igmarkies/Enviroment-System/PCB/Meetmodule V2.8/Meetmodule V3 Top-display.jpg

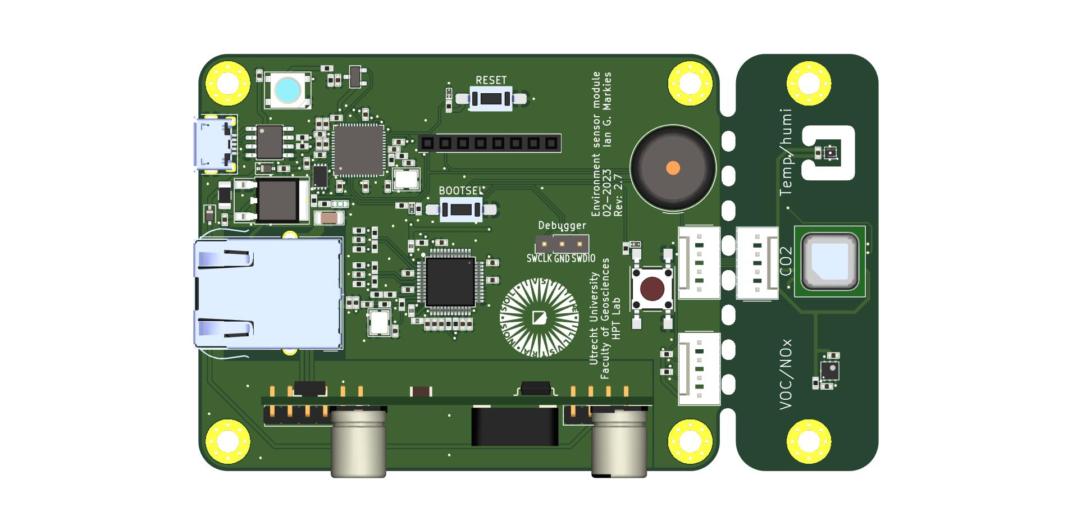
PCB/Meetmodule V2.8/Meetmodule V3 Top-display.jpg
