igmarkies/Enviroment-System/README.txt

The codes in the folder "Final" are the latest version.
The file "network.py" and "ssd1306.py" is not of my own creation but is necassary for the function of the "main.py" code
