igmarkies/Enviroment-System/PCB/PDF Bestellijst.pdf

Index | Quantity | Part Number | Description | Unit Price | Extended Price EUR
1 | 5 256-W25Q16JVUXIQTRCT-ND | IC FLASH 16MBIT SPI/QUAD 8USON | 0,57 | 2,85
2 | 5 2648-SC0914(13)CT-ND | RP2040TR13 | 0,96 | 4,8
3 | 5 2N7002NCT-ND | MOSFET N-CH 60V 115MA SOT-23 | 0,37 | 1,85
4 | 5 1278-W5100S-LCT-ND | IC ETHERNET CNTRLR SPI 48LQFP | 3,58 | 17,9
5 | 5 SER4211CT-ND | CRYSTAL 25.0000MHZ 18PF SMD | 0,41 | 2,05
6 | 5 2057-MCR-B-S-RA-SMT-CS14-T/RCT-ND | MICRO USB, RIGHT ANGLE, SURFACE | 0,38 | 1,9
7 | 5 3997-C3E-12.000-18-1020-X-RCT-ND | CRYSTAL 12MHZ 18PF SMD | 0,42 | 2,1
8 | 5 1649-SHT41-AD1B-R2CT-ND | SENSOR HUMID/TEMP | 3,124 | 15,62
9 | 5 535-14168-ND | CONN JACK 1PORT 100 BASE-T PCB | 3,34 | 16,7
10 | 5 1497-1448-1-ND | LED RED CLEAR CHIP SMD | 0,49 | 2,45
11 | 10 CKN12317-1-ND | TACT 6.0 X 3.5, 4.3 MM H, 180GF, | 0,14 | 1,4
12 | 15 445-2981-1-ND | FERRITE BEAD 120 OHM 0402 1LN | 0,073 | 1,1
13 | 5 4587-C1206X102K202TCT-ND | CAP CER 1000PF 2KV X7R 1206 | 0,16 | 0,8
14 | 5 497-3281-1-ND | TVS DIODE 5.25VWM 8-SO | 1,68 | 8,4
15 | 15 SZESD9B3.3ST5GOSCT-ND | TVS DIODE 3.3VWM 11.5VC SOD923 | 0,288 | 4,32
16 | 10 BAT60AE6327HTSA1CT-ND | DIODE SCHOTTKY 10V 3A SOD323-2 | 0,394 | 3,94
17 | 5 1649-SGP41-D-R4CT-ND | AIR QUALITY GAS SENSOR VOC/NO | 8,318 | 41,59
18 | 5 1568-COM-16347CT-ND | SMD LED RGB WS2812B | 0,56 | 2,8
19 | 5 486-3690-ND | SWITCH TACTILE SPST-NO 0.05A 12V | 0,24 | 1,2
20 | 5 541-4.70LCT-ND | RES SMD 4.7 OHM 1% 1/16W 0402 | 0,1 | 0,5
21 | 20 13-AF0402FR-0749R9LCT-ND | RES SMD 49.9 OHM 1% 1/16W 0402 | 0,051 | 1,02
22 | 5 RMCF0402ZT0R00CT-ND | RES 0 OHM JUMPER 1/16W 0402 | 0,1 | 0,5
23 | 5 13-RT0402FRE07300RLCT-ND | RES SMD 300 OHM 1% 1/16W 0402 | 0,1 | 0,5
24 | 5 541-CRCW04021M00FKEECT-ND | RES SMD 1M OHM 1% 1/16W 0402 | 0,1 | 0,5
25 | 20 311-3.30LRCT-ND | RES 3.3 OHM 1% 1/16W 0402 | 0,021 | 0,42
26 | 5 13-AF0402FR-0712KLCT-ND | RES SMD 12K OHM 1% 1/16W 0402 | 0,1 | 0,5
27 | 10 YAG1254CT-ND | RES SMD 1K OHM 1% 1/16W 0402 | 0,03 | 0,3
28 | 15 13-AF0402FR-07470RLCT-ND | RES SMD 470 OHM 1% 1/16W 0402 | 0,051 | 0,77
29 | 5 541-CRCW0402100KFKEECT-ND | RES SMD 100K OHM 1% 1/16W 0402 | 0,1 | 0,5
30 | 5 311-200KLRCT-ND | RES 200K OHM 1% 1/16W 0402 | 0,1 | 0,5
31 | 10 YAG5278CT-ND | RES SMD 27 OHM 1% 1/16W 0402 | 0,018 | 0,18
32 | 125 311-1731-1-ND | CAP CER 0.1UF 10V X5R 0402 | 0,0093 | 1,16
33 | 10 490-13238-1-ND | CAP CER 10UF 6.3V X5R 0402 | 0,11 | 1,1
34 | 10 732-7426-1-ND | CAP CER 15PF 10V C0G/NP0 0402 | 0,018 | 0,18
35 | 35 587-6273-1-ND | CAP CER 1UF 6.3V X5R 0402 | 0,033 | 1,16
36 | 10 720-VJ0402A180KXQCW1BCCT-ND | CAP CER 18PF 10V C0G/NP0 0402 | 0,079 | 0,79
37 | 5 668-1470-ND | BUZZER MAGNETIC 5V 12MM TH | 0,53 | 2,65
38 | 15 13-AF0402FR-07100RLCT-ND | RES SMD 100 OHM 1% 1/16W 0402 | 0,051 | 0,77
39 | 5 NCP1117DT33GOS-ND | IC REG LINEAR 3.3V 1A DPAK | 0,73 | 3,65
40 | 5 311-4.7KLRCT-ND | RES 4.7K OHM 1% 1/16W 0402 | 0,1 | 0,5
Totaal | | | | | 151,92
