igmarkies/Enviroment-System/PCB/MCU.png

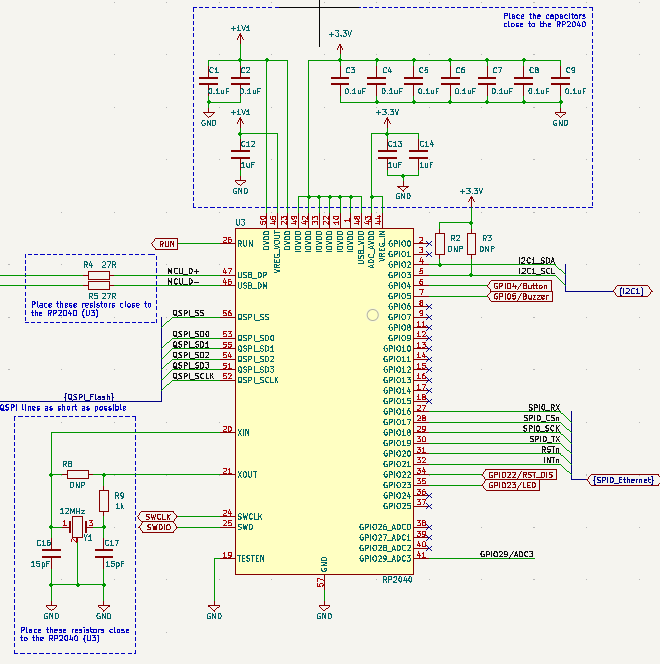
PCB/MCU.png
