igmarkies/Enviroment-System/PCB/Meetmodule case/Meetmodule V3 Top.jpg

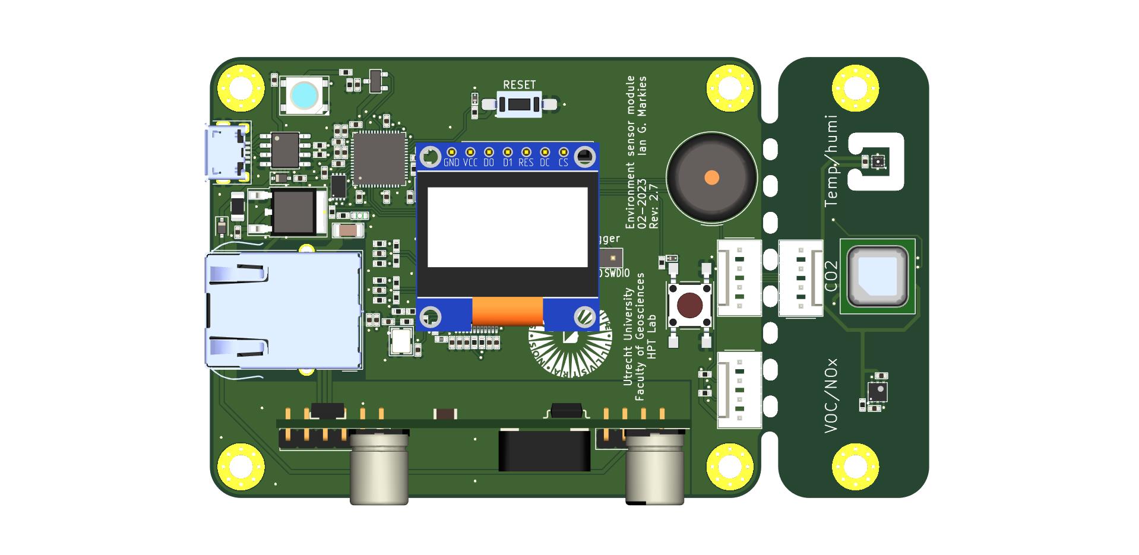
PCB/Meetmodule case/Meetmodule V3 Top.jpg
