igmarkies/Enviroment-System/Sensor module/Final/Flowcharts/Hoofdmodule.jpg

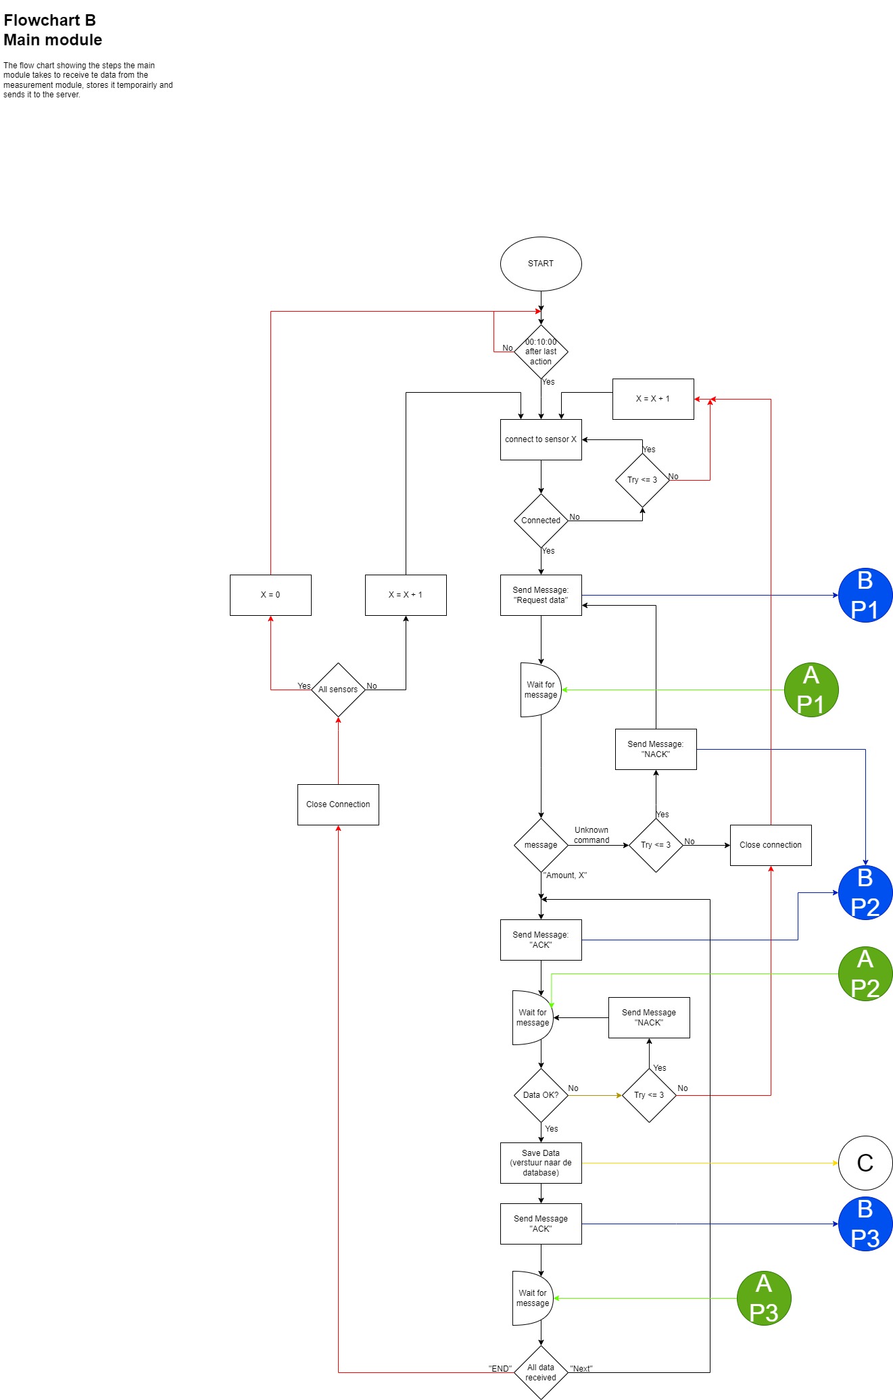
Sensor module/Final/Flowcharts/Hoofdmodule.jpg
