igmarkies/Enviroment-System/Sensor module/Final/Flowcharts/Meetmodule.jpg

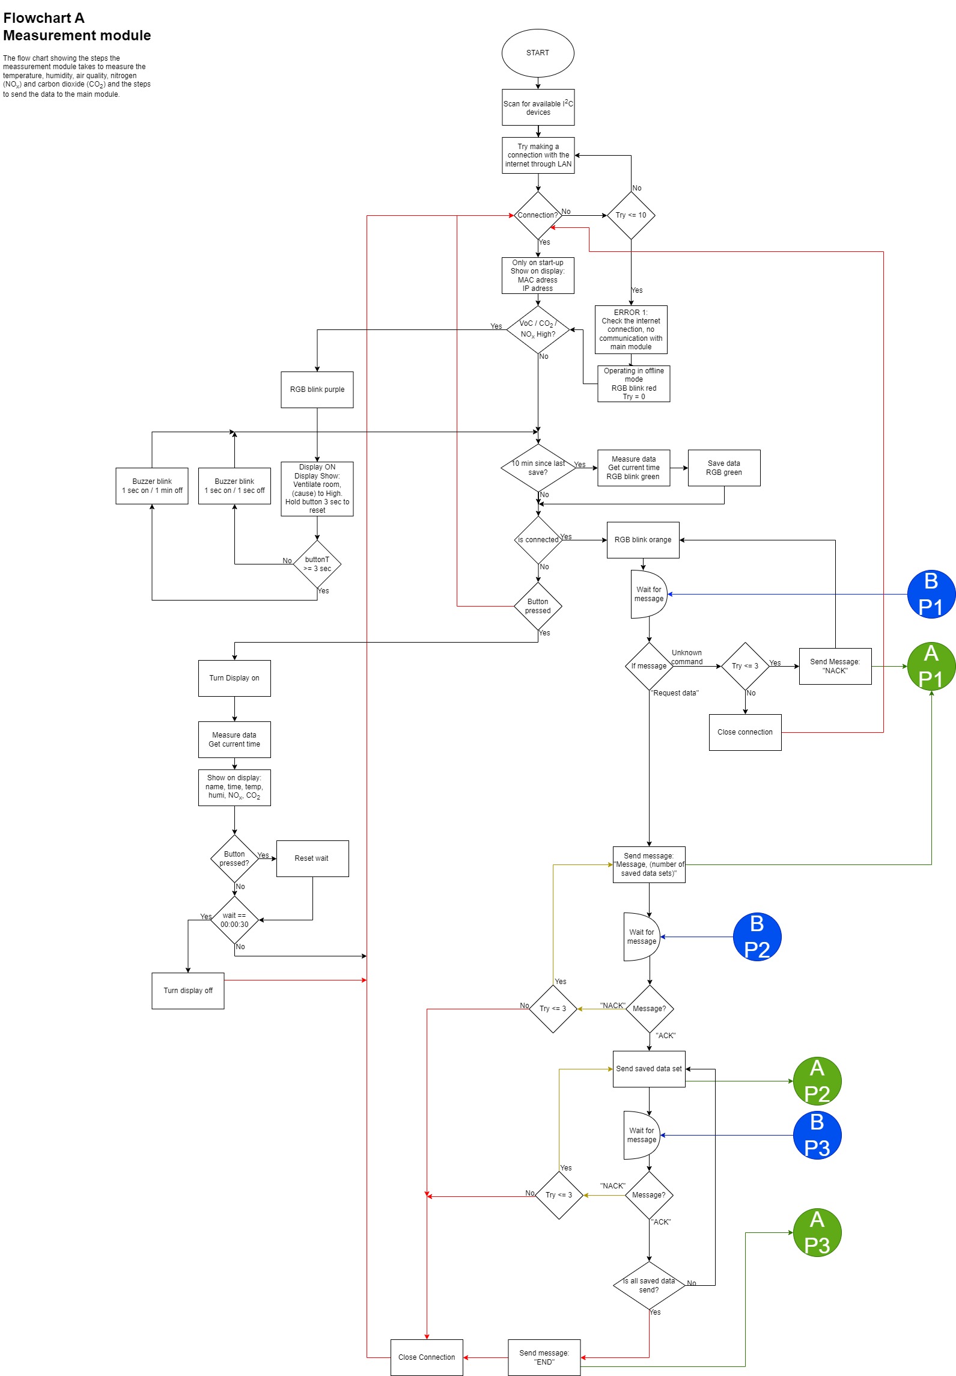
Sensor module/Final/Flowcharts/Meetmodule.jpg
