igmarkies/Enviroment-System/PCB/Meetmodule case/Meetmodule sensorcase.step

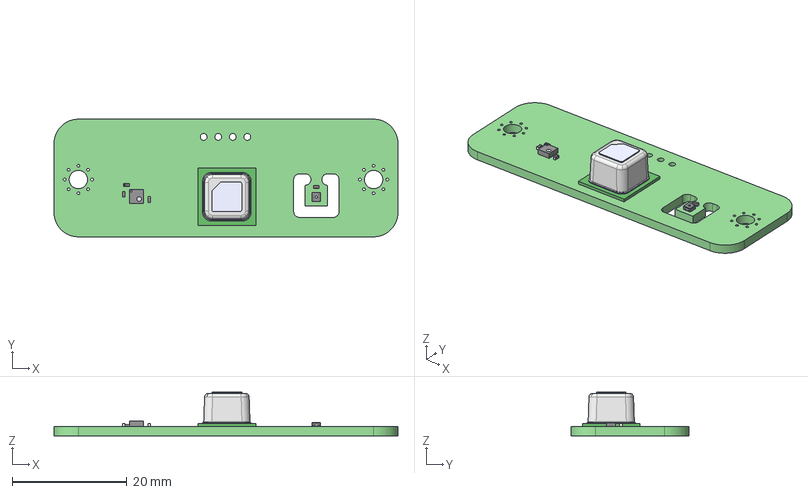
[picture p6: CAD file, 2023-08-22]
PCB/Meetmodule case/Meetmodule sensorcase.step
60.0 x 20.5 x 7.67 mm
_autosave-Meetmodule V3 PCB
