igmarkies/Enviroment-System/PCB/Meetmodule large display V2.4/Meetmodule large display V2.4.step

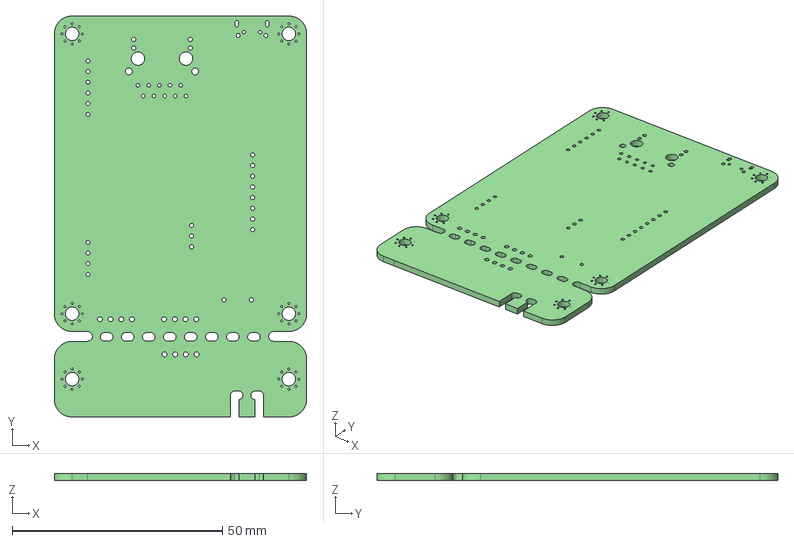
[picture p7: CAD file, 2023-08-22, an earlier design]
PCB/Meetmodule large display V2.4/Meetmodule large display V2.4.step
60.0 x 95.3 x 1.64 mm
