igmarkies/Enviroment-System/Main module/Gegevens huidige installatie hoofdmodule.txt

Hoofdmodule
Gebruikersnaam: rock
Wachtwoord: rock

MySQL
Gebruikersnaa: HPTuser
wachtwoord: Pr3Ssure#h19h

Wordpress
gebruikersnaam: HPT-admin
Wachtwoord: W0rD#49i^HPT
