igmarkies/Enviroment-System/Sensor module/Final/Flowcharts/Ontwerp Hoofdmodule A3.pdf

# Flowchart B Main module

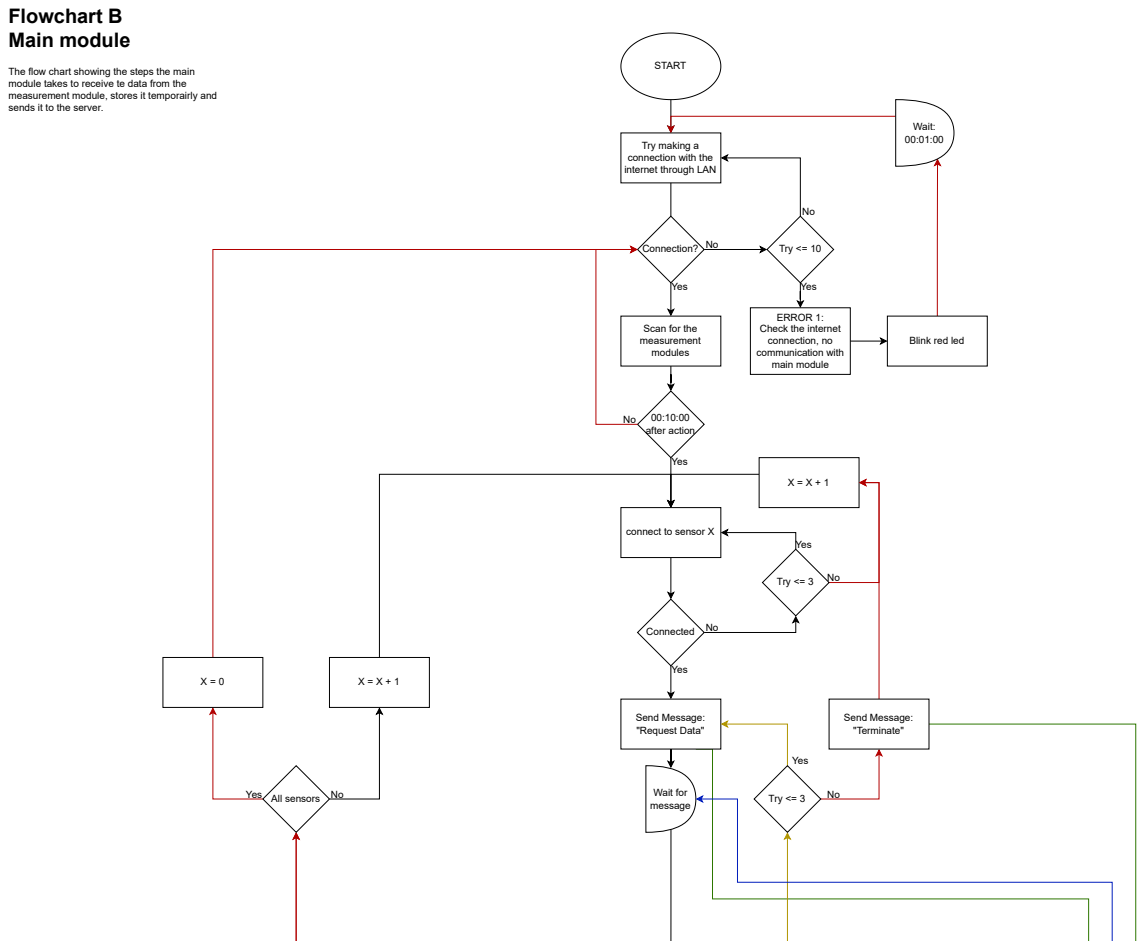
[picture p8: page 1]
START; Yes; Connection?; Try <= 10; 00:10:00 after action; Connected; Try <= 3; Send Message: "Request Data"; Wait for message; Send Message: "Terminate"; Wait: 00:01:00; All sensors

The flow chart showing the steps the main
module takes to receive te data from the
measurement module, stores it temporairly and
sends it to the server.

Try making a
connection with the
internet through LAN

ERROR 1:
Check the internet
connection, no
communication with
main module

Scan for the
measurement
modules

Blink red led

connect to sensor X

A

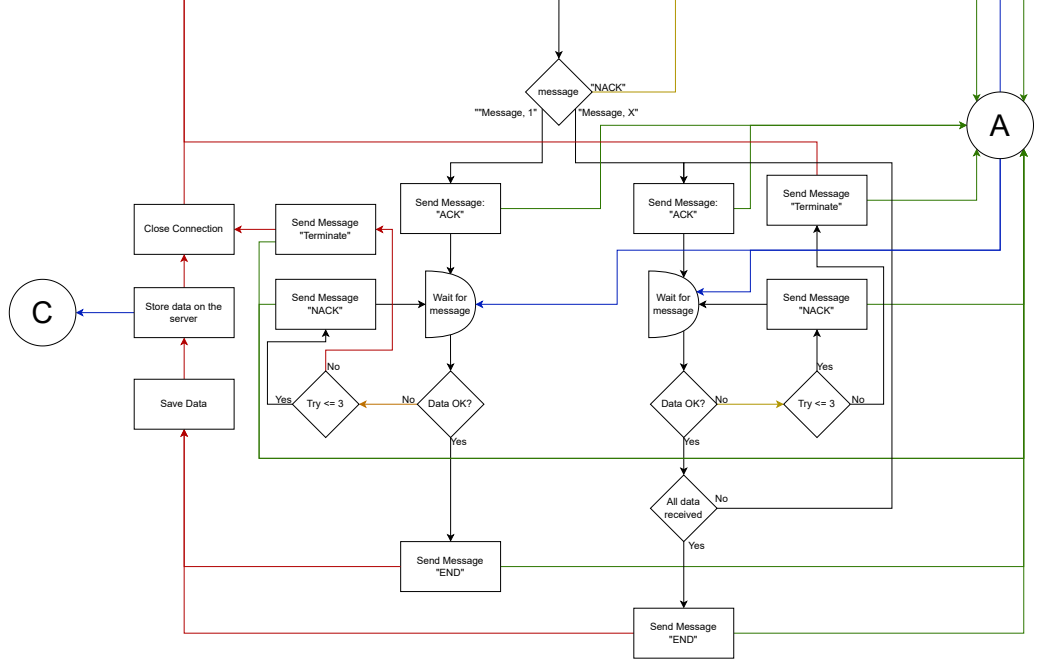
[picture p9: page 2]
message; Send Message: "ACK"; ""Message, 1"; "Message, X"; "NACK"; Wait for message; Data OK?; Send Message "NACK"; Try <= 3; Yes; Send Message; Send Message "END"; Send Message "Terminate"; All data received; Save Data; Store data on the C; server

"Terminate" Close Connection
