igmarkies/Enviroment-System/Sensor module/Final/Flowcharts/Ontwerp Meetmodule A3.pdf

# Flowchart A Measurement module

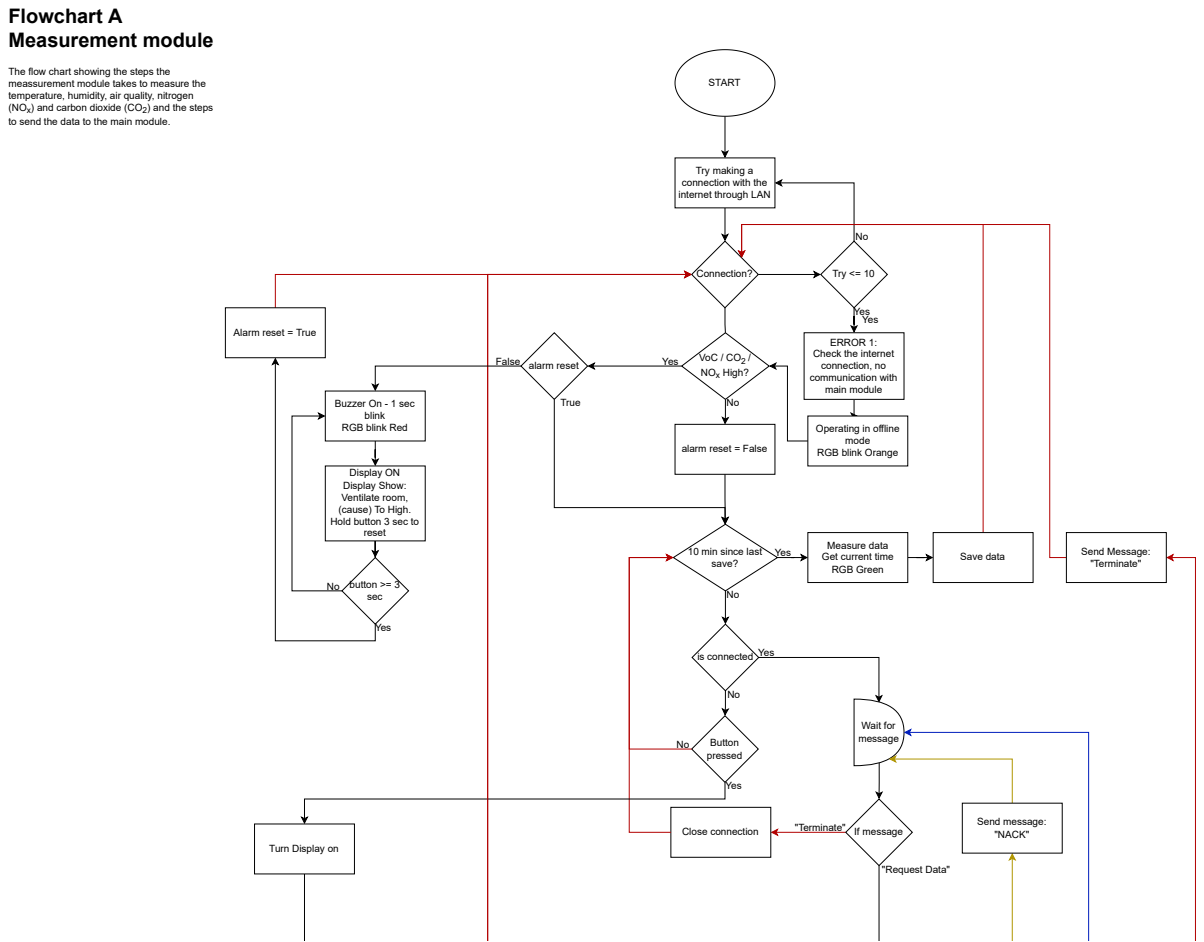
[picture p10: page 1]
START; Button pressed; Yes; Wait for message; If message; "Request Data"; Close connection; "Terminate"; Connection?; Try <= 10; Send Message: "Terminate"; Save data; is connected; button >= 3 sec; reset; alarm reset; True; False; VoC / CO2; / NOx High?; Send message: "NACK"

The flow chart showing the steps the
meassurement module takes to measure the
temperature, humidity, air quality, nitrogen
(NOx
to send the data to the main module.

) and carbon dioxide (CO2

) and the steps

Try making a
connection with the
internet through LAN

Alarm reset = True

ERROR 1:
Check the internet
connection, no
communication with
main module

Buzzer On - 1 sec
blink
RGB blink Red

Operating in offline
mode
RGB blink Orange

alarm reset = False

Display ON
Display Show:
Ventilate room,
(cause) To High.
Hold button 3 sec to

Measure data
Get current time
RGB Green

10 min since last
save?

Turn Display on

B

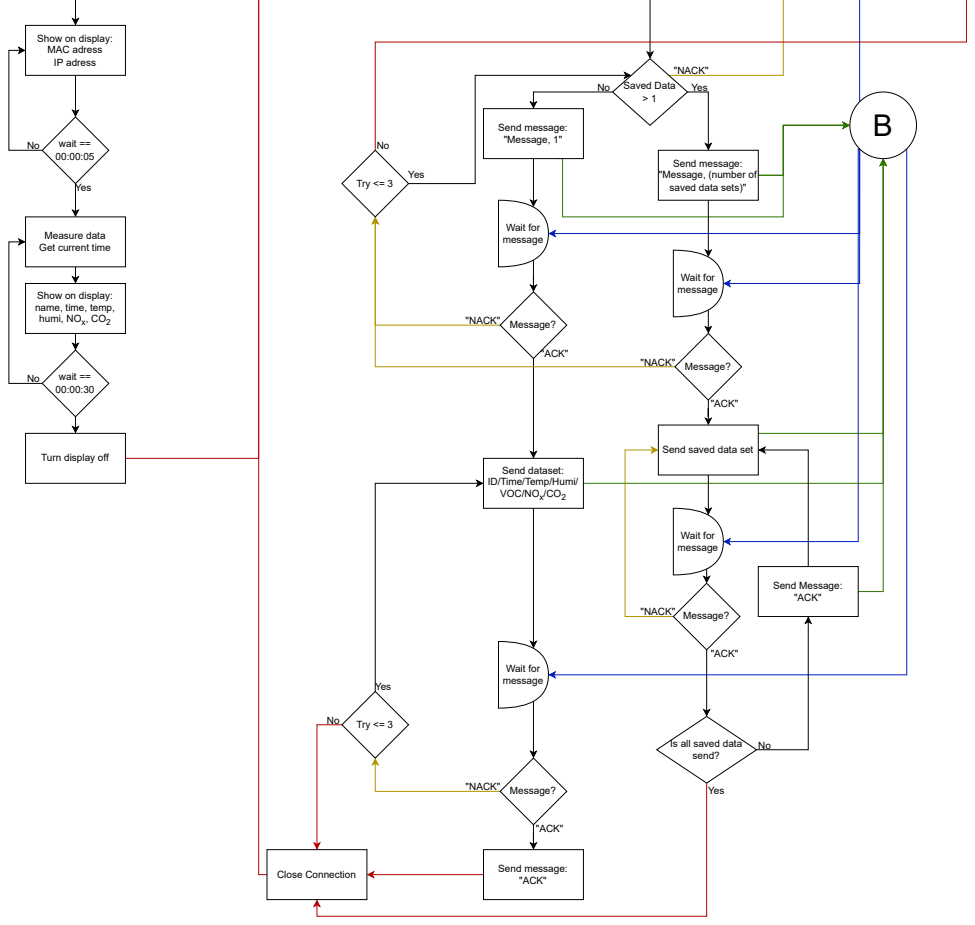
[picture p11: page 2]
Saved Data > 1; Send message: "Message, 1"; Yes; Message?; "ACK"; Message? "NACK"; Try <= 3; "NACK"; Send message: "ACK"; Close Connection; wait == 00:00:05; wait == 00:00:30; Send Message: "ACK"; Wait for message

Show on display:
MAC adress
IP adress

Send message:
"Message, (number of
saved data sets)"

Measure data
Get current time

name, time, temp,
humi, NOx

Send saved data set

Turn display off

Send dataset:
ID/Time/Temp/Humi/
VOC/NOx

Is all saved data
send?
