igmarkies/Enviroment-System/PCB/Meetmodule case/PCB design large.pdf

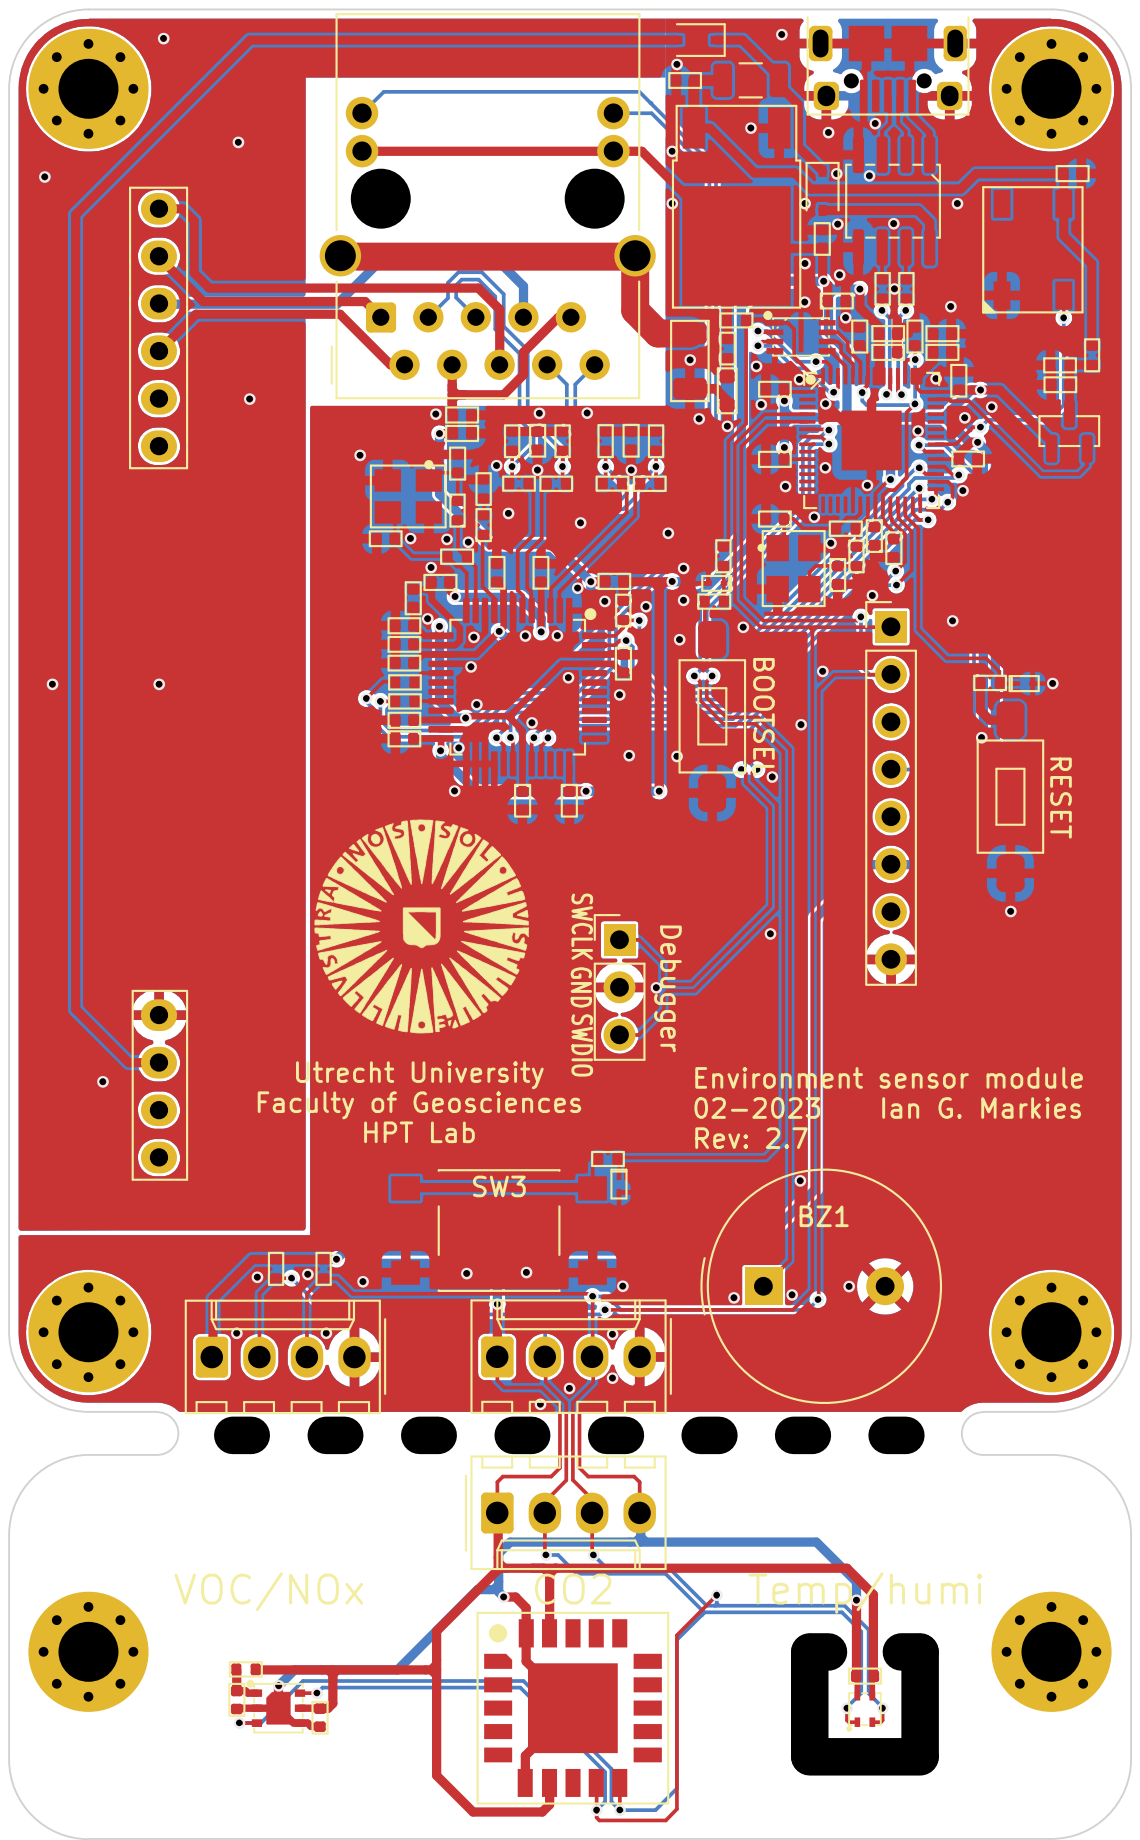
[picture p20: page 1]
