igmarkies/Enviroment-System/PCB/Meetmodule case/PCB design.pdf

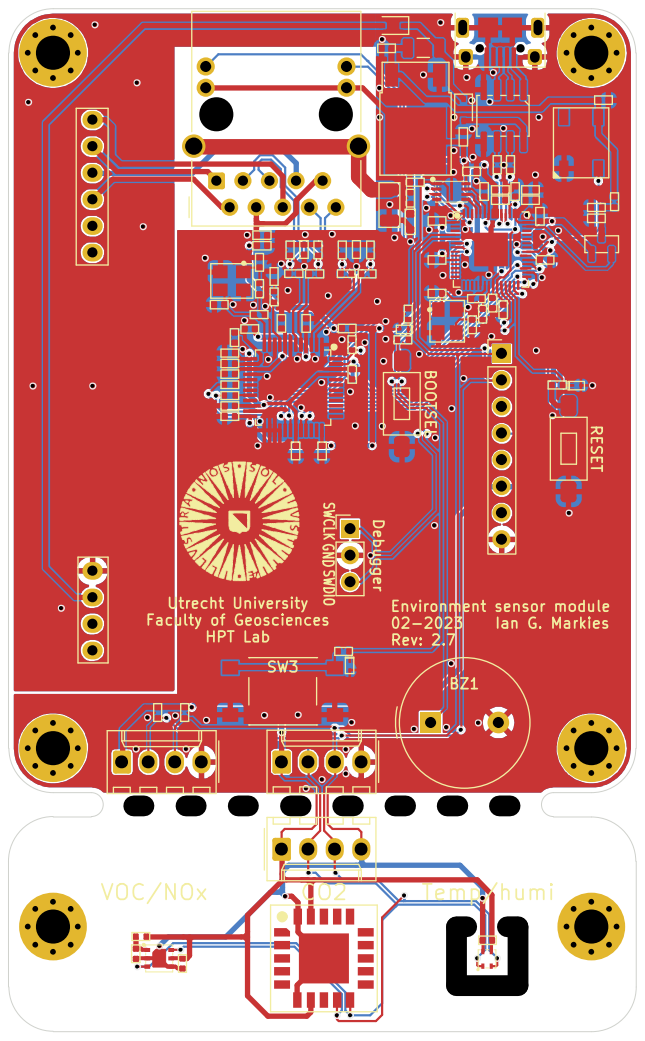
[picture p21: page 1]
