igmarkies/Enviroment-System/PCB/PCB V2 merge.pdf

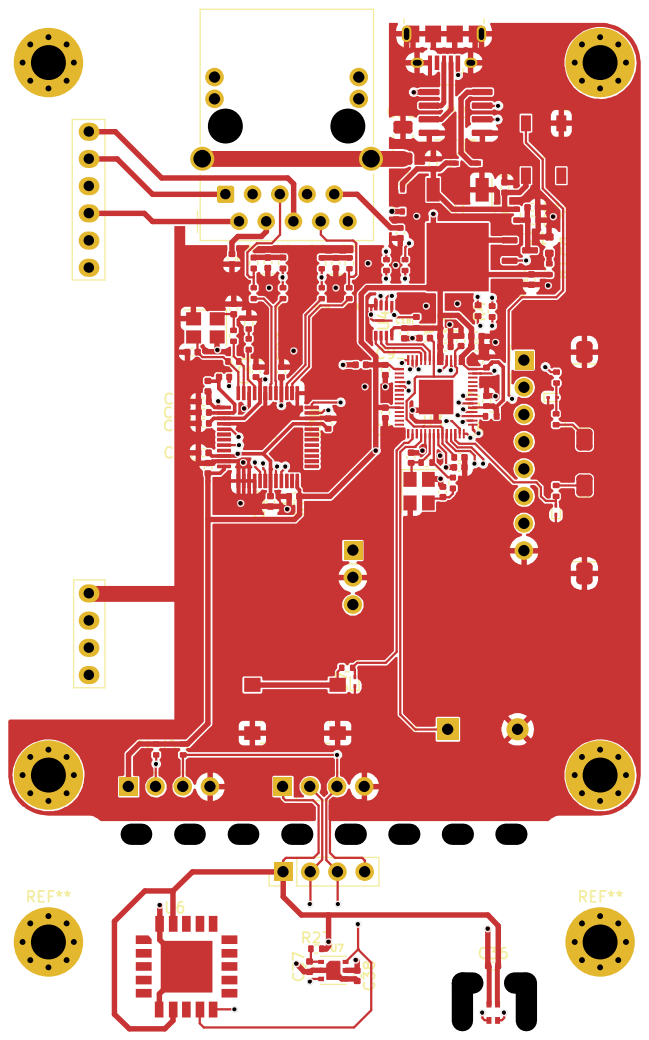
[picture p22: page 1]

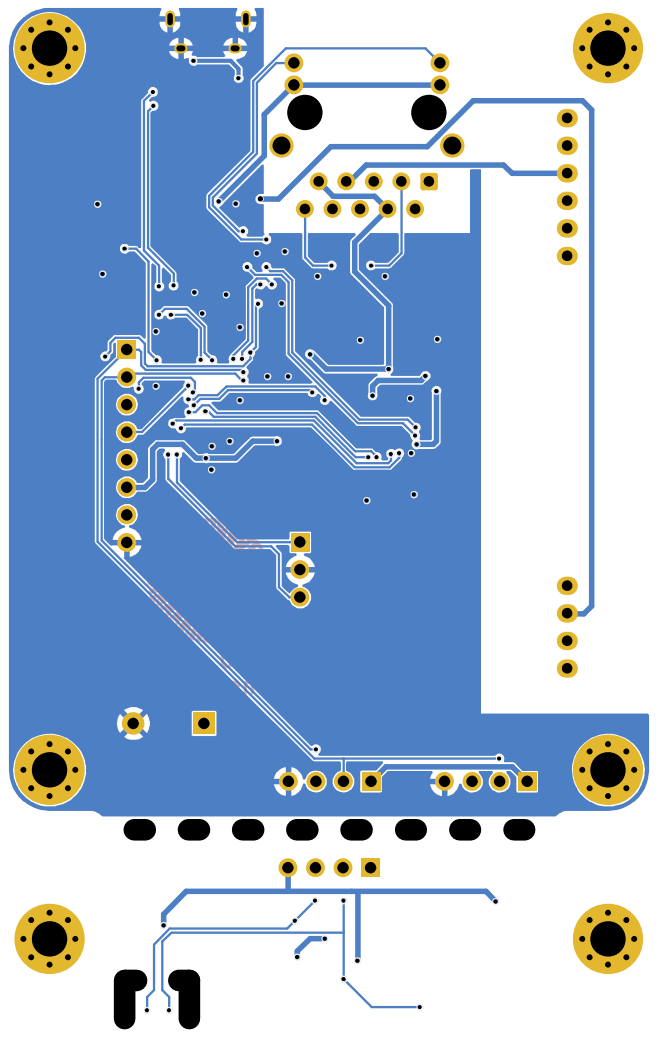
[picture p23: page 2]
