igmarkies/Enviroment-System/PCB/PCB V2.2 all.pdf

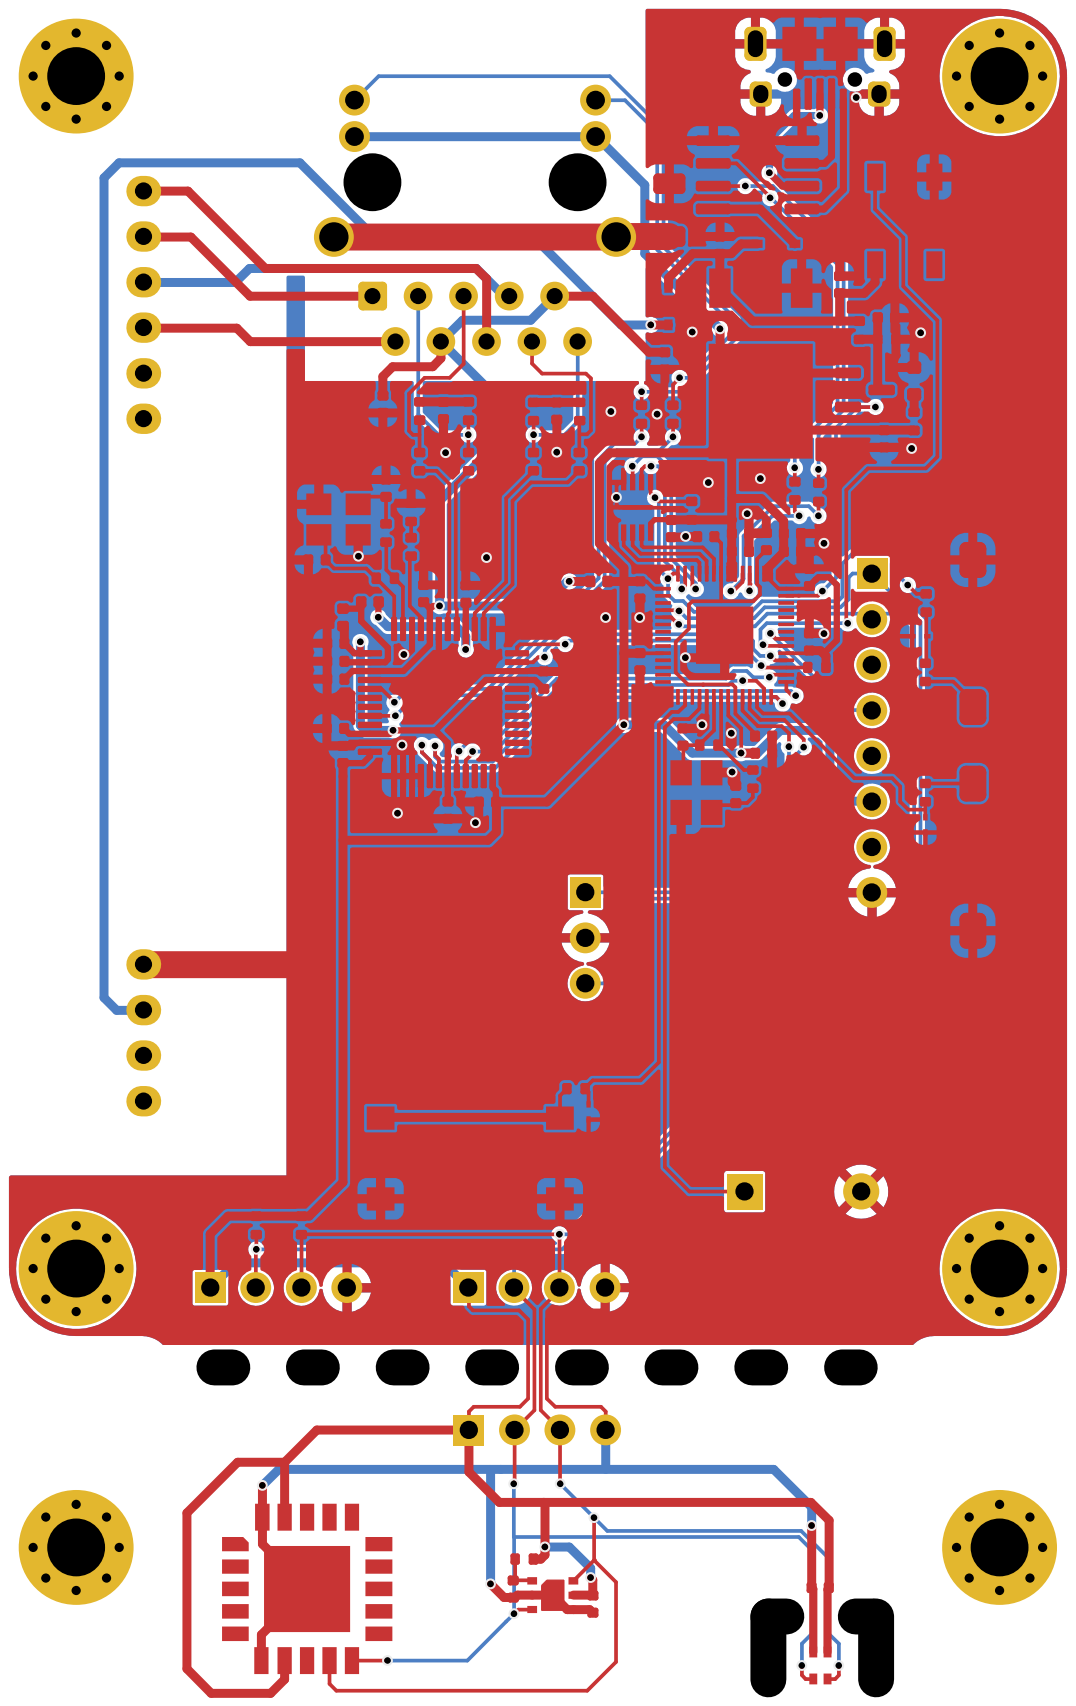
[picture p24: page 1]
