igmarkies/Enviroment-System/PCB/PCB V2.2 Back.pdf

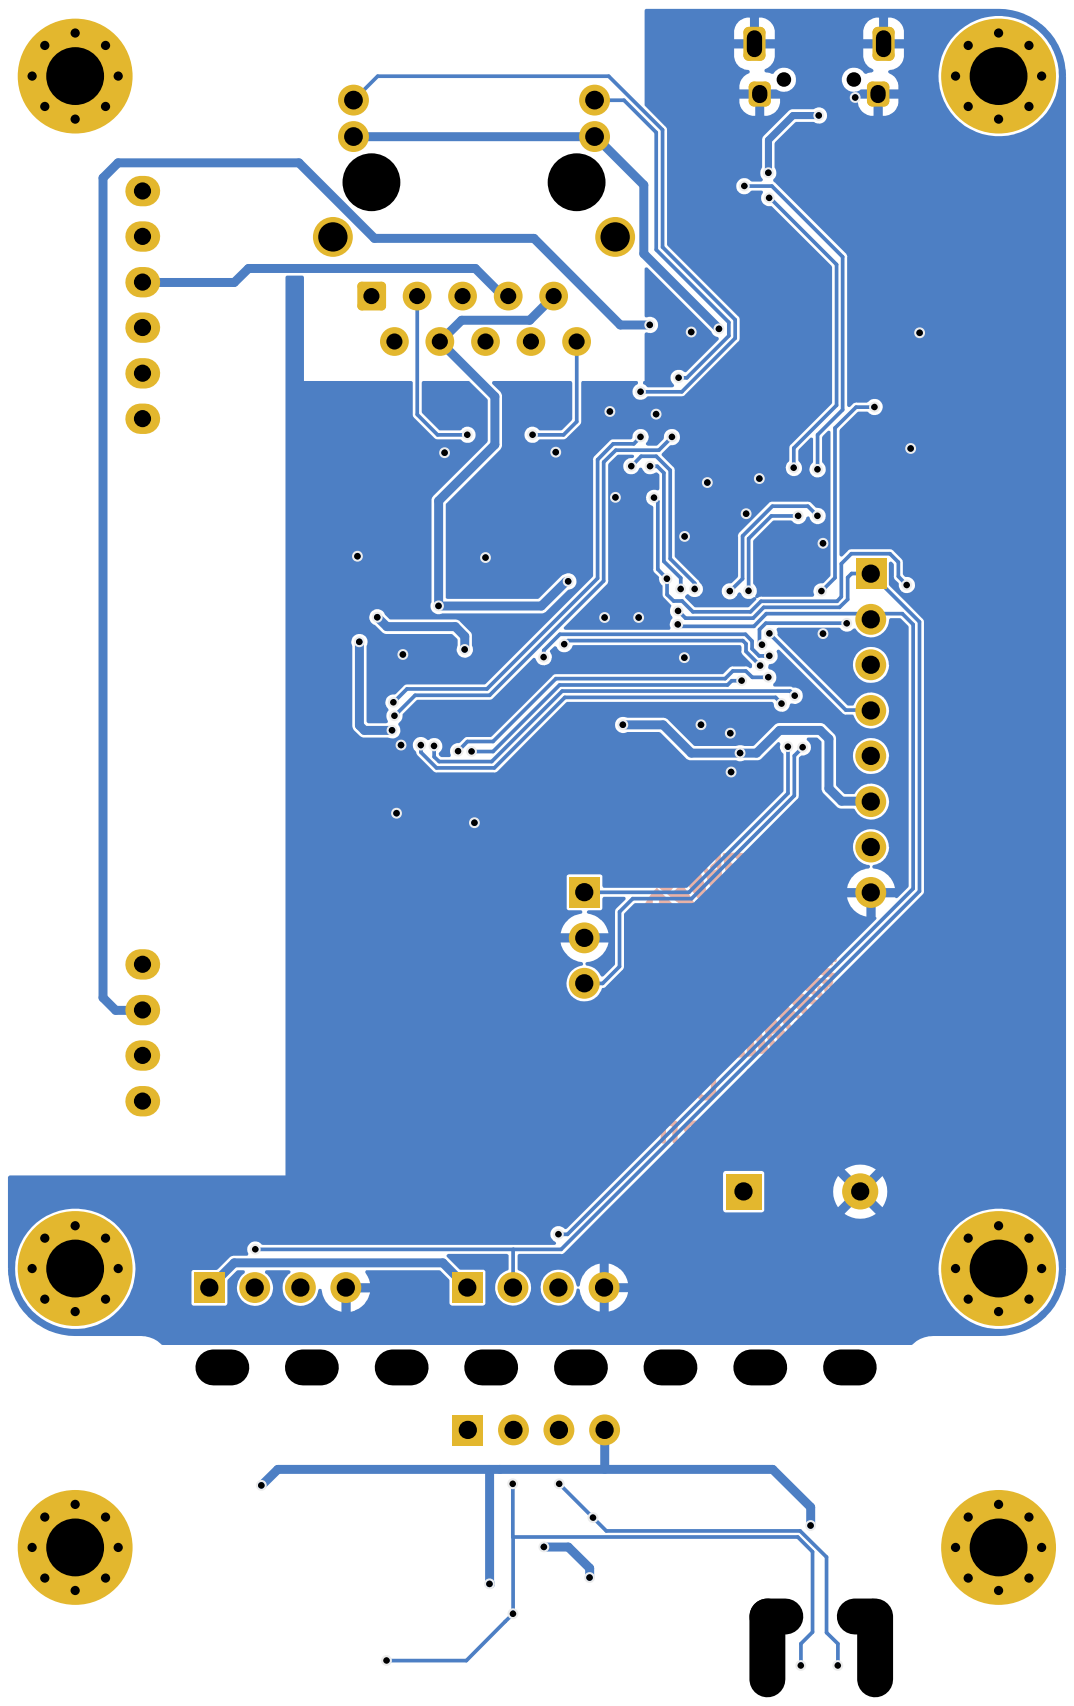
[picture p25: page 1]
