igmarkies/Enviroment-System/PCB/PCB V2.2 merged.pdf

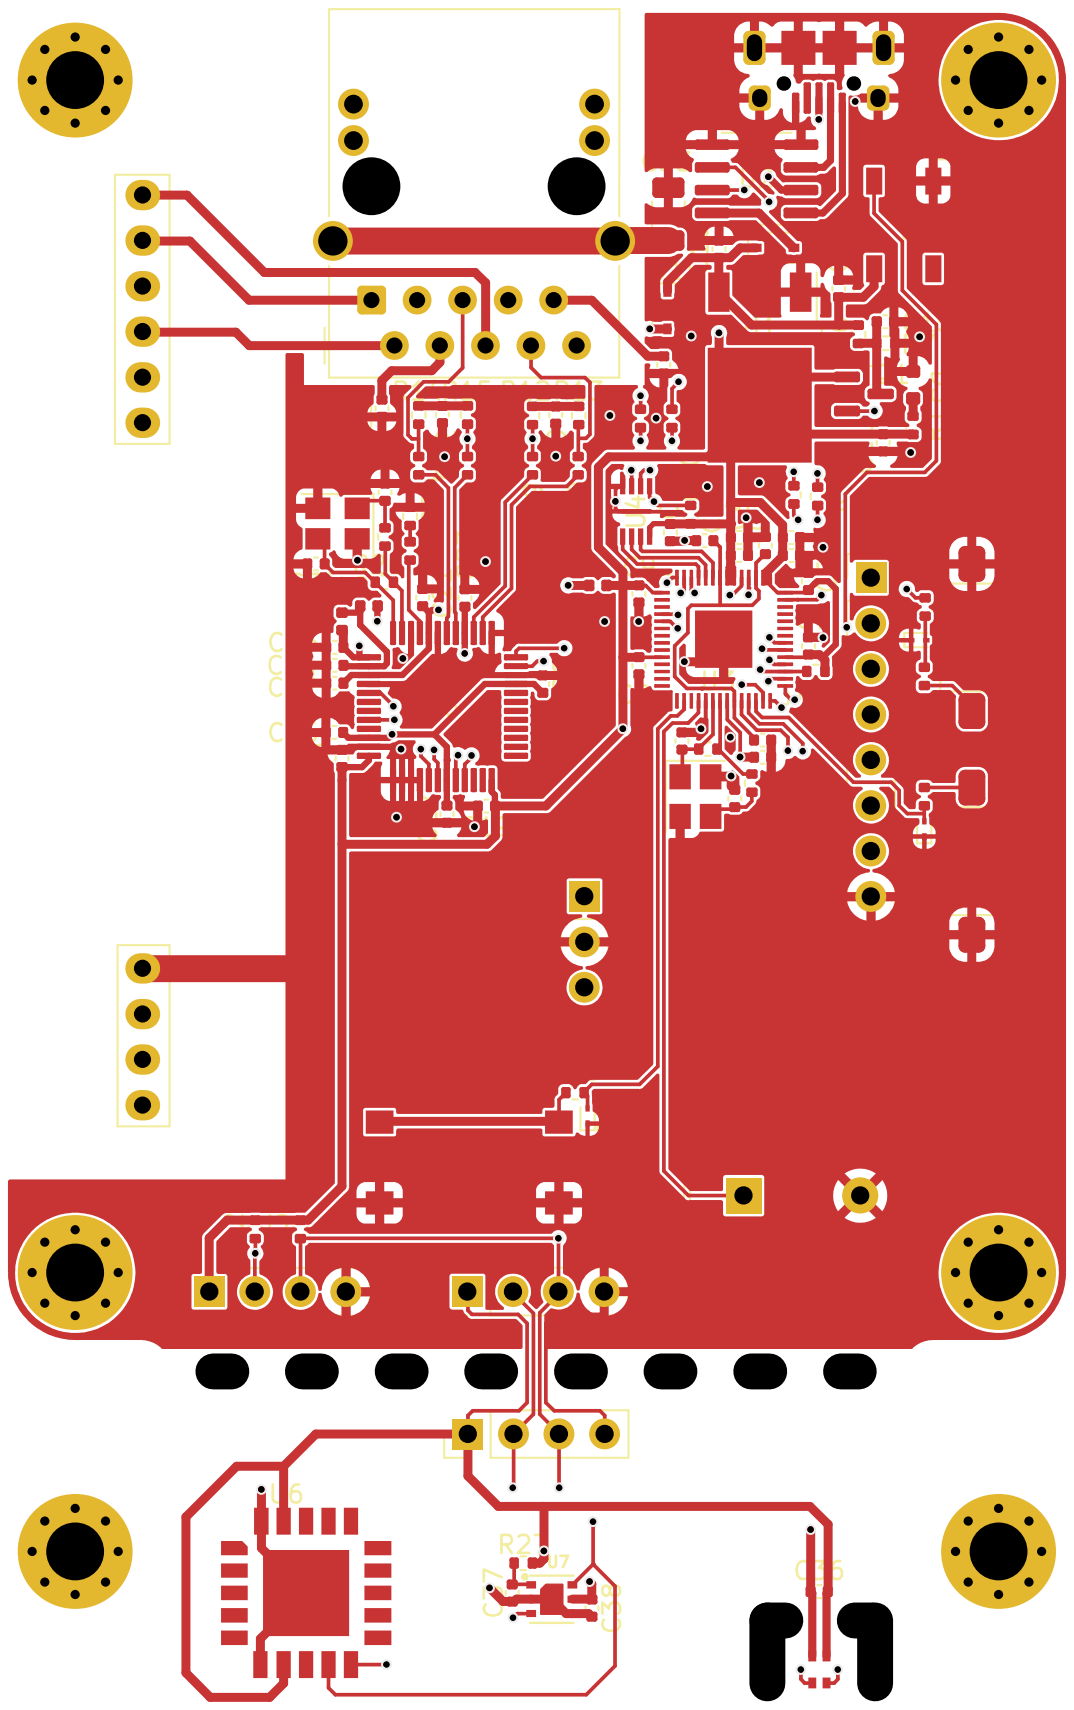
[picture p26: page 1]
