igmarkies/Enviroment-System/PCB/PCB.pdf

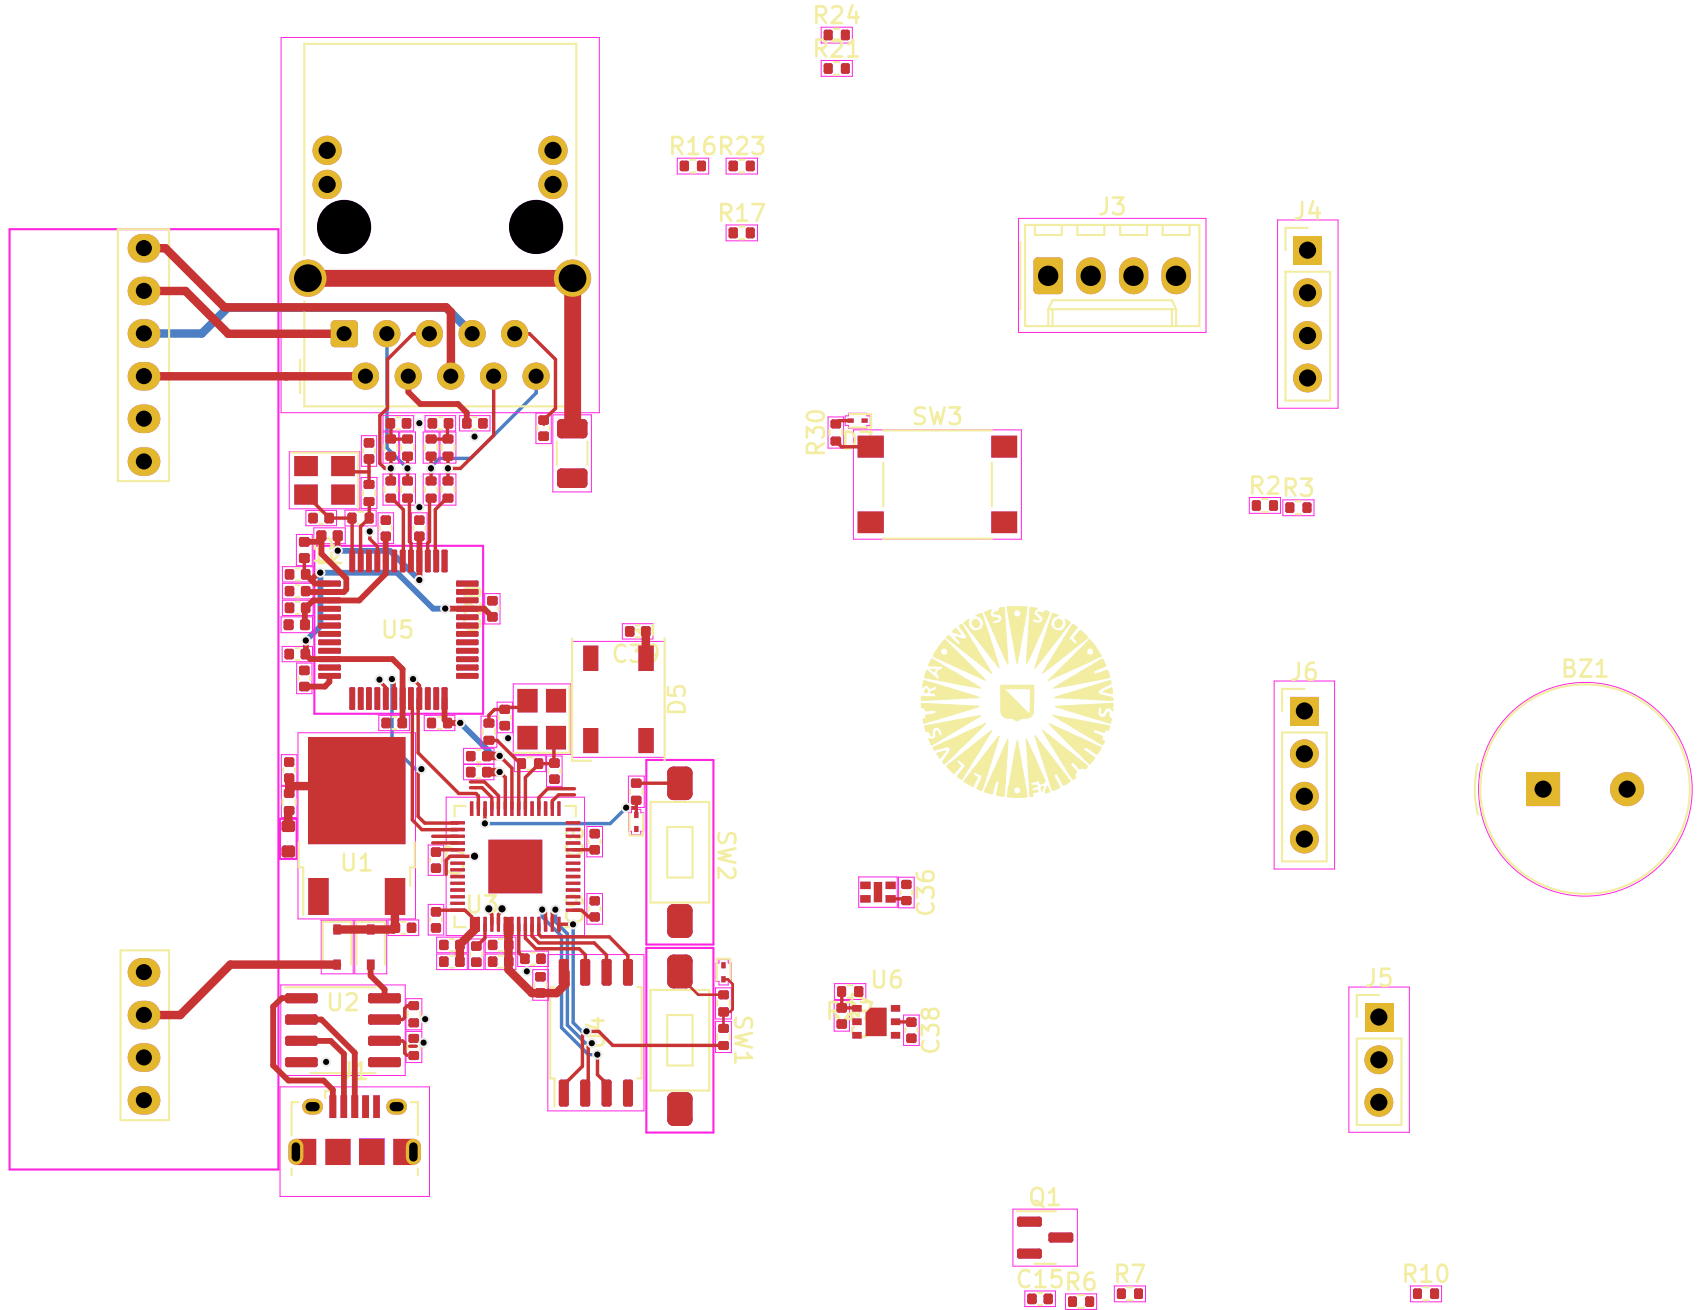
[picture p27: page 1]
