igmarkies/Enviroment-System/PCB/Meetmodule case/B.cu V3.1.pdf

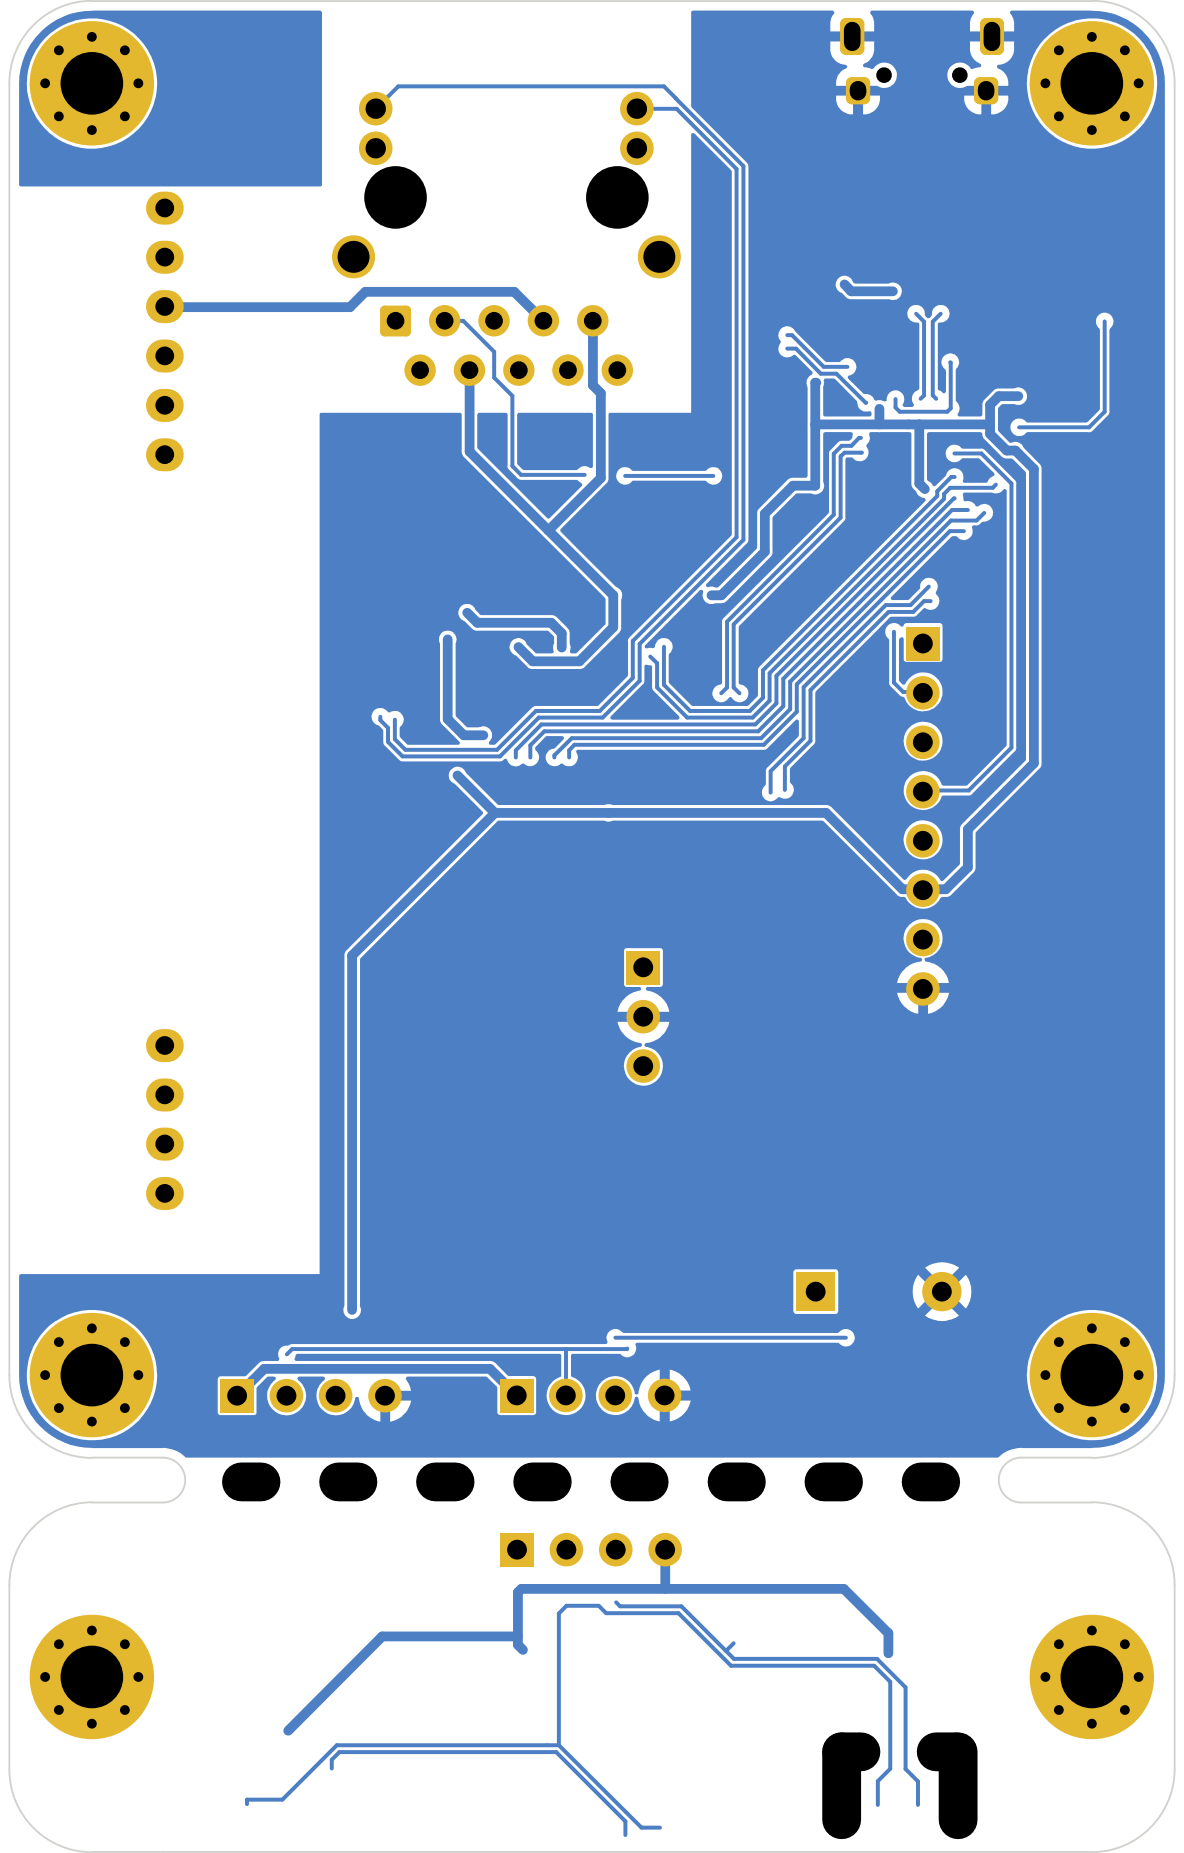
[picture p28: page 1]
