igmarkies/Enviroment-System/PCB/Meetmodule case/B.cu.pdf

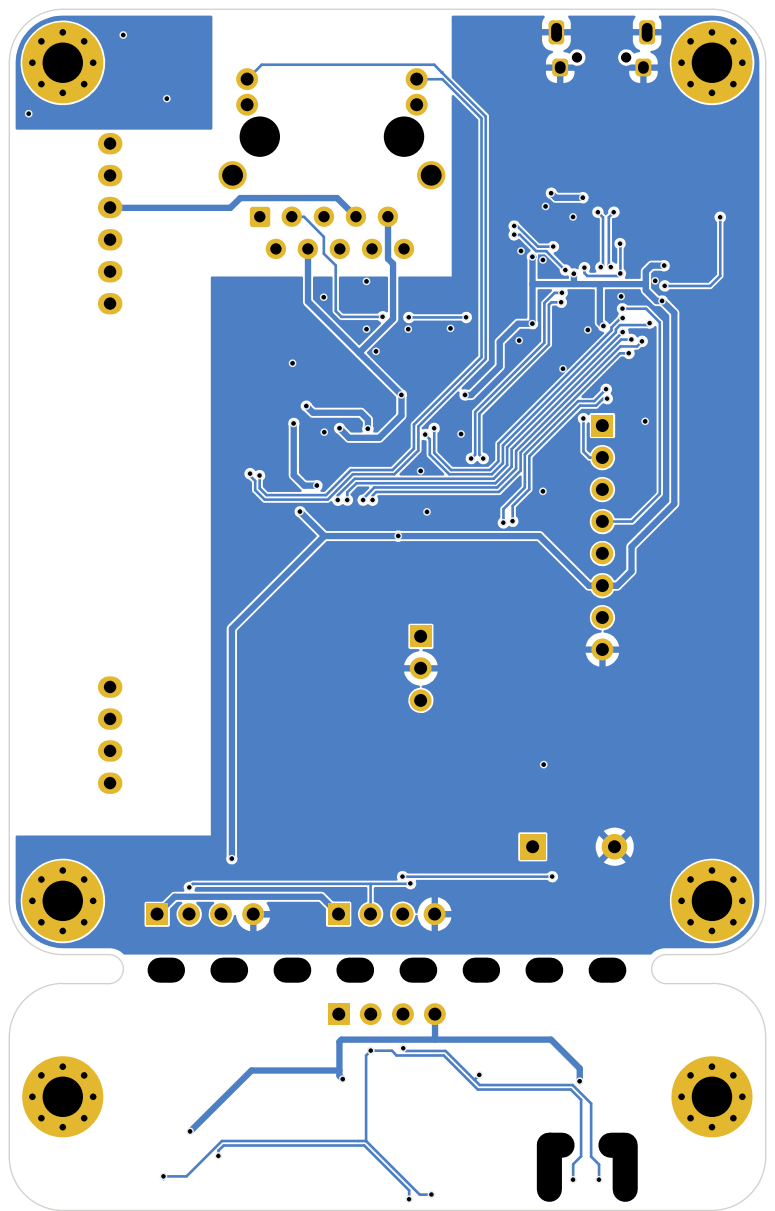
[picture p29: page 1]
