igmarkies/Enviroment-System/PCB/Meetmodule case/F.cu V3.1.pdf

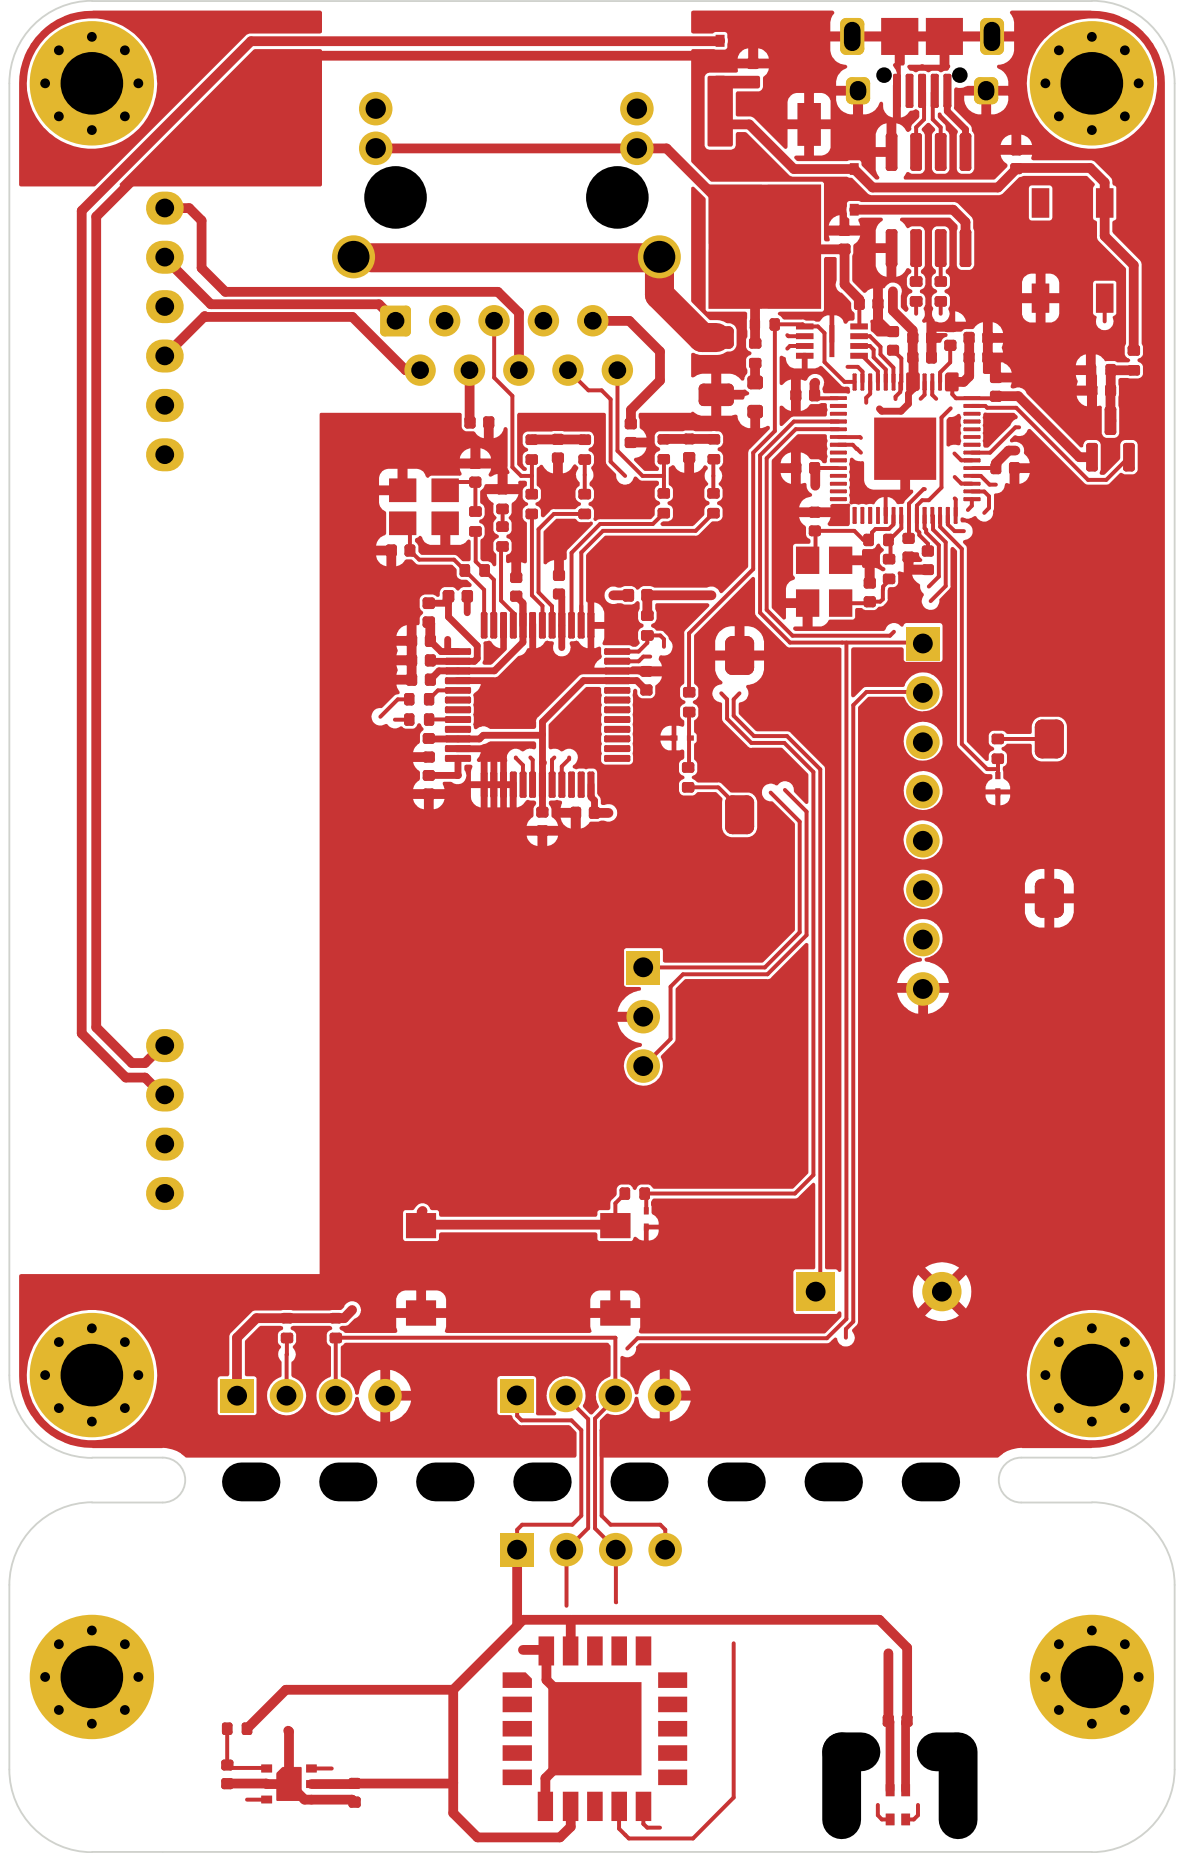
[picture p30: page 1]
