igmarkies/Enviroment-System/PCB/Meetmodule case/F.cu.pdf

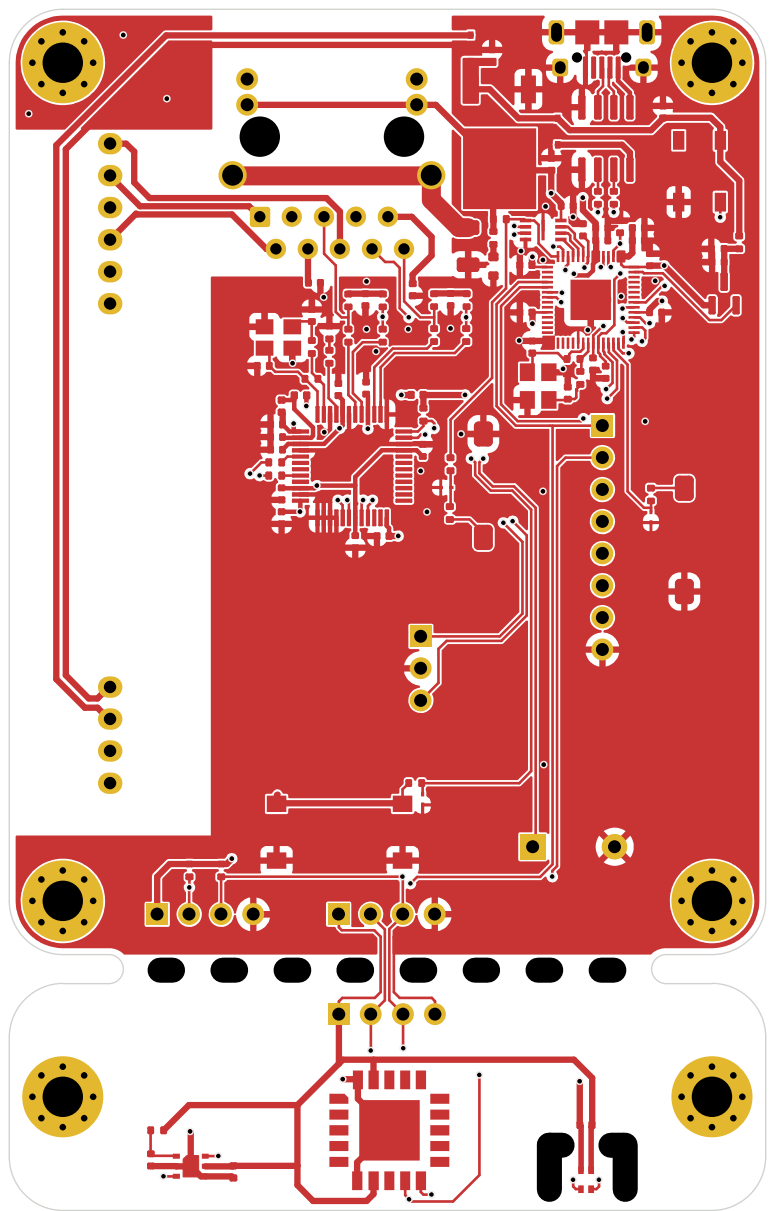
[picture p31: page 1]
