igmarkies/Enviroment-System/PCB/Meetmodule case/PCB layers V3.1.pdf

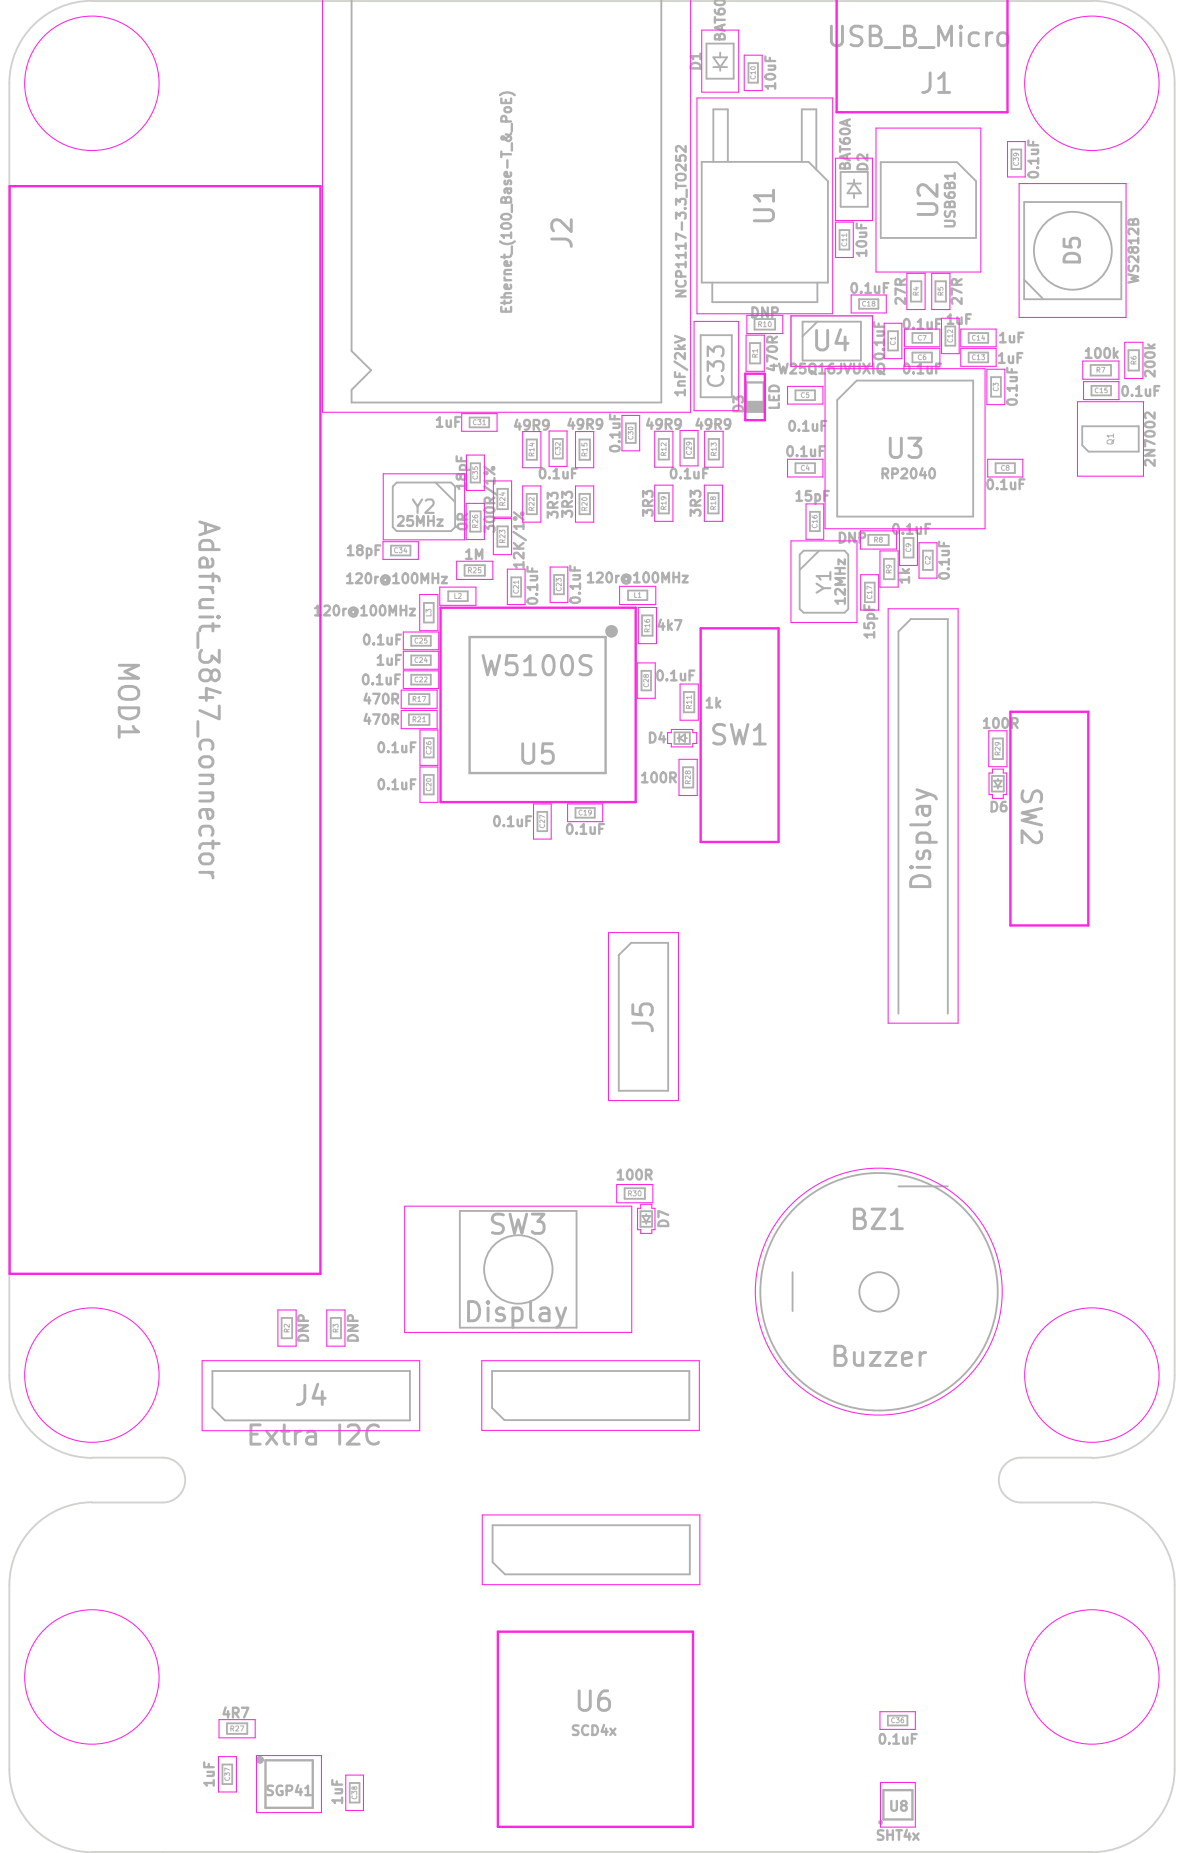
[picture p32: page 3]
