igmarkies/Enviroment-System/PCB/Meetmodule case/Placement.pdf

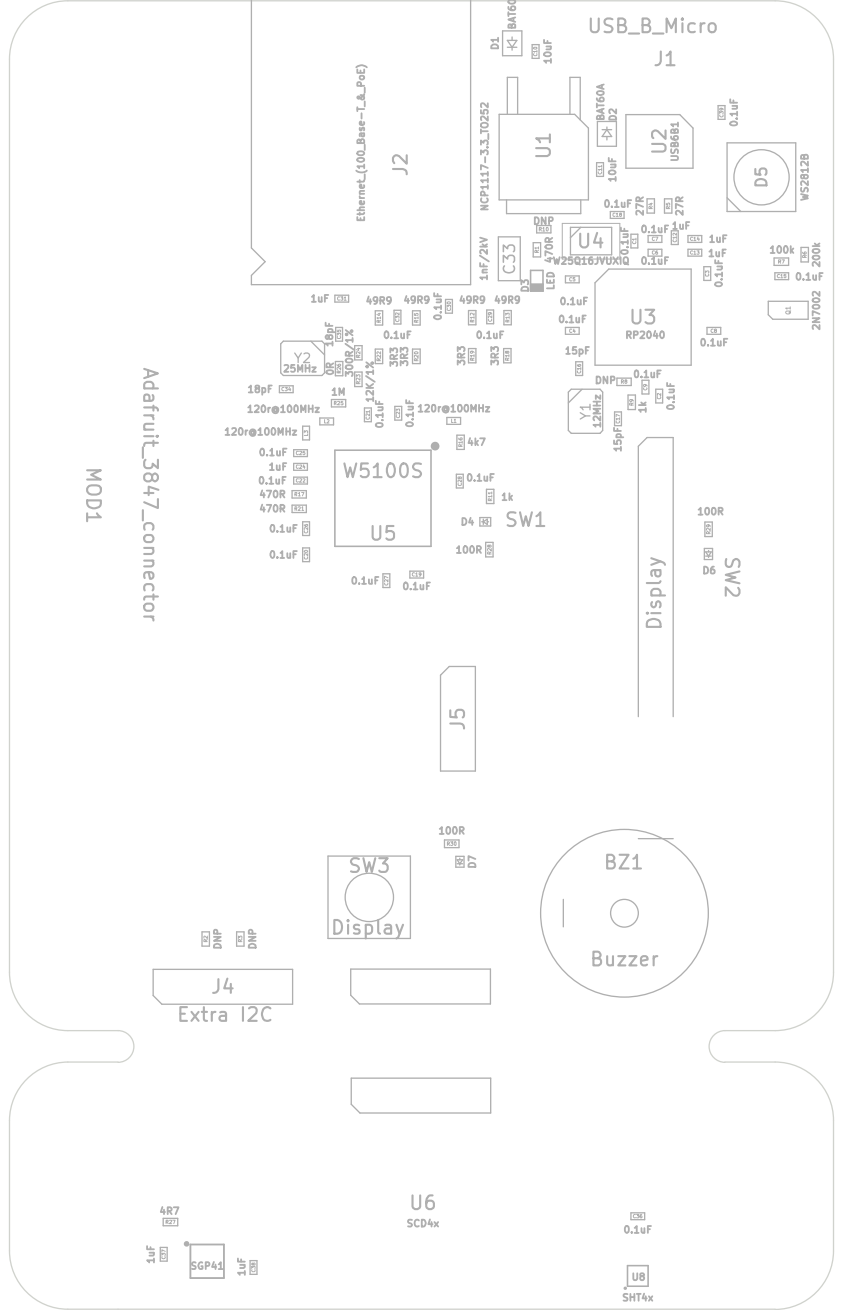
[picture p33: page 1]
