igmarkies/Enviroment-System/PCB/Meetmodule case/Silk.pdf

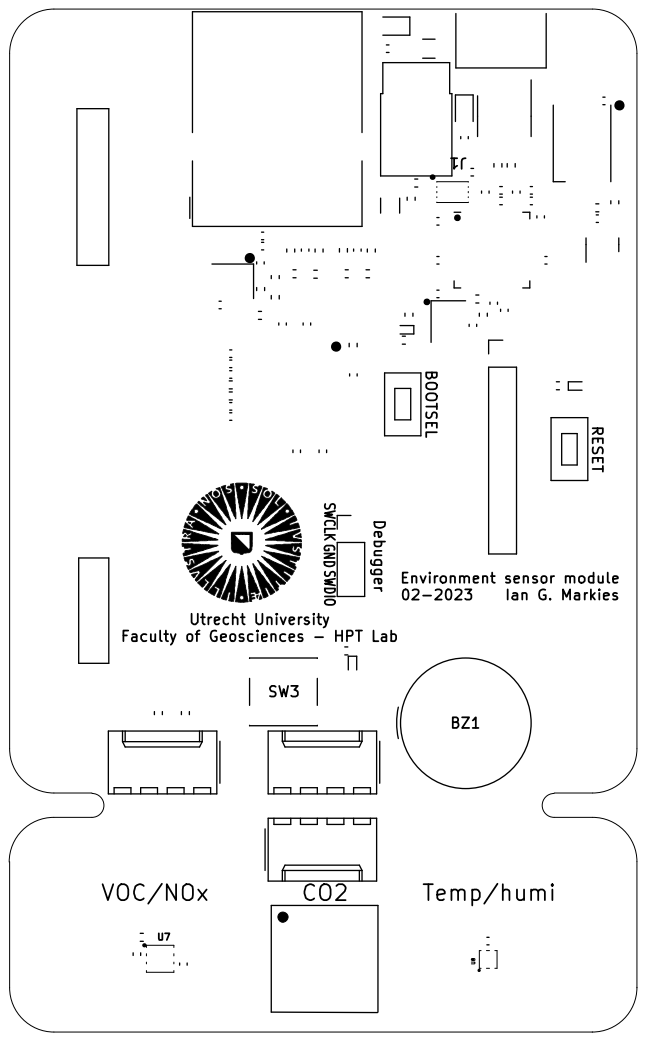
[picture p34: page 1]
