igmarkies/Enviroment-System/PCB/Schematics V1.1.pdf

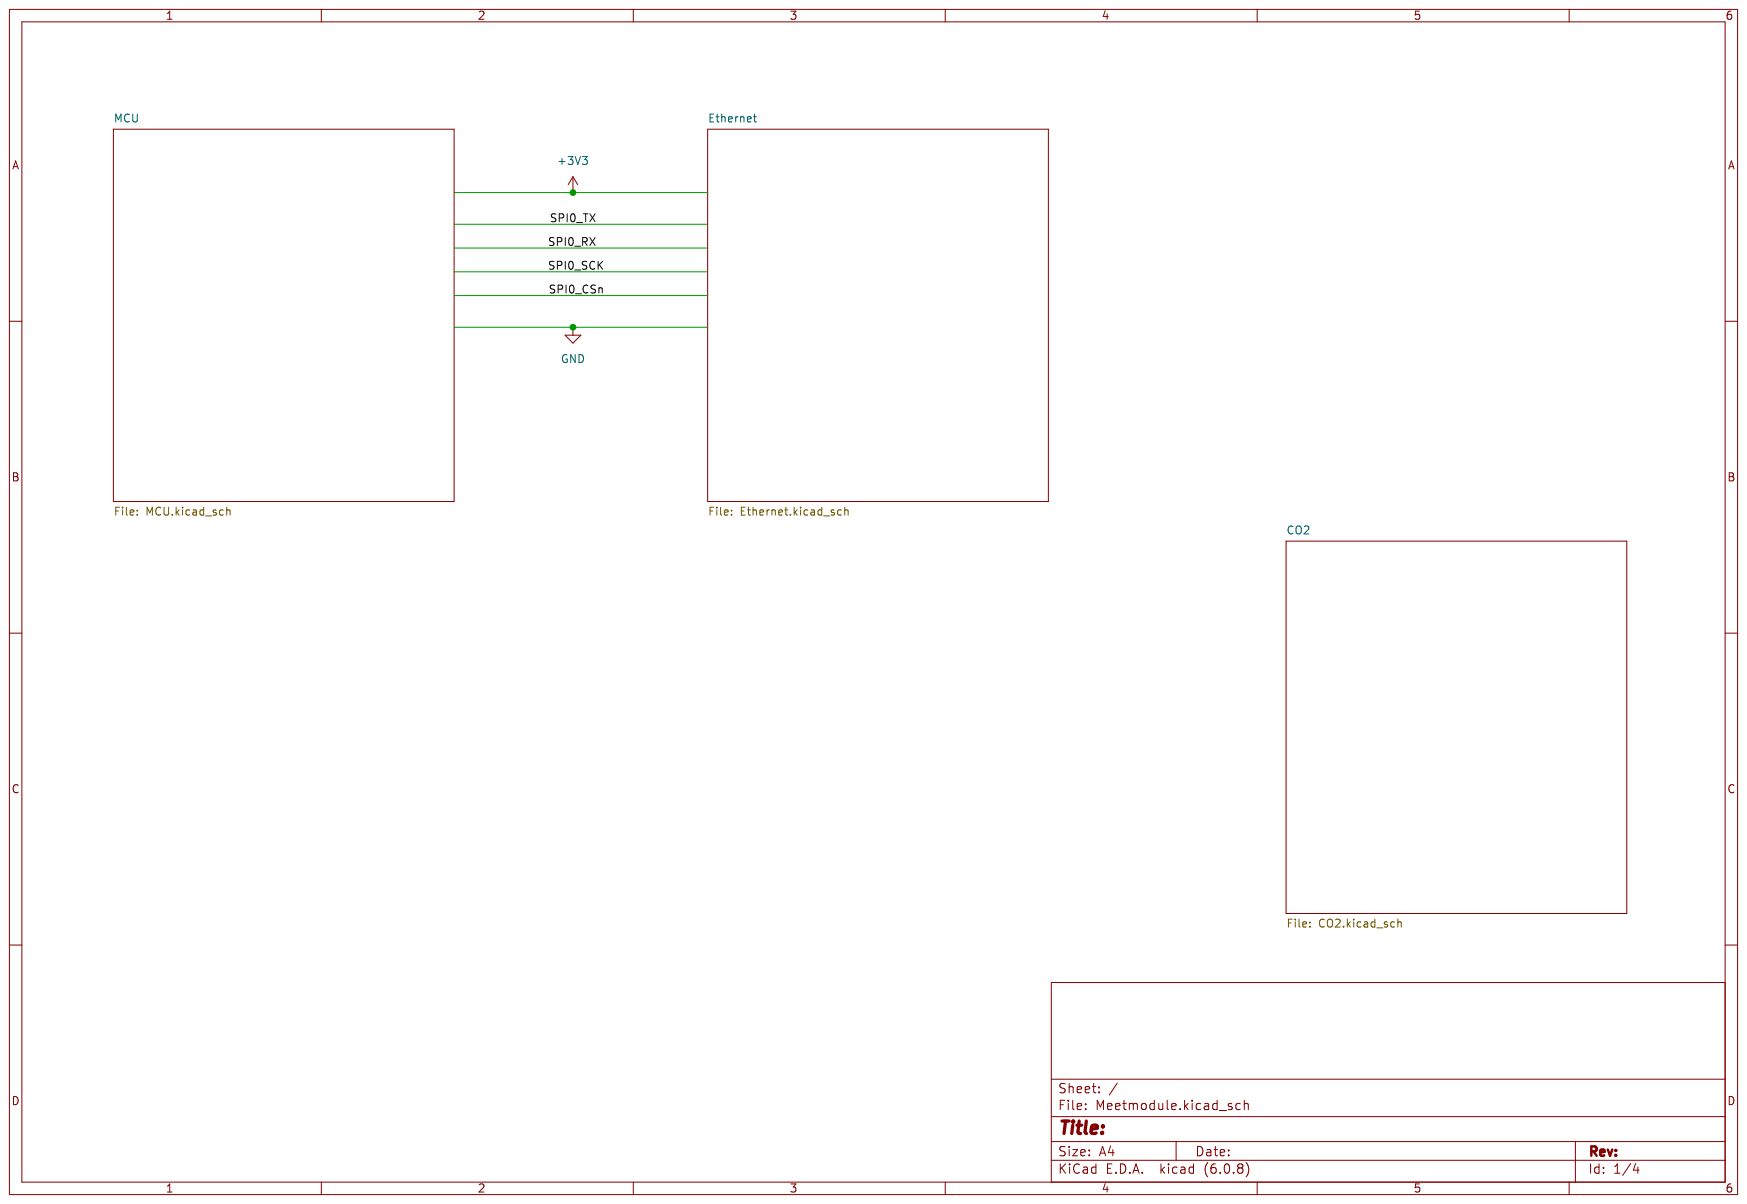
[picture p35: page 1]

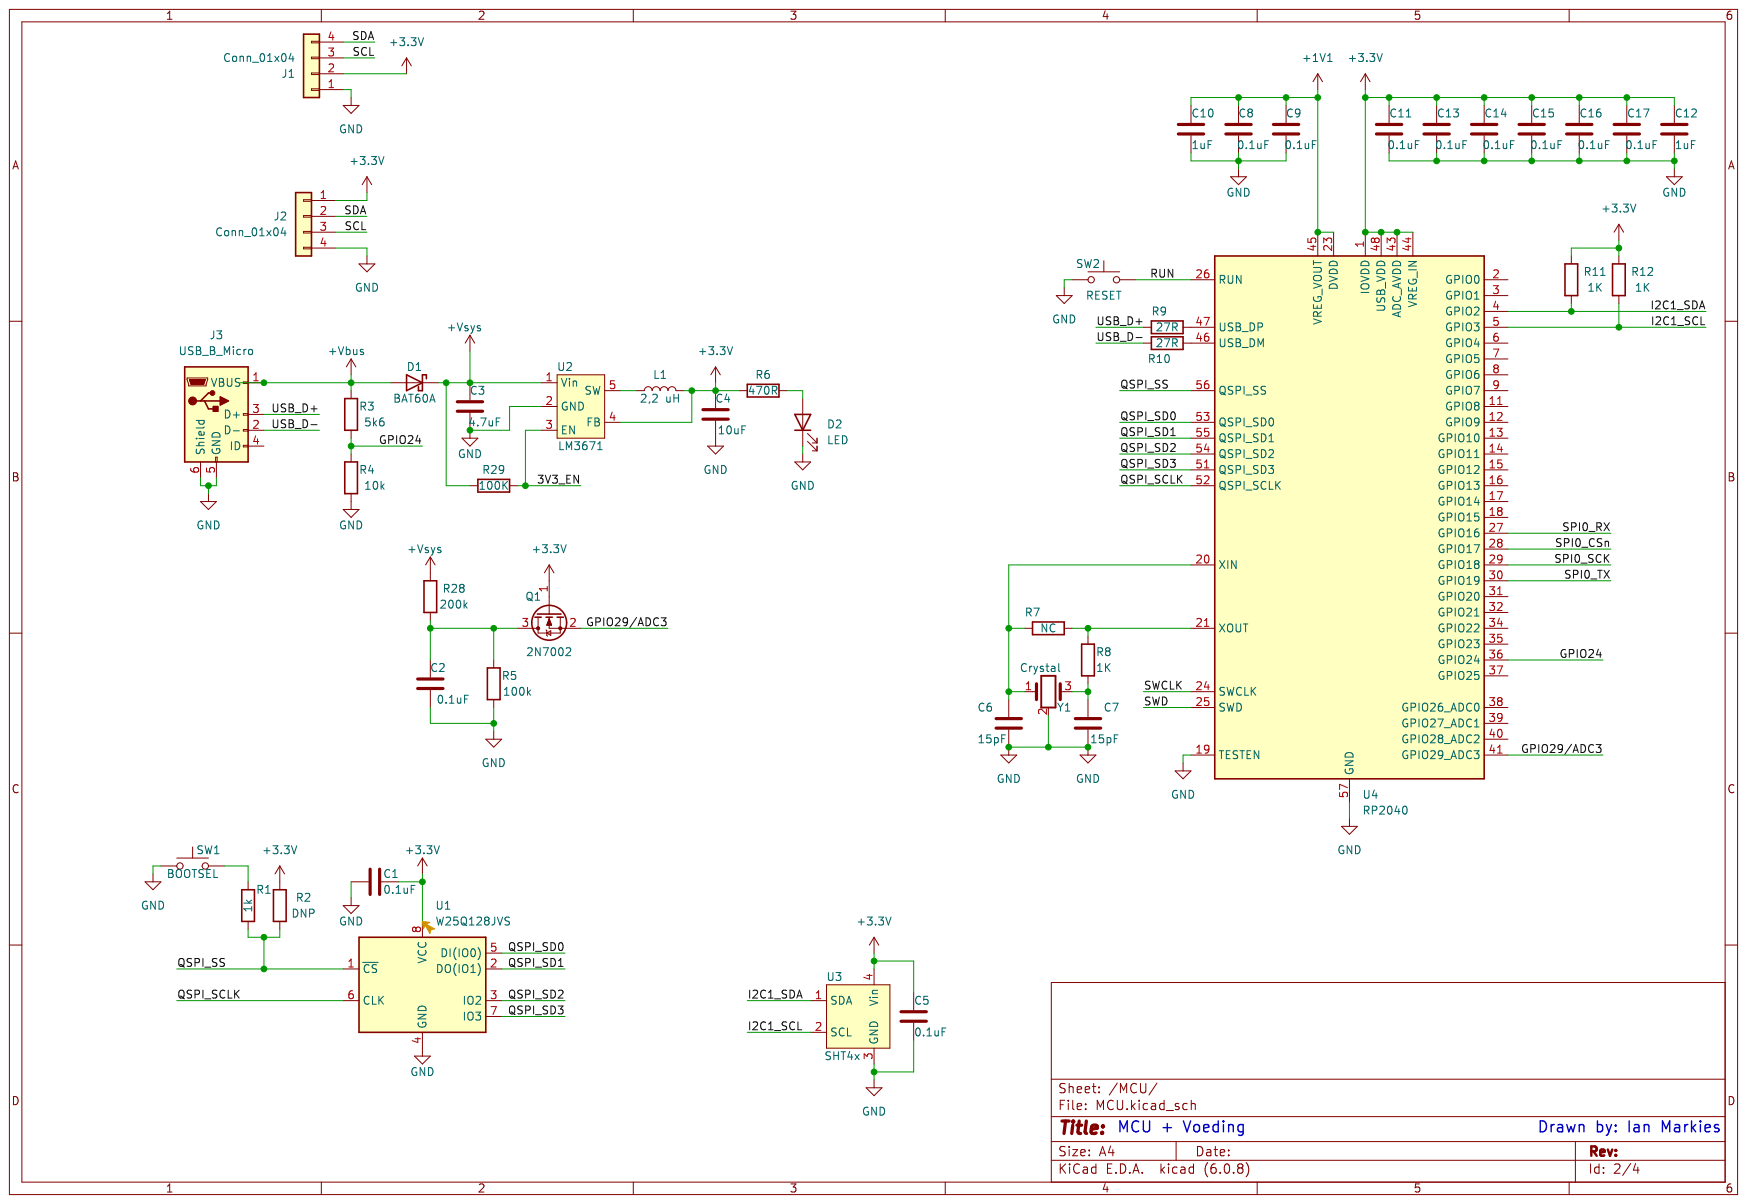
[picture p36: page 2]

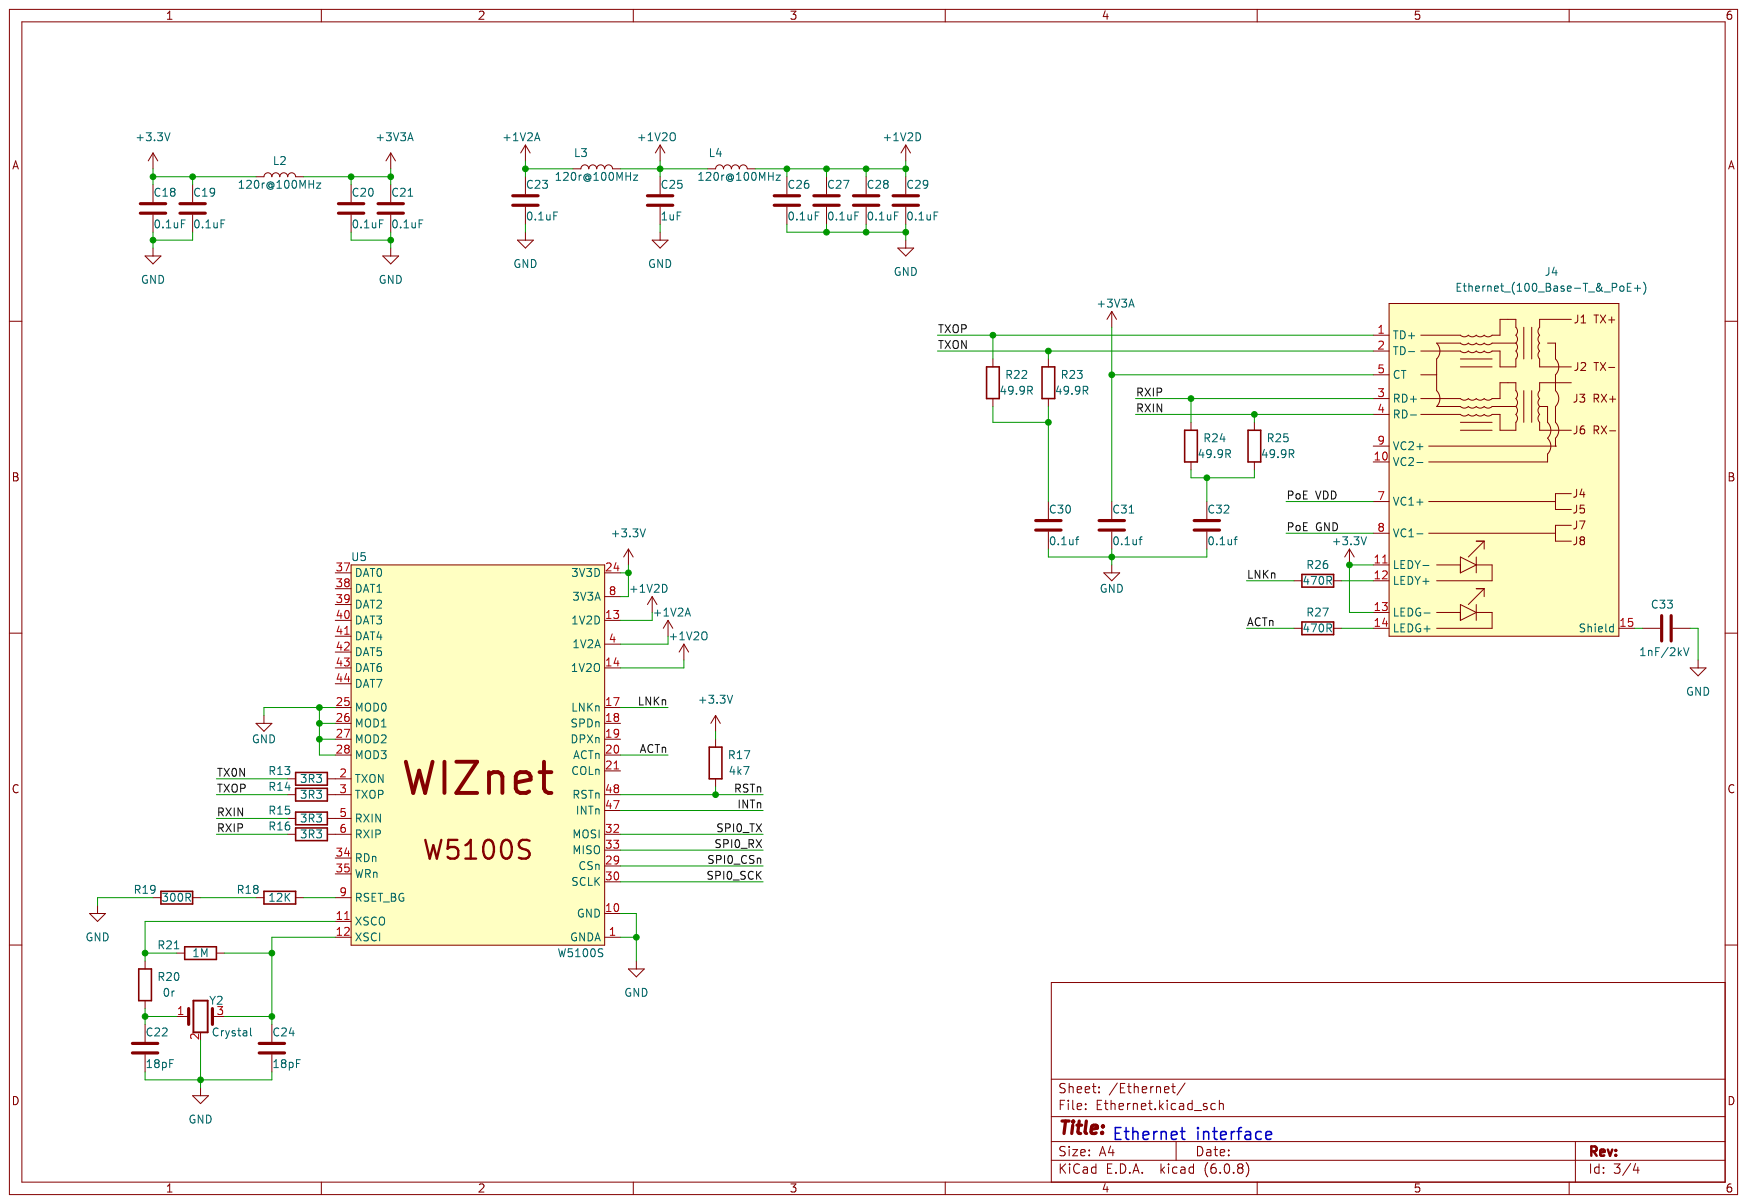
[picture p37: page 3]

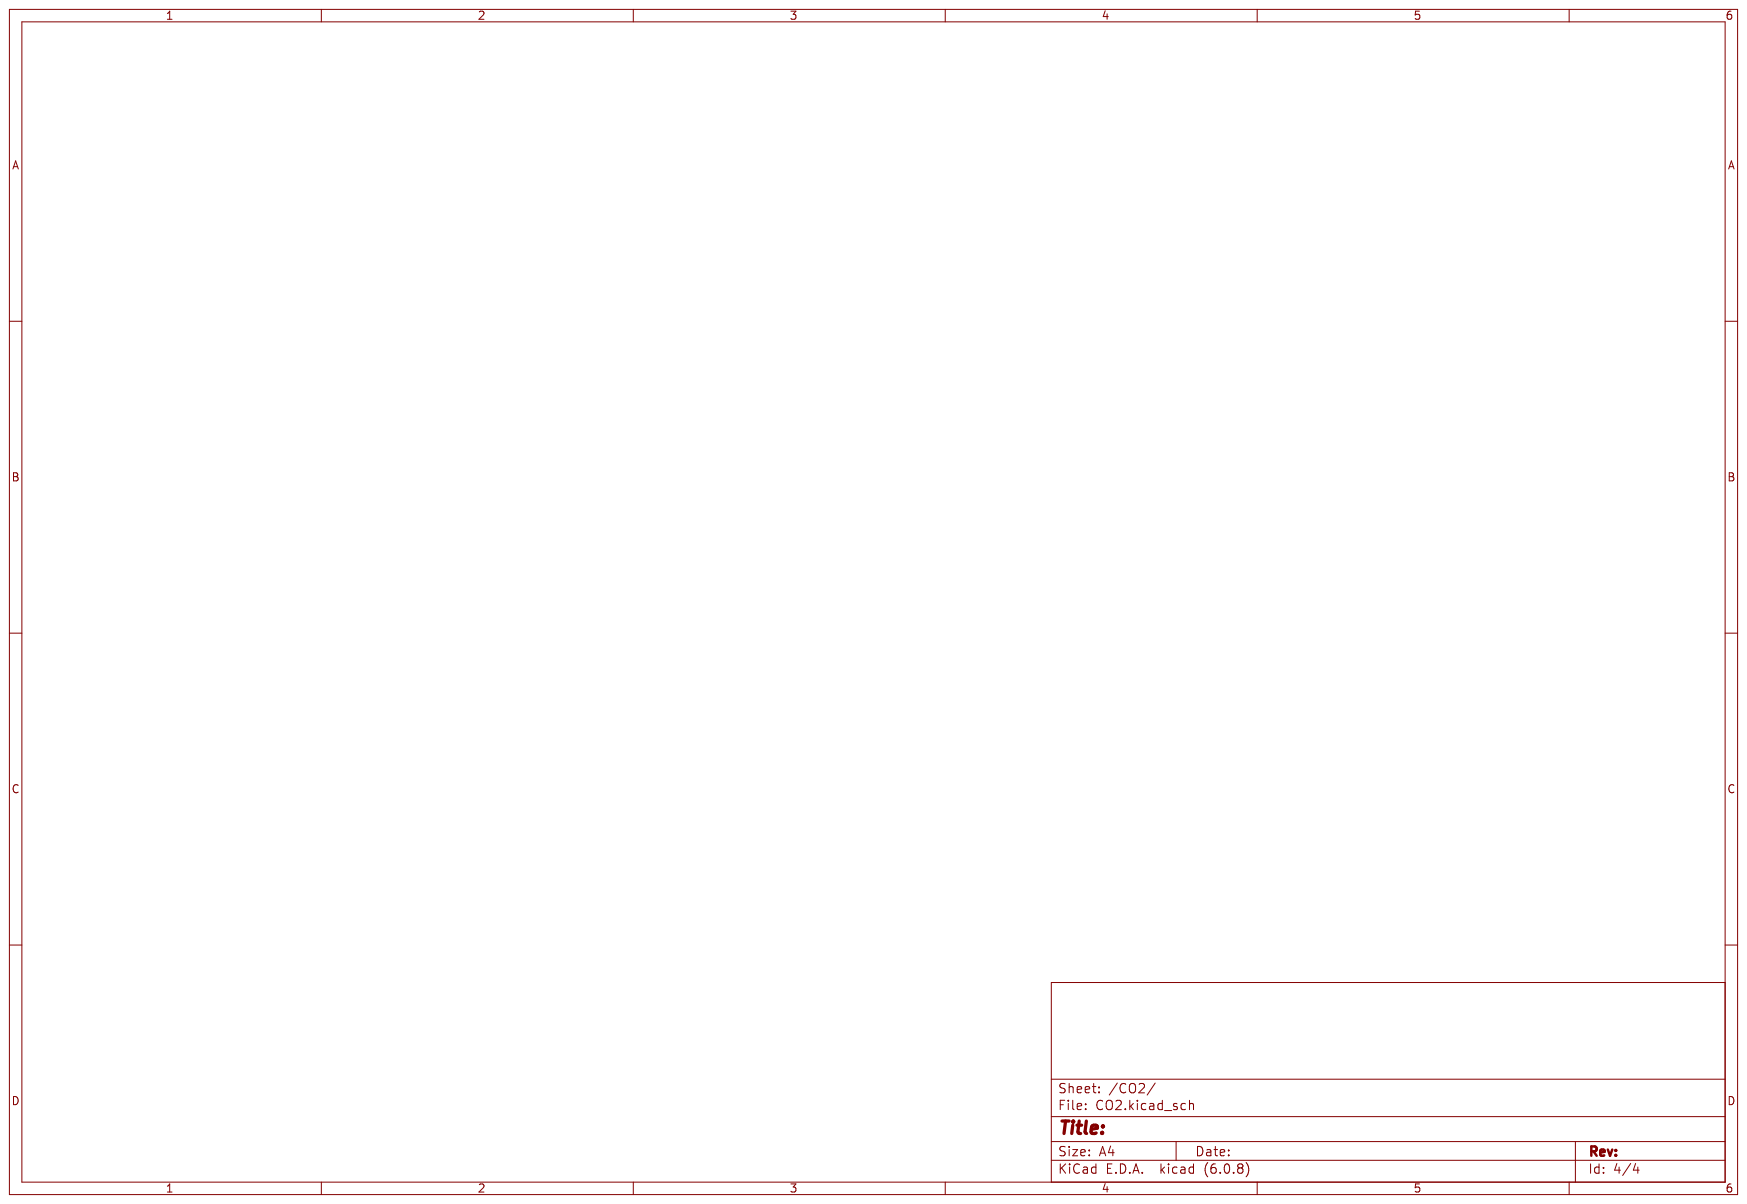
[picture p38: page 4]
