igmarkies/Enviroment-System/PCB/Schematics V1.2.pdf

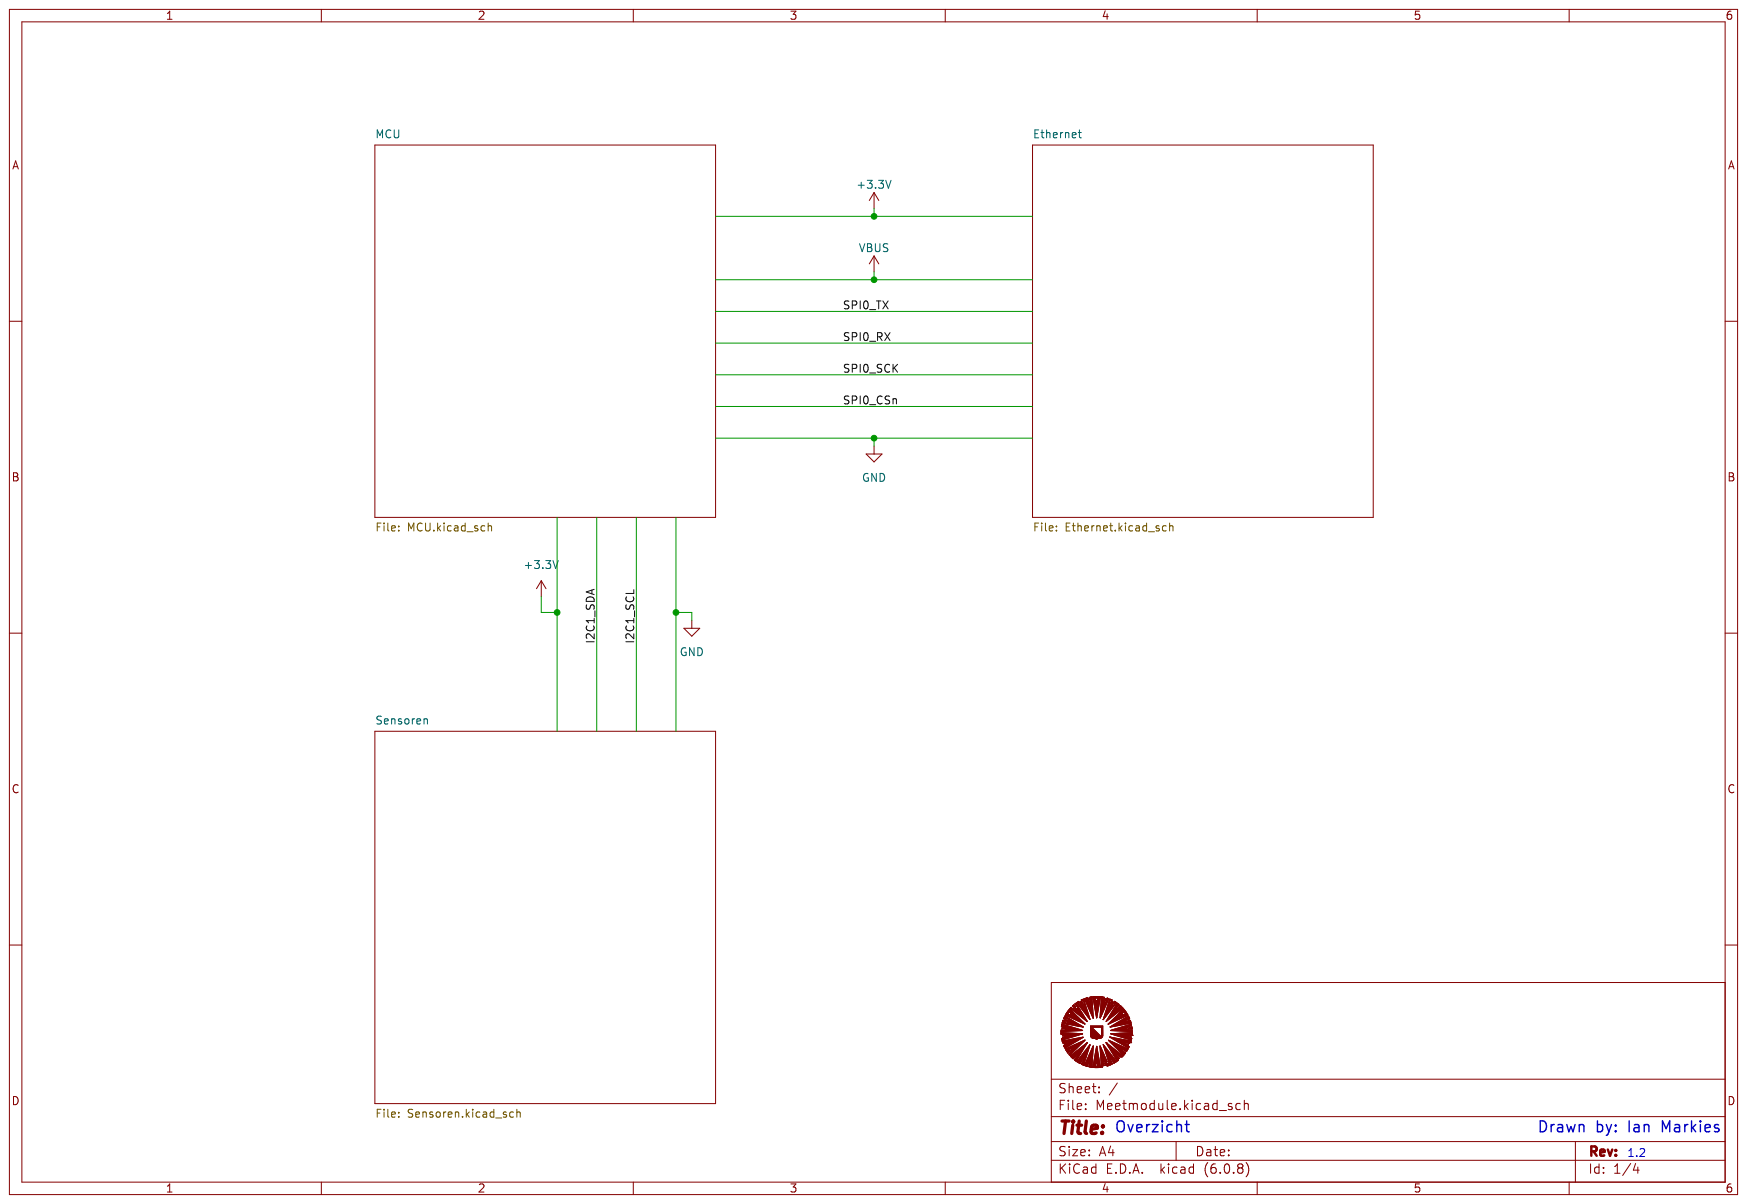
[picture p39: page 1]

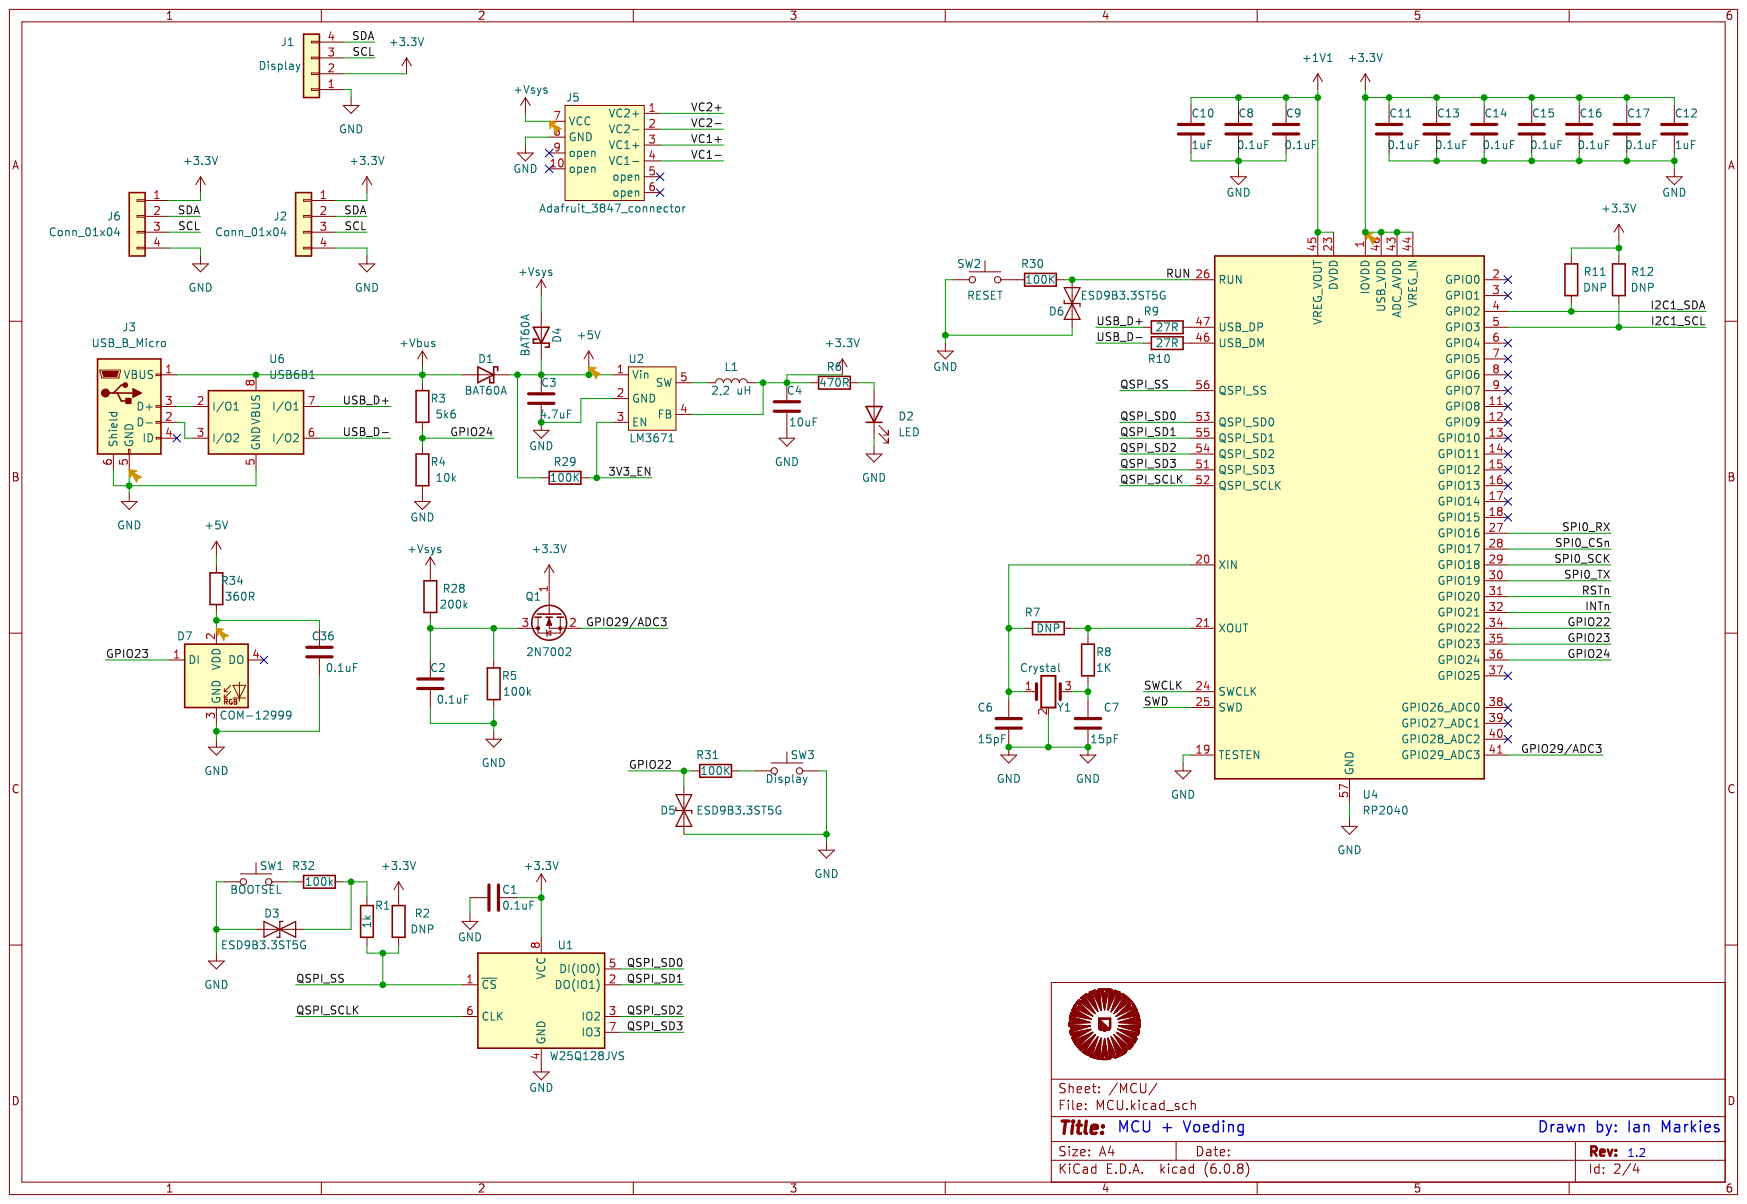
[picture p40: page 2]

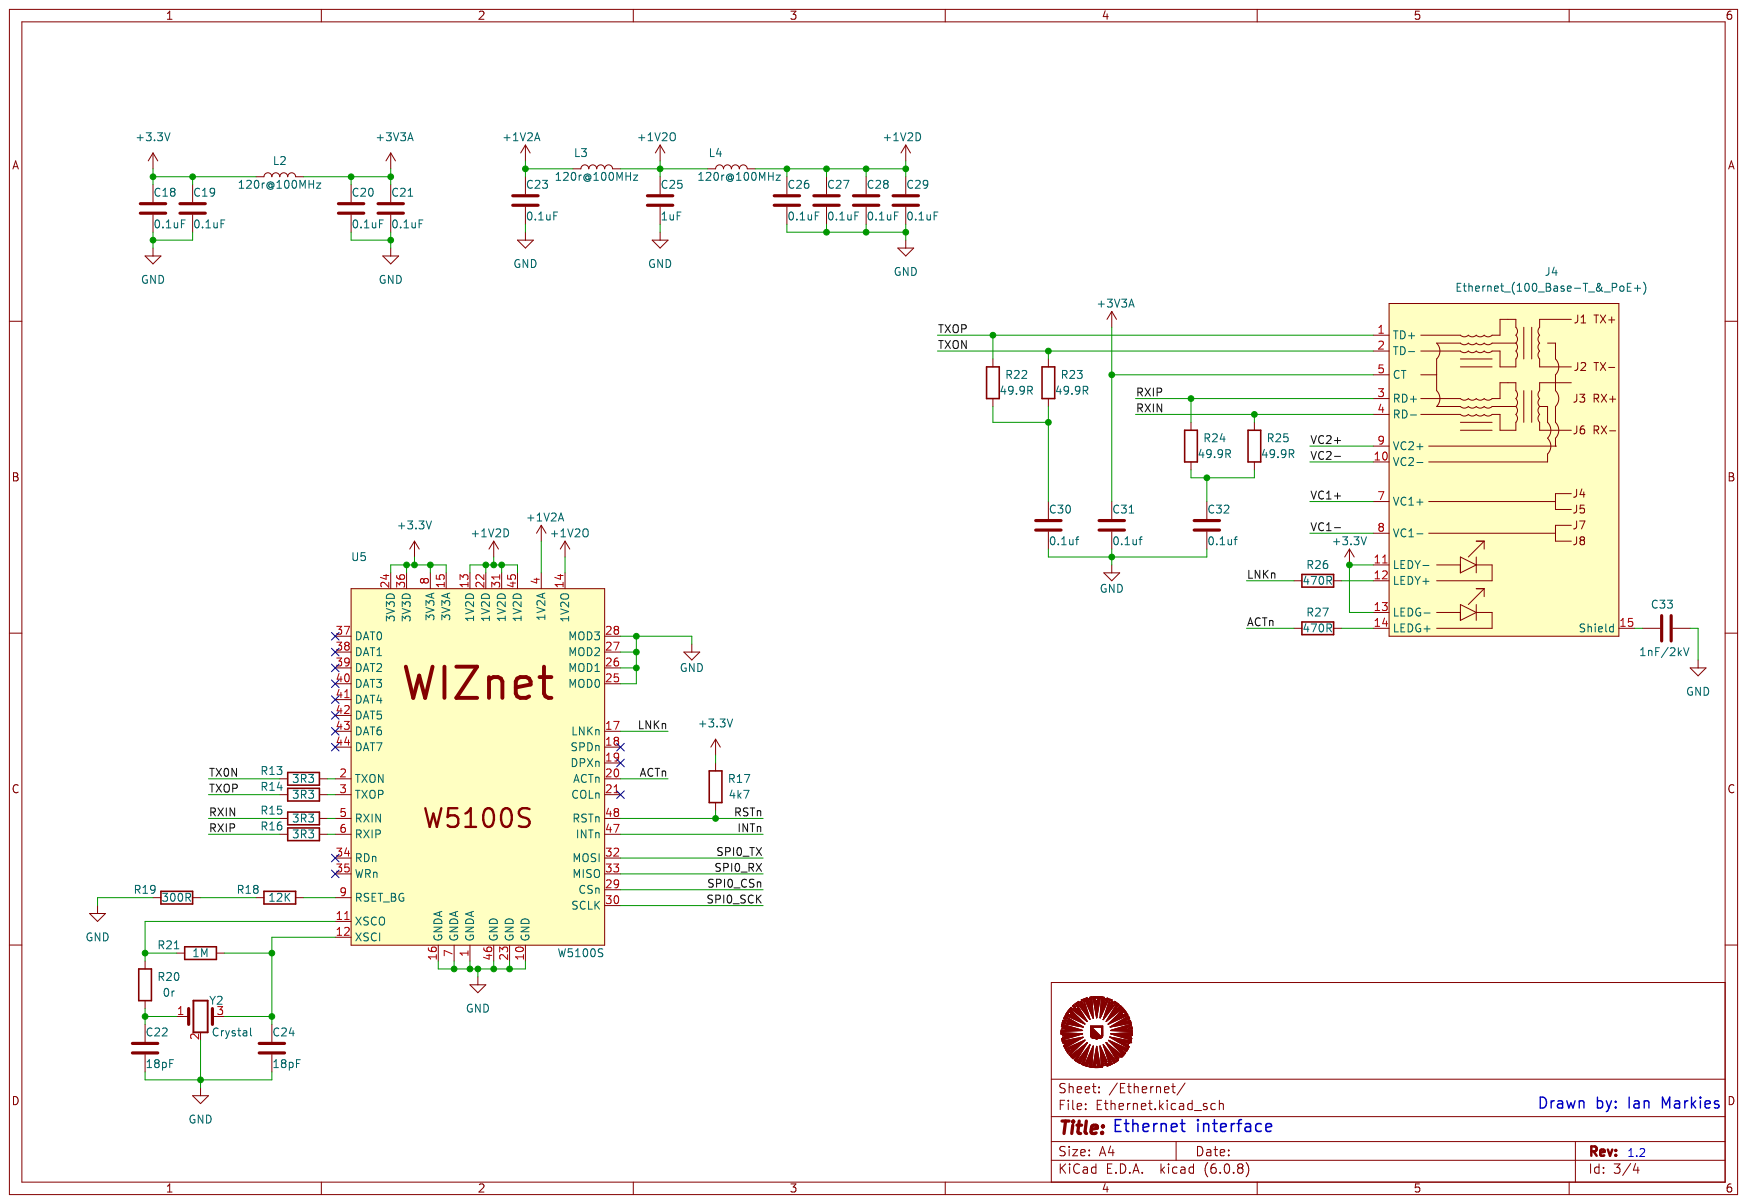
[picture p41: page 3]

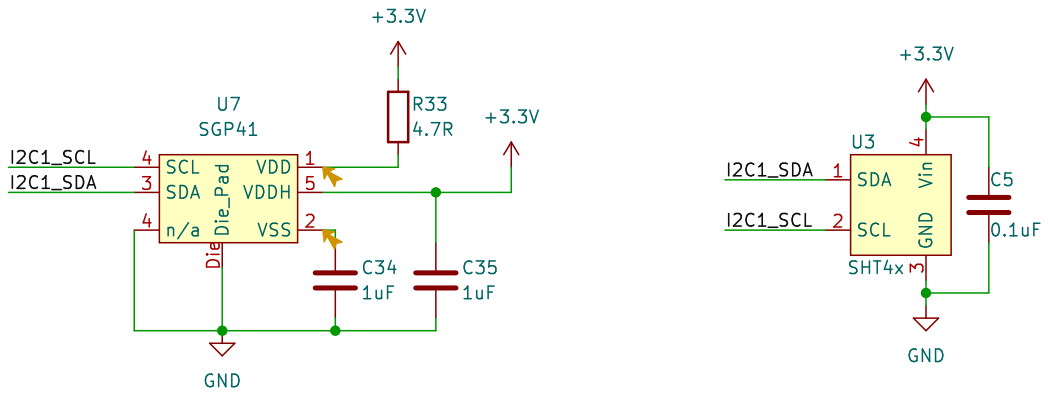
[picture p42: page 4]
