igmarkies/Enviroment-System/PCB/Schematics V1.3.pdf

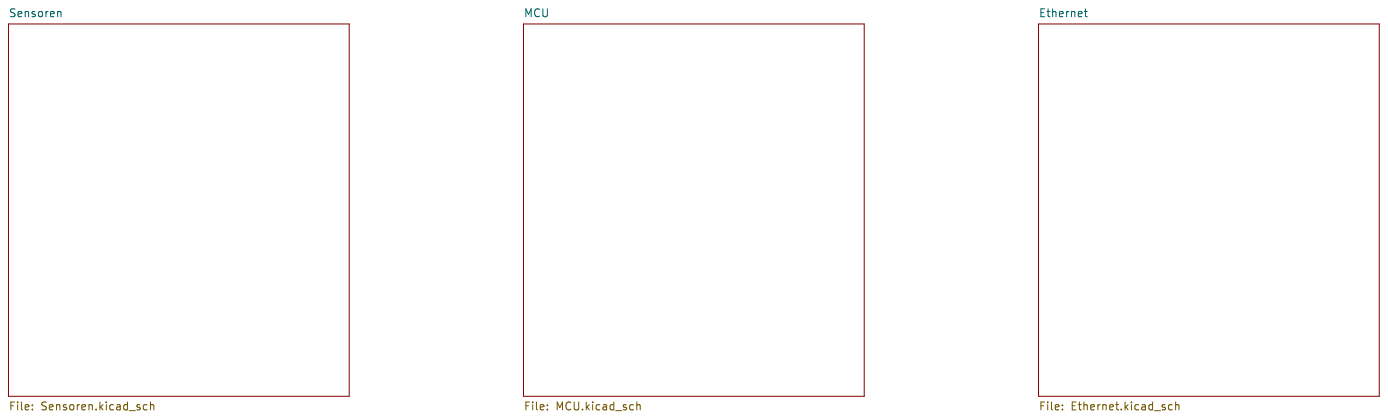
[picture p43: page 1]

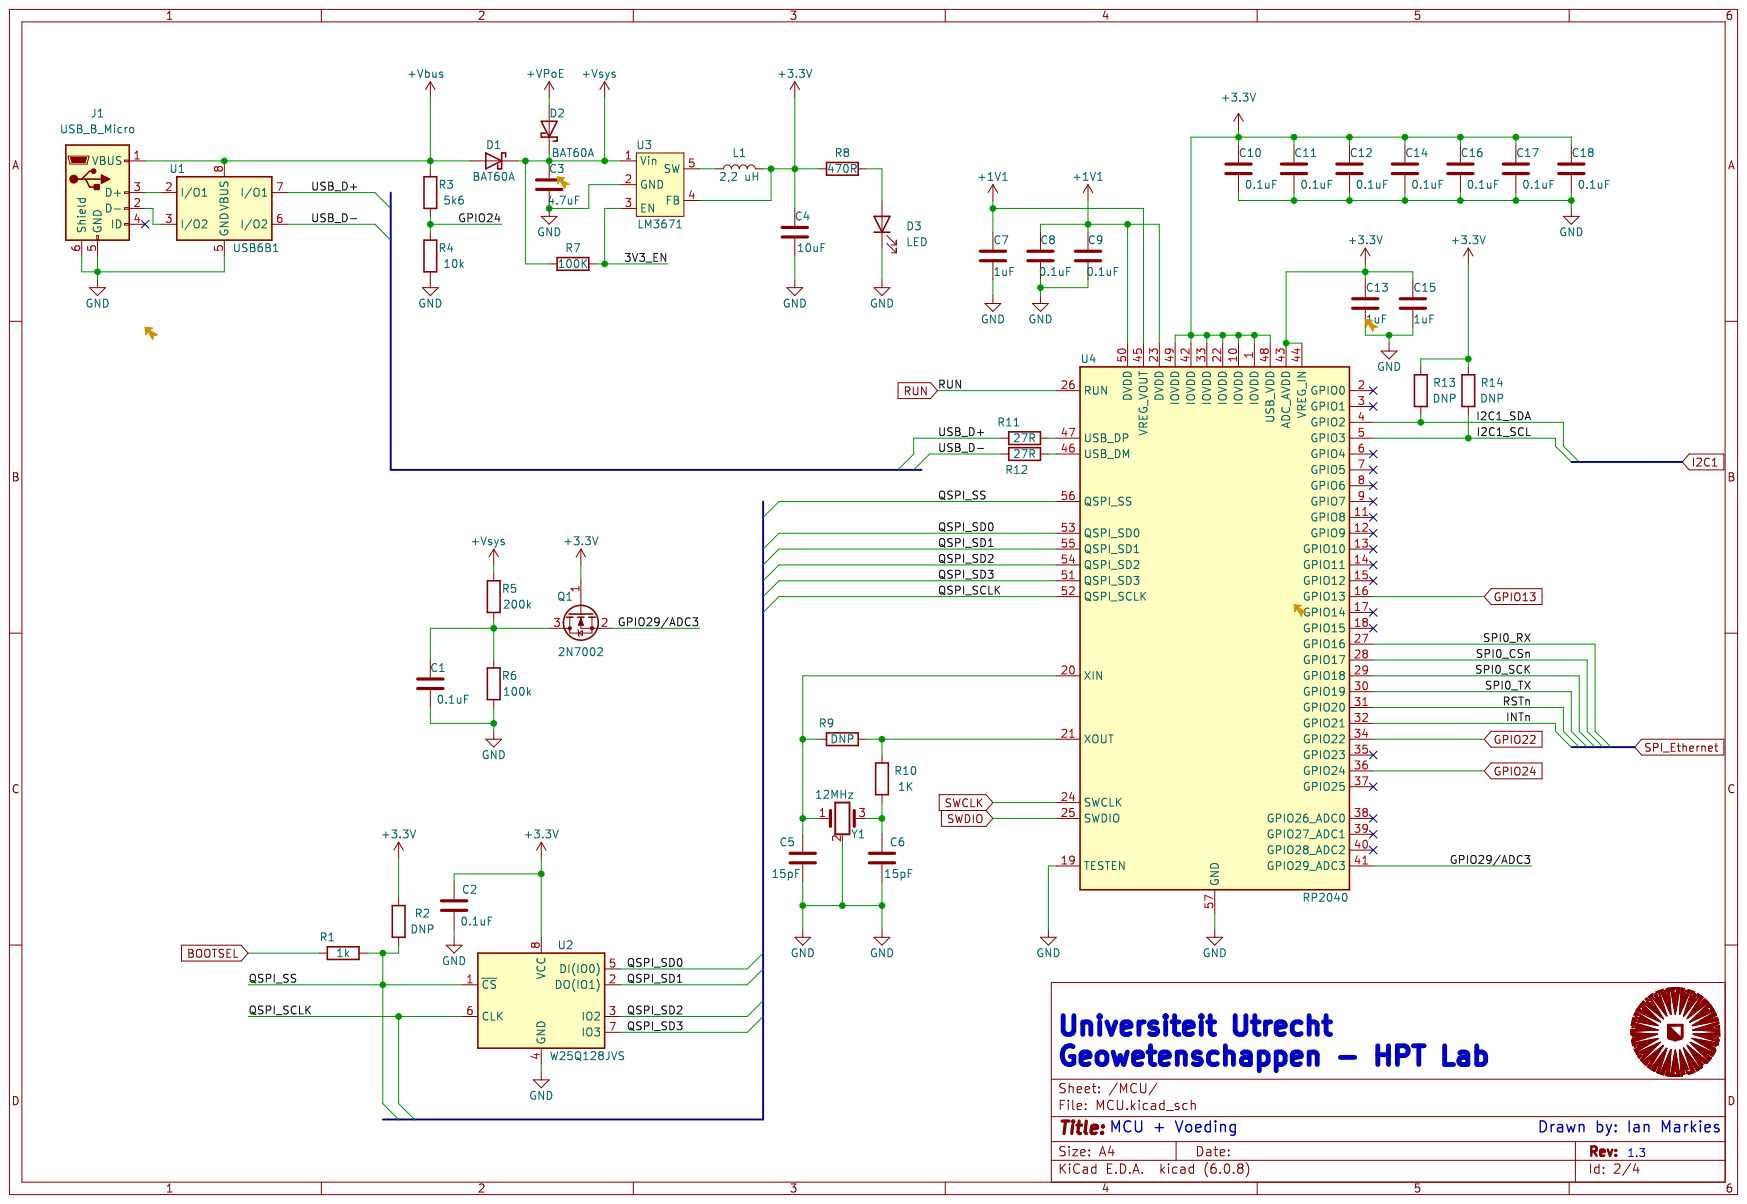
[picture p44: page 2]

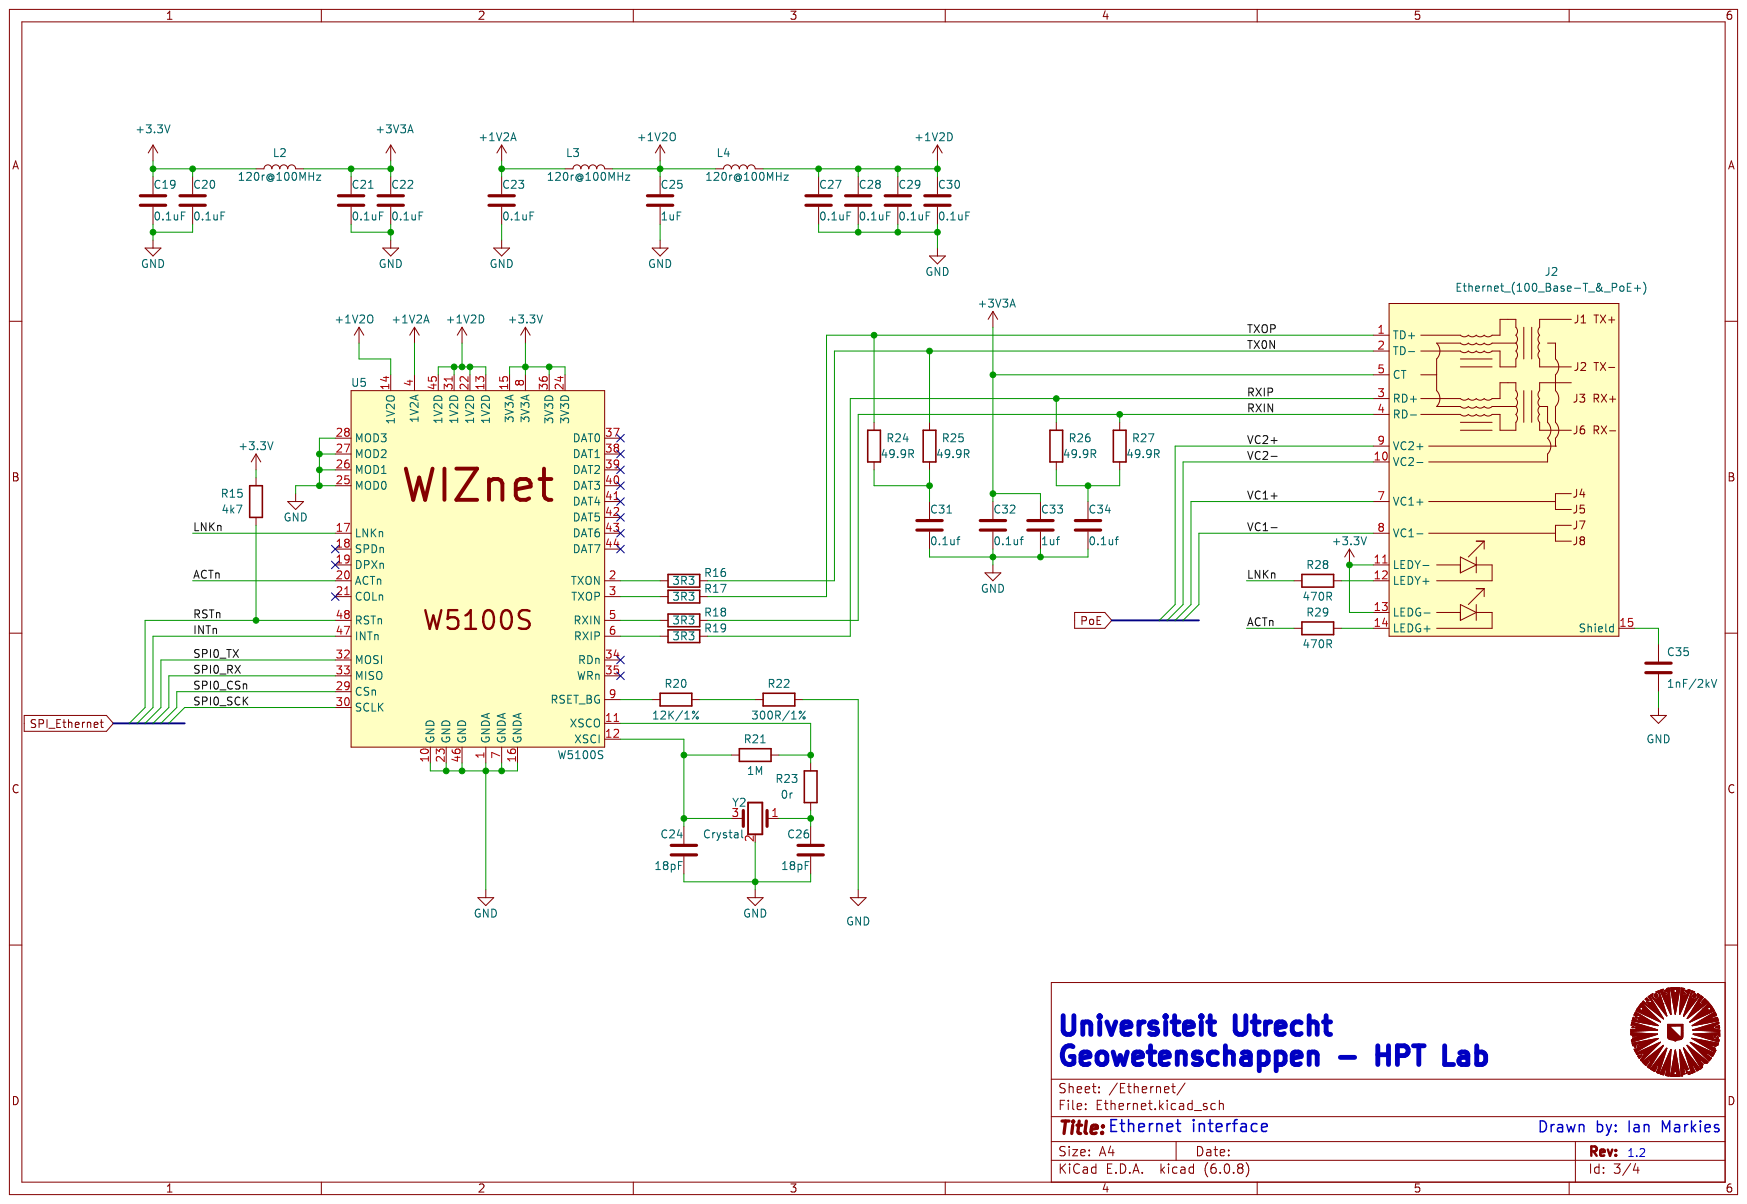
[picture p45: page 3]

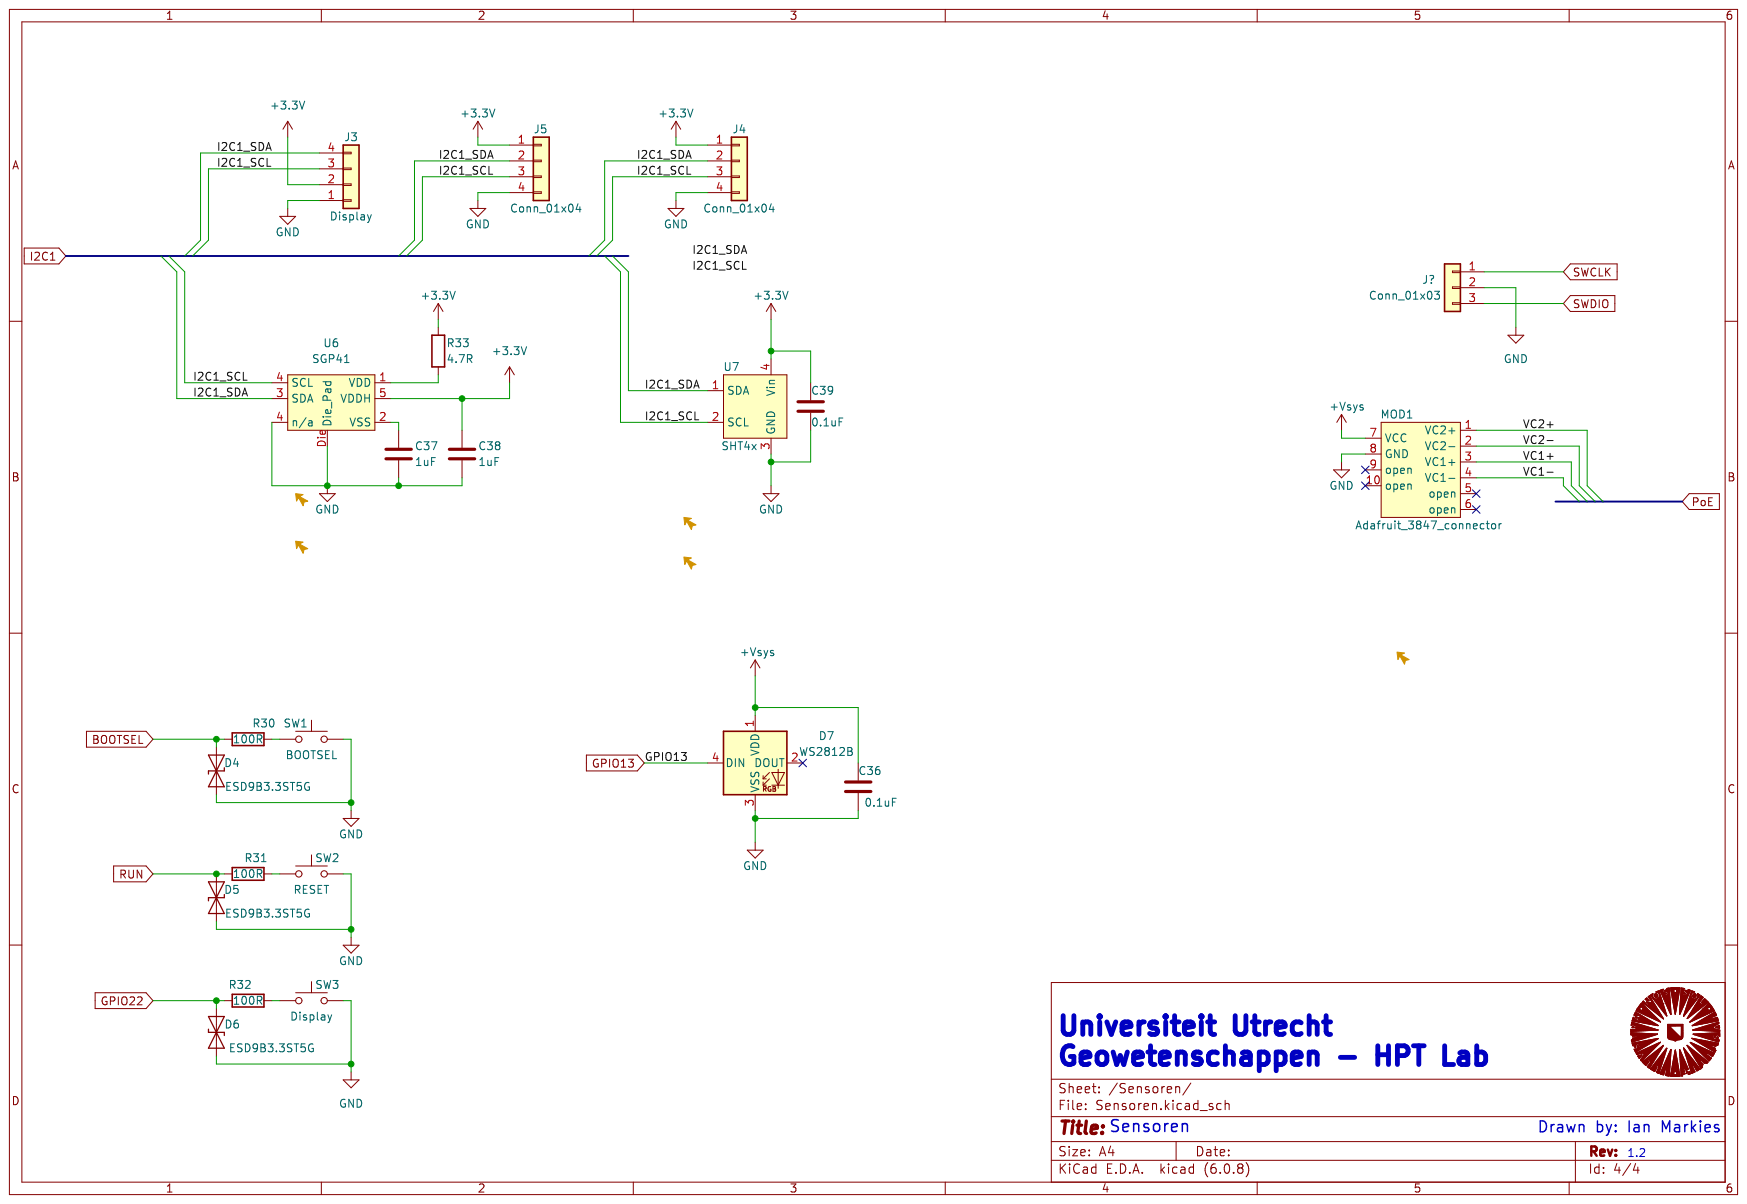
[picture p46: page 4]
