igmarkies/Enviroment-System/PCB/Meetmodule V2.8/Meetmodule V3.kicad_pcb

## KiCad design PCB/Meetmodule V2.8/Meetmodule V3.kicad_pcb (2023-08-22)

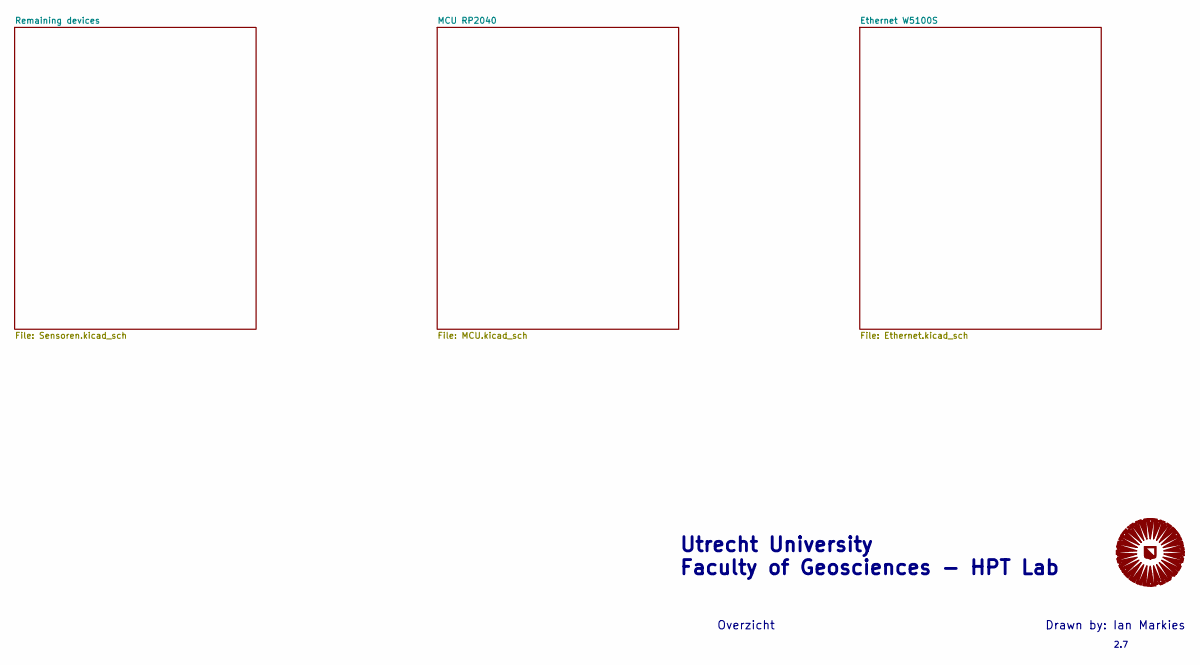
[picture p47: schematic Meetmodule V3.kicad_sch]

Notes on the sheet:
Overzicht
2.7
Utrecht University Faculty of Geosciences - HPT Lab
Drawn by: Ian Markies

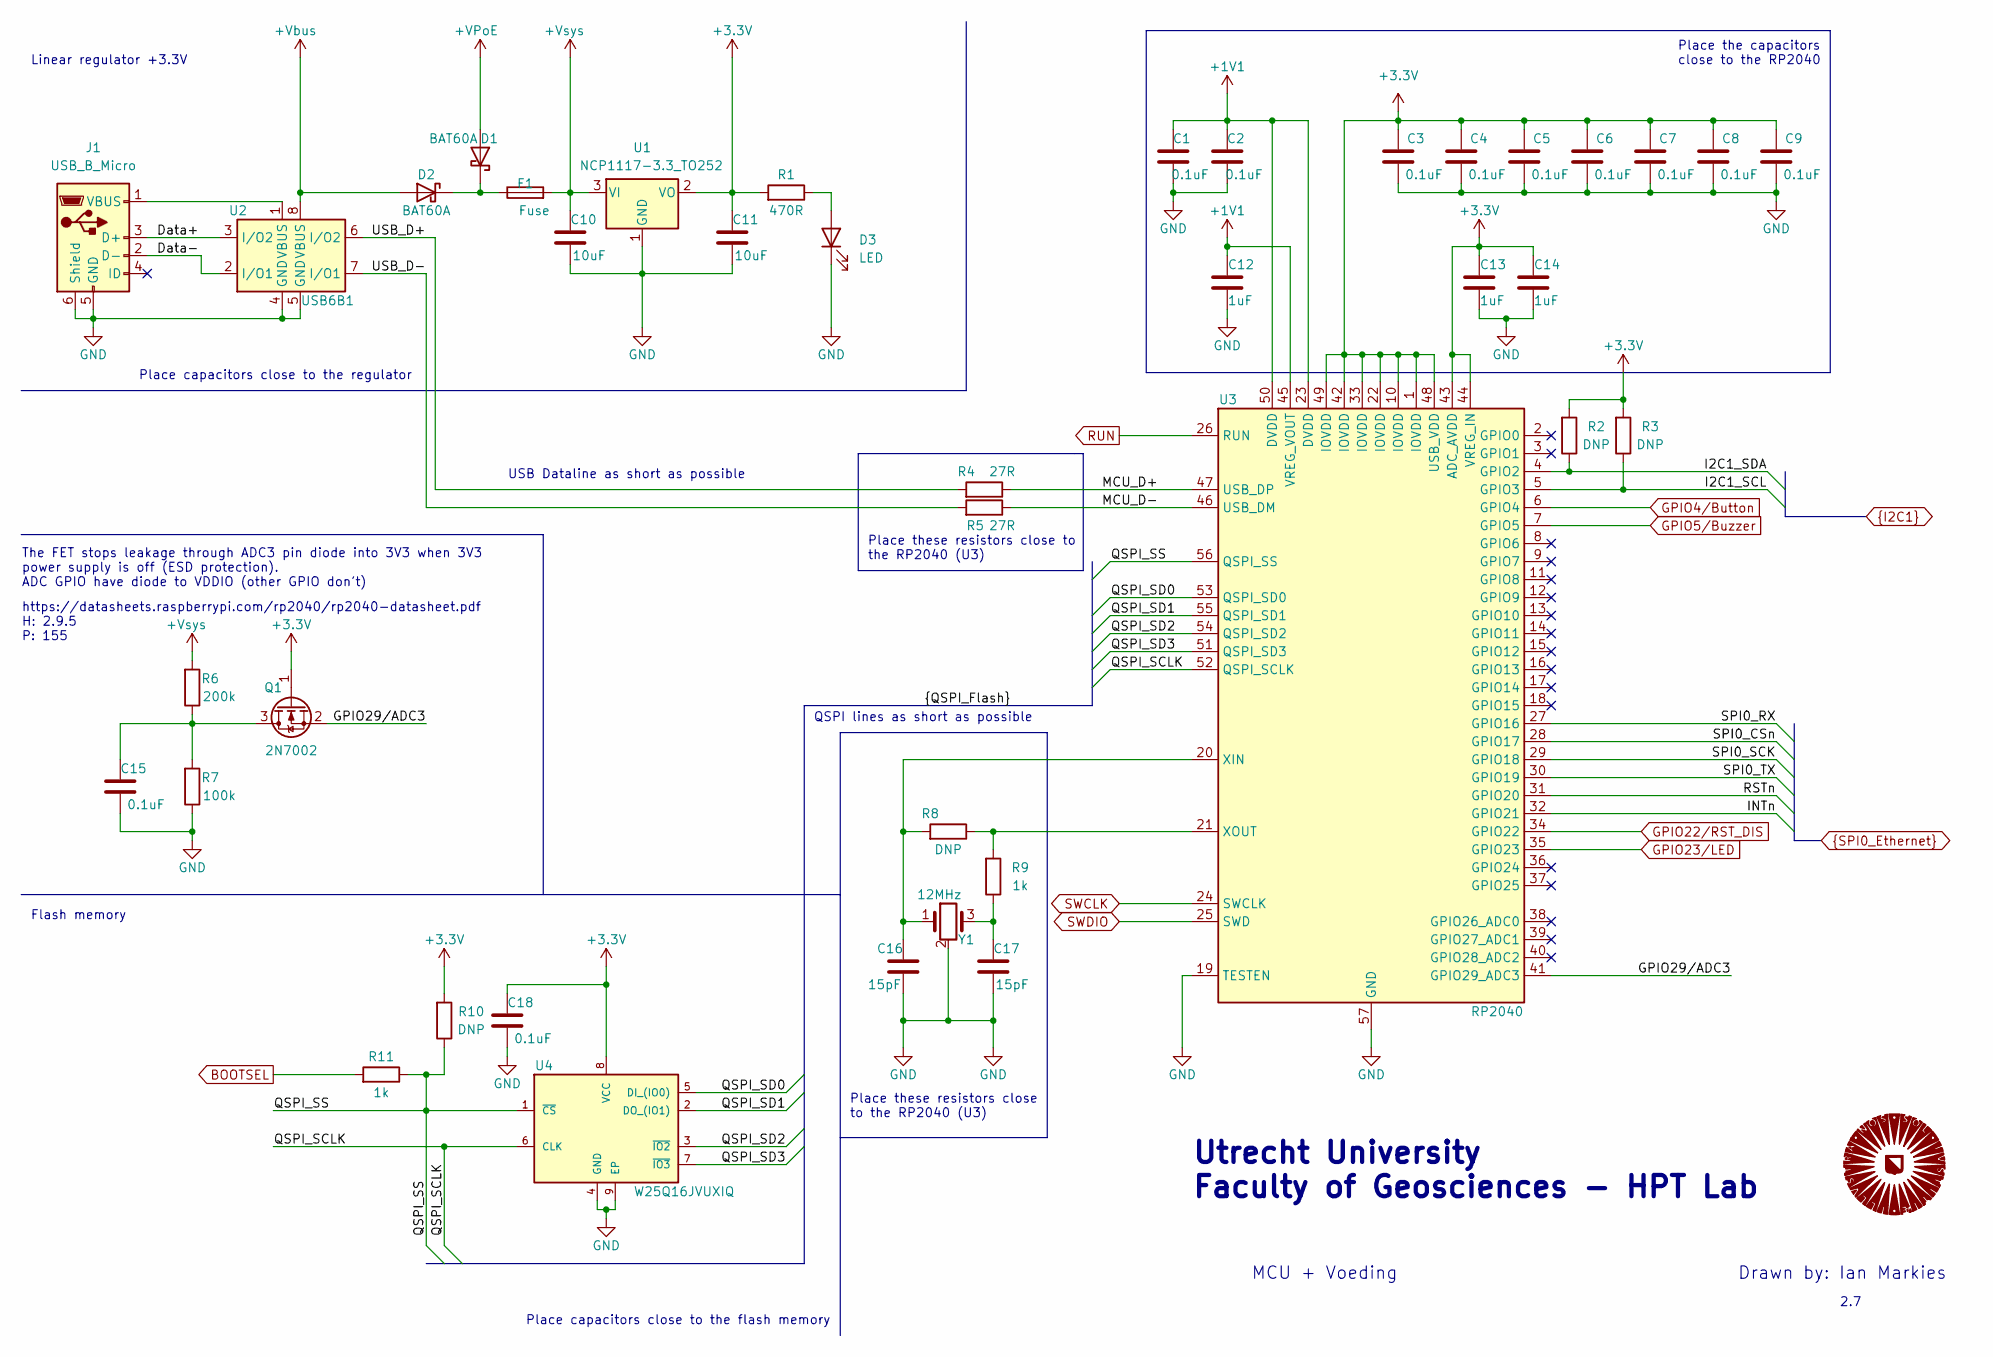
[picture p48: schematic MCU.kicad_sch]

Parts:
C1, C2, C3, C4, C5, C6, C7, C8, C9, C15, C18: 0.1uF; Cap 0402_1005Metric
C10, C11: 10uF; Cap 0402_1005Metric
C12, C13, C14: 1uF; Cap 0402_1005Metric
C16, C17: 15pF; Cap 0402_1005Metric
D1, D2: BAT60A; D_SOD-323
D3: LED
F1: Fuse; Fuse_1206_3216Metric
J1: USB_B_Micro; Micro USB, Type B
Q1: 2N7002; SOT-23
R1: 470R; Res 0402_1005Metric
R2, R3, R8, R10: DNP; Res 0402_1005Metric
R4, R5: 27R; Res 0402_1005Metric
R6: 200k; Res 0402_1005Metric
R7: 100k; Res 0402_1005Metric
R9, R11: 1k; Res 0402_1005Metric
U1: NCP1117-3.3_TO252; TO-252-2
U2: USB6B1; SOIC-8_3.9x4.9mm_P1.27mm
U3: RP2040; QFN-56-1EP_7x7mm_P0.4mm_EP3.2x3.2mm
U4: W25Q16JVUXIQ; SON50P300X200X60-9N; MANUFACTURER_PART_NUMBER W25Q16JVUXIQ
Y1: 12MHz; Crystal_SMD_Abracon_ABM8G-4Pin_3.2x2.5mm

Connections:
+1V1: C1.1, C2.1, C12.1, U3.23 (DVDD), U3.45 (VREG_VOUT), U3.50 (DVDD)
+3.3V: C3.1, C4.1, C5.1, C6.1, C7.1, C8.1, C9.1, C11.1, C13.1, C14.1, C18.1, Q1.1 (G), R1.2, R2.2, R3.2, R10.2, U1.2 (VO), U3.1 (IOVDD), U3.10 (IOVDD), U3.22 (IOVDD), U3.33 (IOVDD), U3.42 (IOVDD), U3.43 (ADC_AVDD), U3.44 (VREG_IN), U3.48 (USB_VDD), U3.49 (IOVDD), U4.8 (VCC); also elsewhere on the board
+VPoE: D1.2 (A); also elsewhere on the board
+VSYS: C10.1, F1.2, R6.2, U1.3 (VI); also elsewhere on the board
+Vbus: D2.2 (A), U2.8 (VBUS)
/MCU RP2040/Data+: J1.3 (D+), U2.3 (I/O2)
/MCU RP2040/Data-: J1.2 (D-), U2.2 (I/O1)
/MCU RP2040/GPIO29/ADC3: Q1.2 (S), U3.41 (GPIO29_ADC3)
/MCU RP2040/MCU_D+: R4.1, U3.47 (USB_DP)
/MCU RP2040/MCU_D-: R5.1, U3.46 (USB_DM)
/MCU RP2040/QSPI_SCLK: U3.52 (QSPI_SCLK), U4.6 (CLK)
/MCU RP2040/QSPI_SD0: U3.53 (QSPI_SD0), U4.5 (DI_(IO0))
/MCU RP2040/QSPI_SD1: U3.55 (QSPI_SD1), U4.2 (DO_(IO1))
/MCU RP2040/QSPI_SD2: U3.54 (QSPI_SD2), U4.3 (~IO2)
/MCU RP2040/QSPI_SD3: U3.51 (QSPI_SD3), U4.7 (~IO3)
/MCU RP2040/QSPI_SS: R10.1, R11.1, U3.56 (QSPI_SS), U4.1 (~CS)
/MCU RP2040/USB_D+: R4.2, U2.6 (I/O2)
/MCU RP2040/USB_D-: R5.2, U2.7 (I/O1)
BOOTSEL: R11.2; also elsewhere on the board
GND: C1.2, C2.2, C3.2, C4.2, C5.2, C6.2, C7.2, C8.2, C9.2, C10.2, C11.2, C12.2, C13.2, C14.2, C15.2, C16.2, C17.2, C18.2, D3.1 (K), J1.5 (GND), J1.6 (Shield), R7.1, U1.1 (GND), U2.4 (GND), U2.5 (GND), U3.19 (TESTEN), U3.57 (GND), U4.4 (GND), U4.9 (EP), Y1.2, Y1.4; also elsewhere on the board
GPIO4/Button: U3.6 (GPIO4); also elsewhere on the board
GPIO5/Buzzer: U3.7 (GPIO5); also elsewhere on the board
GPIO22/RST_DIS: U3.34 (GPIO22); also elsewhere on the board
GPIO23/LED: U3.35 (GPIO23); also elsewhere on the board
I2C1_SCL: R3.1, U3.5 (GPIO3); also elsewhere on the board
I2C1_SDA: R2.1, U3.4 (GPIO2); also elsewhere on the board
INTn: U3.32 (GPIO21); also elsewhere on the board
unnamed: C15.1, Q1.3 (D), R6.1, R7.2
unnamed: C16.1, R8.2, U3.20 (XIN), Y1.1
unnamed: C17.1, R9.1, Y1.3
unnamed: D1.1 (K), D2.1 (K), F1.1
unnamed: D3.2 (A), R1.1
unnamed: J1.1 (VBUS), U2.1 (VBUS)
unnamed: R8.1, R9.2, U3.21 (XOUT)
RSTn: U3.31 (GPIO20); also elsewhere on the board
RUN: U3.26 (RUN); also elsewhere on the board
SPI0_CSn: U3.28 (GPIO17); also elsewhere on the board
SPI0_RX: U3.27 (GPIO16); also elsewhere on the board
SPI0_SCK: U3.29 (GPIO18); also elsewhere on the board
SPI0_TX: U3.30 (GPIO19); also elsewhere on the board
SWCLK: U3.24 (SWCLK); also elsewhere on the board
SWDIO: U3.25 (SWD); also elsewhere on the board

Notes on the sheet:
Drawn by: Ian Markies
Utrecht University Faculty of Geosciences - HPT Lab
Place these resistors close to the RP2040 (U3)
Place capacitors close to the flash memory
QSPI lines as short as possible
2.7
The FET stops leakage through ADC3 pin diode into 3V3 when 3V3 power supply is off (ESD protection). ADC GPIO have diode to VDDIO (other GPIO don't)
Linear regulator +3.3V
https://datasheets.raspberrypi.com/rp2040/rp2040-datasheet.pdf H: 2.9.5 P: 155
MCU + Voeding
USB Dataline as short as possible
Flash memory
Place the capacitors close to the RP2040
Place these resistors close to the RP2040 (U3)
Place capacitors close to the regulator

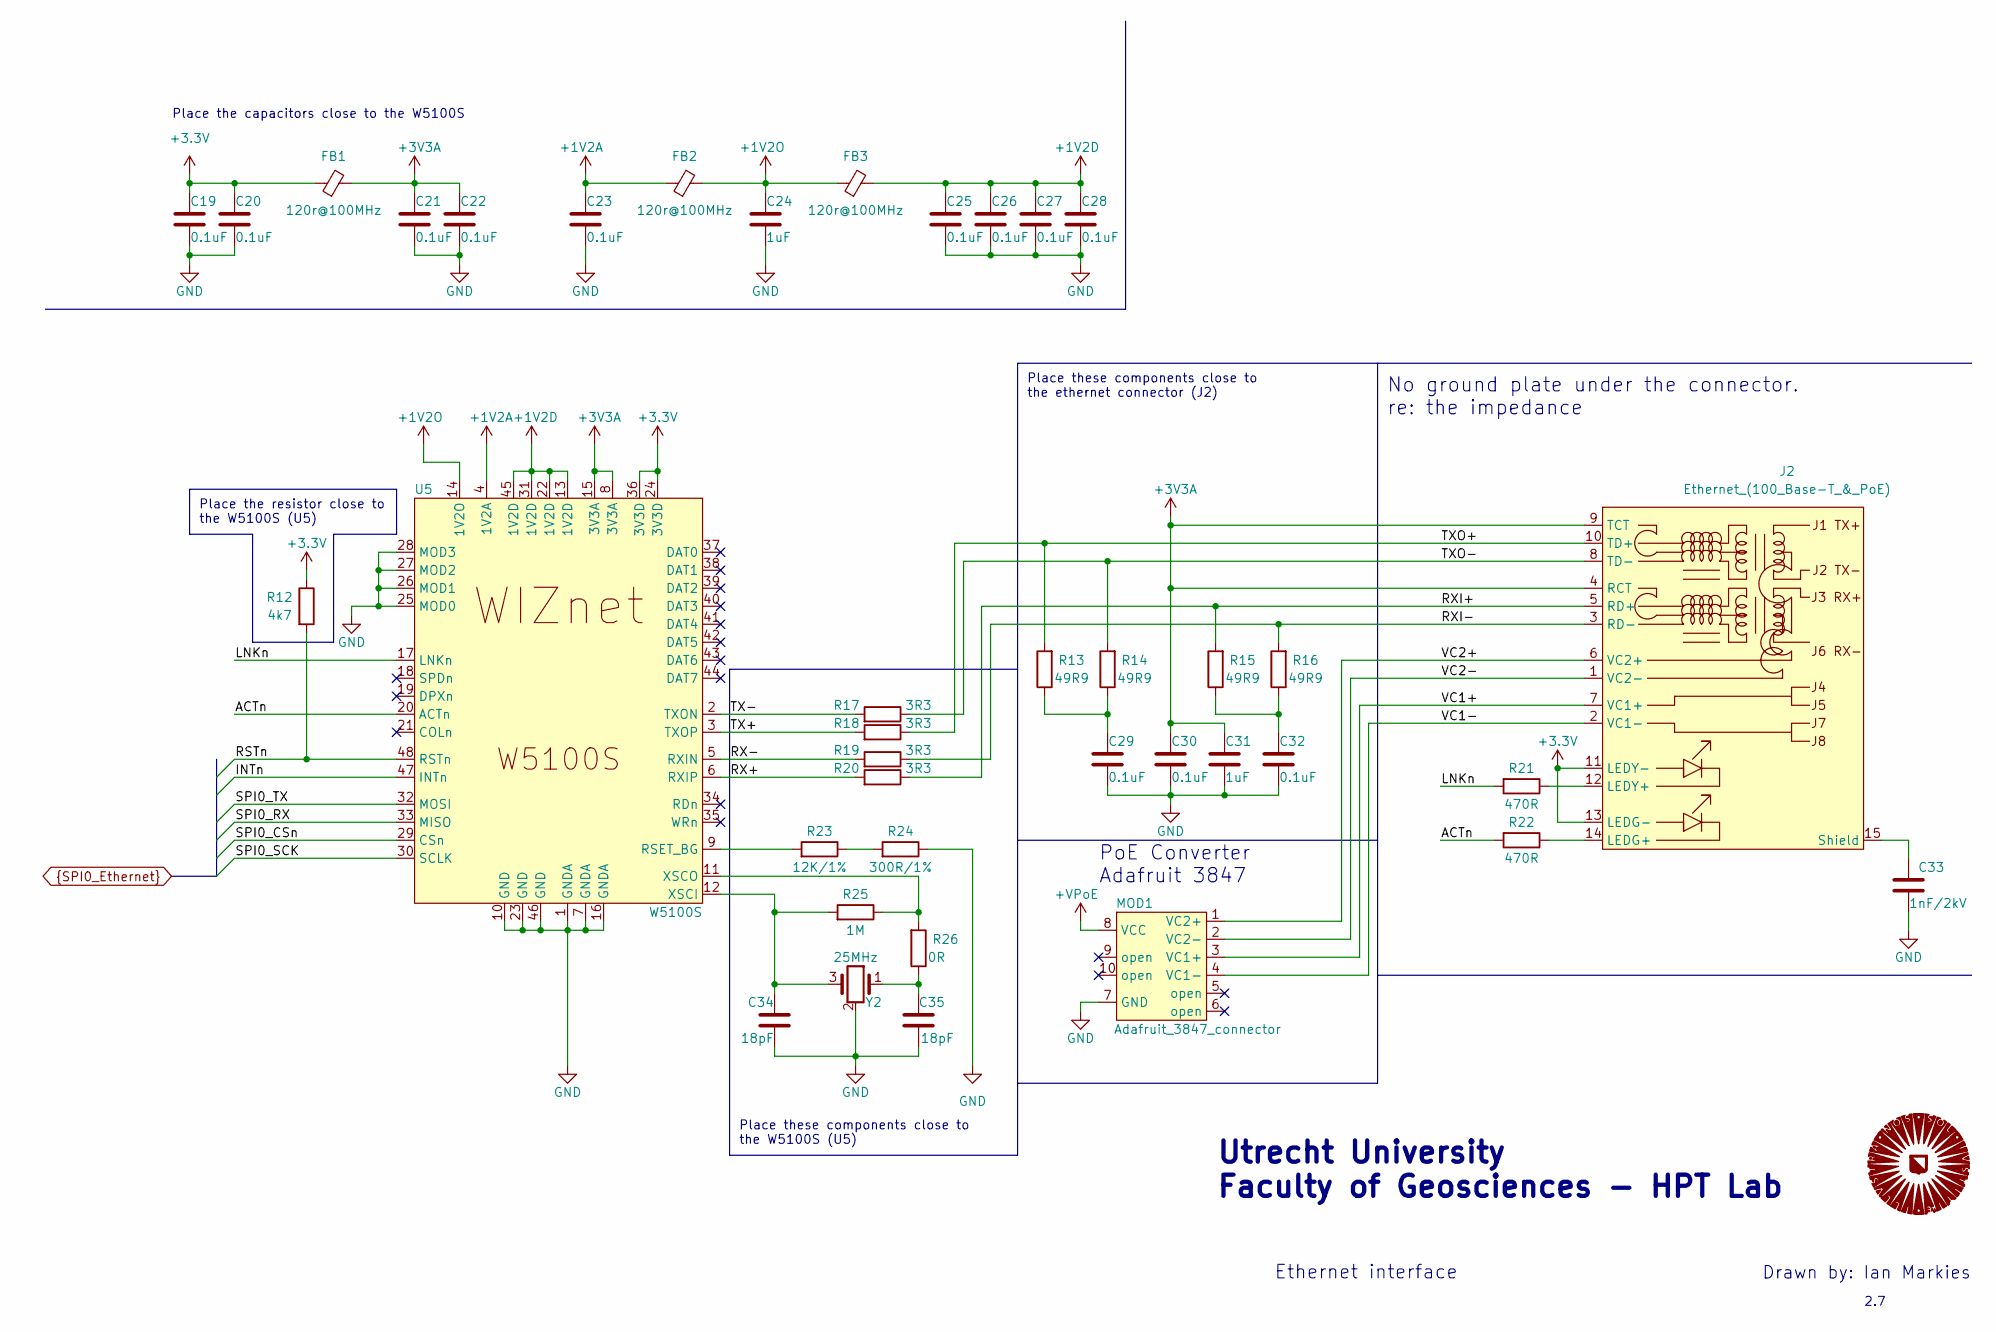
[picture p49: schematic Ethernet.kicad_sch]

Parts:
C19, C20, C21, C22, C23, C25, C26, C27, C28, C29, C30, C32: 0.1uF; Cap 0402_1005Metric
C24, C31: 1uF; Cap 0402_1005Metric
C33: 1nF/2kV; Cap 0402_1005Metric
C34, C35: 18pF; Cap 0402_1005Metric
FB1, FB2, FB3: 120r@100MHz; L_0402_1005Metric
J2: Ethernet_(100_Base-T_&_PoE); PoE, 10 Pin with LED
MOD1: Adafruit_3847_connector; Adafruit 3847 connector
R12: 4k7; Res 0402_1005Metric
R13, R14, R15, R16: 49R9; Res 0402_1005Metric
R17, R18, R19, R20: 3R3; Res 0402_1005Metric
R21, R22: 470R; Res 0402_1005Metric
R23: 12K/1%; Res 0402_1005Metric
R24: 300R/1%; Res 0402_1005Metric
R25: 1M; Res 0402_1005Metric
R26: 0R; Res 0402_1005Metric
U5: W5100S; LQFP48
Y2: 25MHz; Crystal_SMD_Abracon_ABM8G-4Pin_3.2x2.5mm

Connections:
+1V2A: C23.1, FB2.1, U5.4 (1V2A)
+1V2D: C25.1, C26.1, C27.1, C28.1, FB3.2, U5.13 (1V2D), U5.22 (1V2D), U5.31 (1V2D), U5.45 (1V2D)
+1V2O: C24.1, FB2.2, FB3.1, U5.14 (1V2O)
+3.3V: C19.1, C20.1, FB1.1, J2.11 (LEDY-), J2.13 (LEDG-), R12.1, U5.24 (3V3D), U5.36 (3V3D); also elsewhere on the board
+3V3A: C21.1, C22.1, C30.1, C31.1, FB1.2, J2.4 (RCT), J2.9 (TCT), U5.8 (3V3A), U5.15 (3V3A)
+VPoE: MOD1.8 (VCC); also elsewhere on the board
/Ethernet W5100S/ACTn: R22.2, U5.20 (ACTn)
/Ethernet W5100S/LNKn: R21.2, U5.17 (LNKn)
/Ethernet W5100S/RX+: R20.2, U5.6 (RXIP)
/Ethernet W5100S/RX-: R19.2, U5.5 (RXIN)
/Ethernet W5100S/RXI+: J2.5 (RD+), R15.2, R20.1
/Ethernet W5100S/RXI-: J2.3 (RD-), R16.2, R19.1
/Ethernet W5100S/TX+: R18.2, U5.3 (TXOP)
/Ethernet W5100S/TX-: R17.2, U5.2 (TXON)
/Ethernet W5100S/TXO+: J2.10 (TD+), R13.2, R18.1
/Ethernet W5100S/TXO-: J2.8 (TD-), R14.2, R17.1
/Ethernet W5100S/VC1+: J2.7 (VC1+), MOD1.3 (VC1+)
/Ethernet W5100S/VC1-: J2.2 (VC1-), MOD1.4 (VC1-)
/Ethernet W5100S/VC2+: J2.6 (VC2+), MOD1.1 (VC2+)
/Ethernet W5100S/VC2-: J2.1 (VC2-), MOD1.2 (VC2-)
GND: C19.2, C20.2, C21.2, C22.2, C23.2, C24.2, C25.2, C26.2, C27.2, C28.2, C29.2, C30.2, C31.2, C32.2, C33.2, C34.2, C35.2, MOD1.7 (GND), R24.1, U5.1 (GNDA), U5.7 (GNDA), U5.10 (GND), U5.16 (GNDA), U5.23 (GND), U5.25 (MOD0), U5.26 (MOD1), U5.27 (MOD2), U5.28 (MOD3), U5.46 (GND), Y2.2, Y2.4; also elsewhere on the board
INTn: U5.47 (INTn); also elsewhere on the board
unnamed: C29.1, R13.1, R14.1
unnamed: C32.1, R15.1, R16.1
unnamed: C33.1, J2.15 (Shield), J2.16 (Shield)
unnamed: C34.1, R25.2, U5.12 (XSCI), Y2.3
unnamed: C35.1, R26.1, Y2.1
unnamed: J2.12 (LEDY+), R21.1
unnamed: J2.14 (LEDG+), R22.1
unnamed: R23.1, R24.2
unnamed: R23.2, U5.9 (RSET_BG)
unnamed: R25.1, R26.2, U5.11 (XSCO)
RSTn: R12.2, U5.48 (RSTn); also elsewhere on the board
SPI0_CSn: U5.29 (CSn); also elsewhere on the board
SPI0_RX: U5.33 (MISO); also elsewhere on the board
SPI0_SCK: U5.30 (SCLK); also elsewhere on the board
SPI0_TX: U5.32 (MOSI); also elsewhere on the board

Notes on the sheet:
Place the resistor close to the W5100S (U5)
No ground plate under the connector. re: the impedance
Place these components close to the ethernet connector (J2)
Place these components close to the W5100S (U5)
Ethernet interface
Utrecht University Faculty of Geosciences - HPT Lab
PoE Converter Adafruit 3847
Drawn by: Ian Markies
2.7
Place the capacitors close to the W5100S

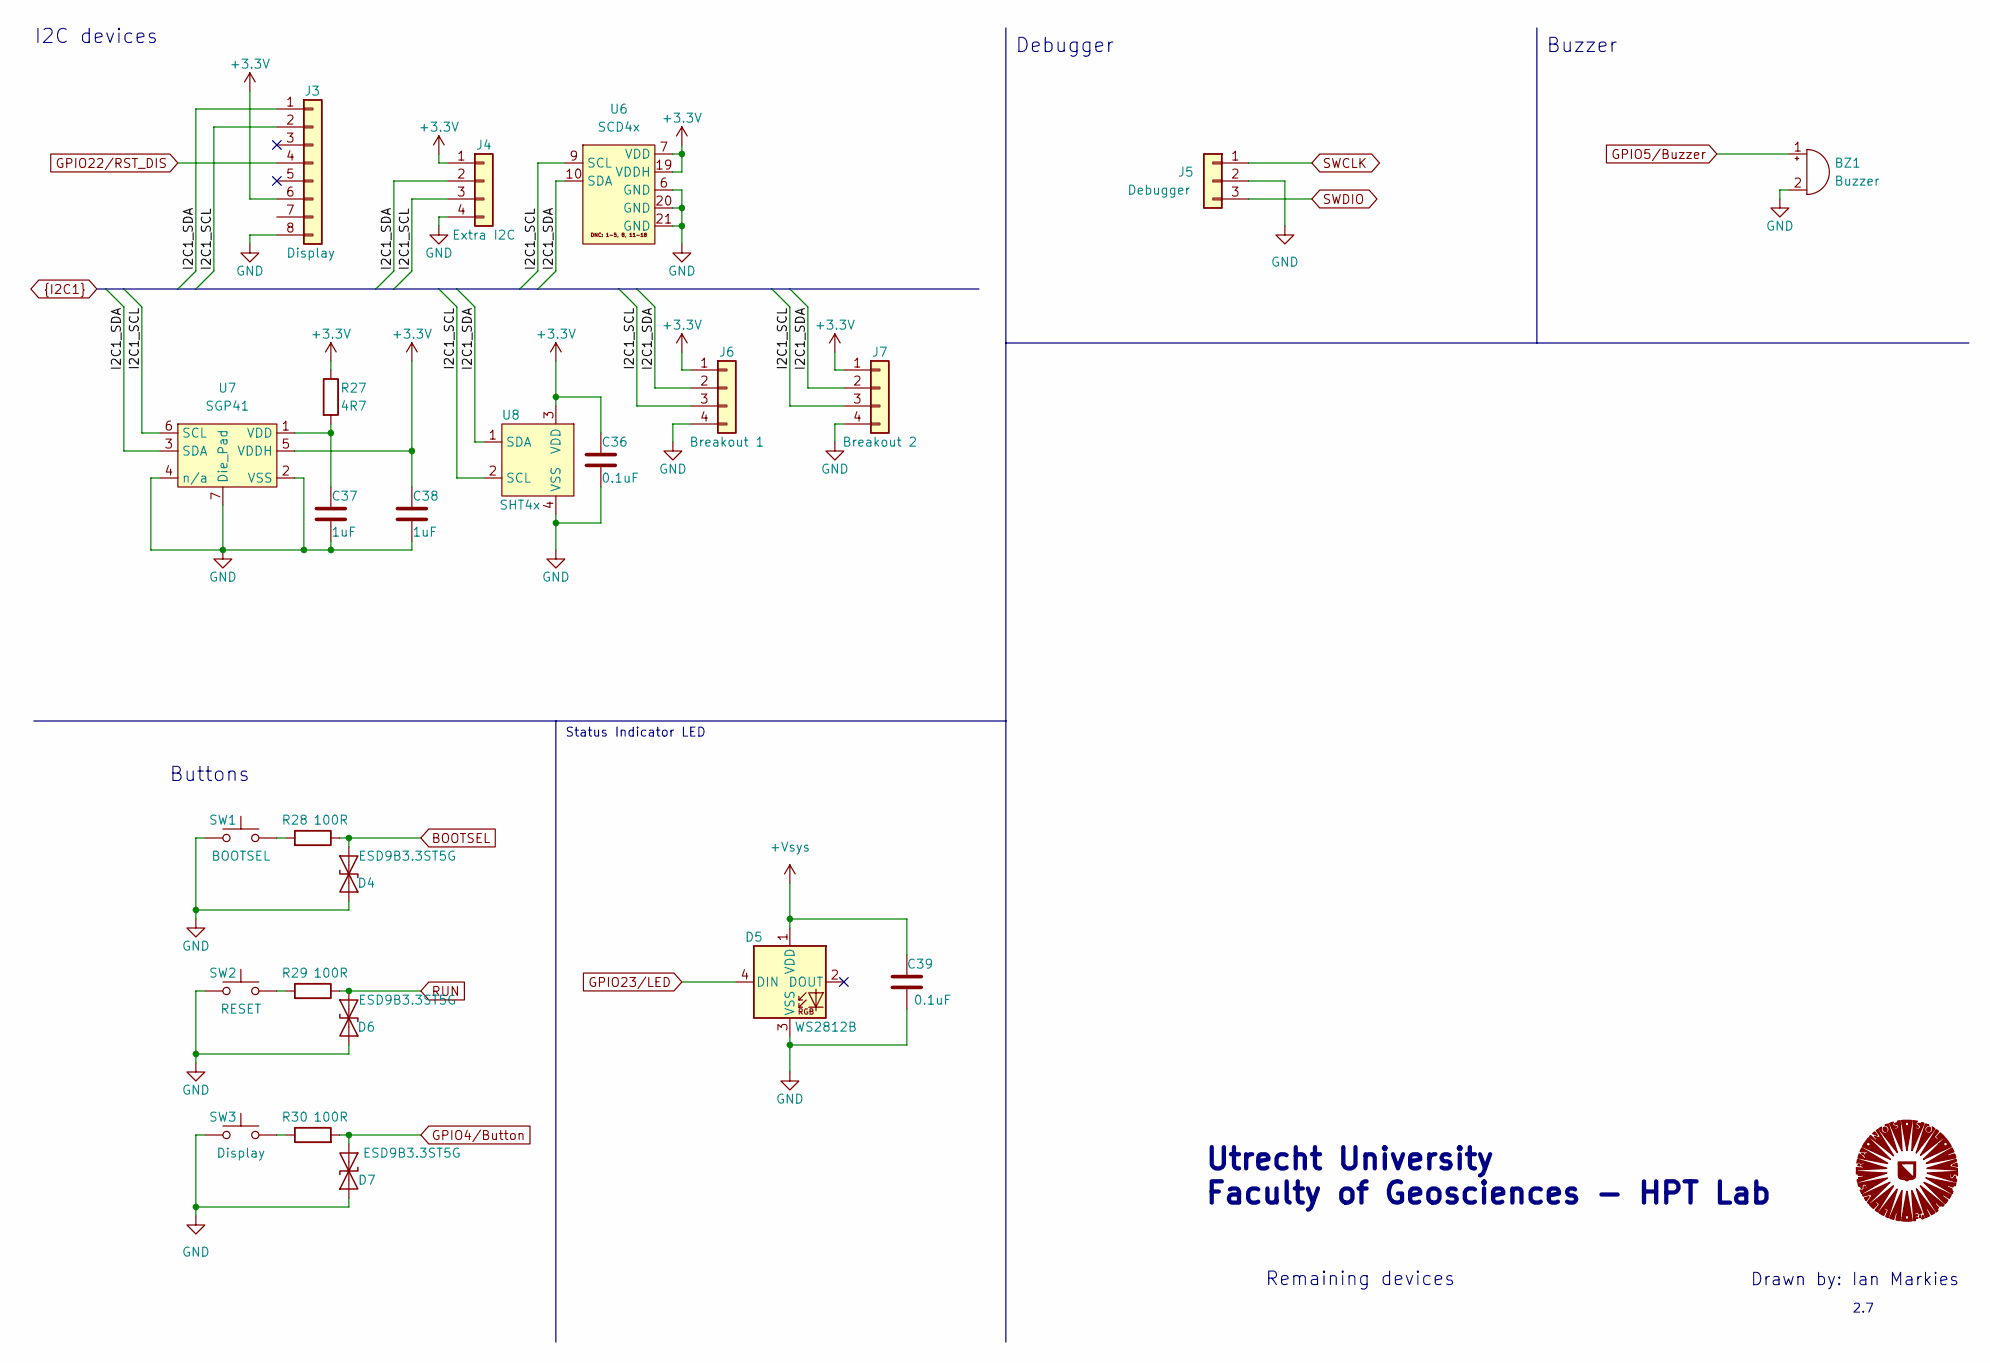
[picture p50: schematic Sensoren.kicad_sch]

Parts:
BZ1: Buzzer; Buzzer_TDK_PS1240P02BT_D12.2mm_H6.5mm
C36, C39: 0.1uF; Cap 0402_1005Metric
C37, C38: 1uF; Cap 0402_1005Metric
D4, D6, D7: ESD9B3.3ST5G; D_SOD-923
D5: WS2812B; LED_WS2812B_PLCC4_5.0x5.0mm_P3.2mm
J3: Display; PinHeader_1x08_P2.54mm_Vertical
J4: Extra I2C; Molex_KK-396_A-41791-0004_1x04_P3.96mm_Vertical
J5: Debugger; PinHeader_1x03_P2.54mm_Vertical
J6: Breakout 1; Molex_KK-396_A-41791-0004_1x04_P3.96mm_Vertical
J7: Breakout 2; Molex_KK-396_A-41791-0004_1x04_P3.96mm_Vertical
R27: 4R7; Res 0402_1005Metric
R28, R29, R30: 100R; Res 0402_1005Metric
SW1: BOOTSEL; Switch
SW2: RESET; Switch
SW3: Display; SW_Push_1P1T_NO_6x6mm_H9.5mm
U6: SCD4x; SDC4x
U7: SGP41; XDCR_SGP41-D-R4
U8: SHT4x; XDCR_SHT41-AD1B-R2

Connections:
+3.3V: C36.2, C38.1, J3.6, J4.1, J6.1, J7.1, R27.1, U6.7 (VDD), U6.19 (VDDH), U7.5 (VDDH), U8.3 (VDD); also elsewhere on the board
+VSYS: C39.1, D5.1 (VDD); also elsewhere on the board
BOOTSEL: D4.1 (A1), R28.1; also elsewhere on the board
GND: BZ1.2 (+), C36.1, C37.2, C38.2, C39.2, D4.2 (A2), D5.3 (VSS), D6.2 (A2), D7.2 (A2), J3.8, J4.4, J5.2, J6.4, J7.4, SW1.1, SW2.1, SW3.2, U6.6 (GND), U6.20 (GND), U6.21 (GND), U7.2 (VSS), U7.4 (n/a), U7.7 (Die_Pad), U8.4 (VSS); also elsewhere on the board
GPIO4/Button: D7.1 (A1), R30.2; also elsewhere on the board
GPIO5/Buzzer: BZ1.1 (-); also elsewhere on the board
GPIO22/RST_DIS: J3.4; also elsewhere on the board
GPIO23/LED: D5.4 (DIN); also elsewhere on the board
I2C1_SCL: J3.2, J4.3, J6.3, J7.3, U6.9 (SCL), U7.6 (SCL), U8.2 (SCL); also elsewhere on the board
I2C1_SDA: J3.1, J4.2, J6.2, J7.2, U6.10 (SDA), U7.3 (SDA), U8.1 (SDA); also elsewhere on the board
unnamed: C37.1, R27.2, U7.1 (VDD)
unnamed: R28.2, SW1.2
unnamed: R29.2, SW2.2
unnamed: R30.1, SW3.1
RUN: D6.1 (A1), R29.1; also elsewhere on the board
SWCLK: J5.1; also elsewhere on the board
SWDIO: J5.3; also elsewhere on the board

Notes on the sheet:
Drawn by: Ian Markies
Status Indicator LED
Utrecht University Faculty of Geosciences - HPT Lab
2.7
I2C devices
Buzzer
Buttons
Debugger
Remaining devices

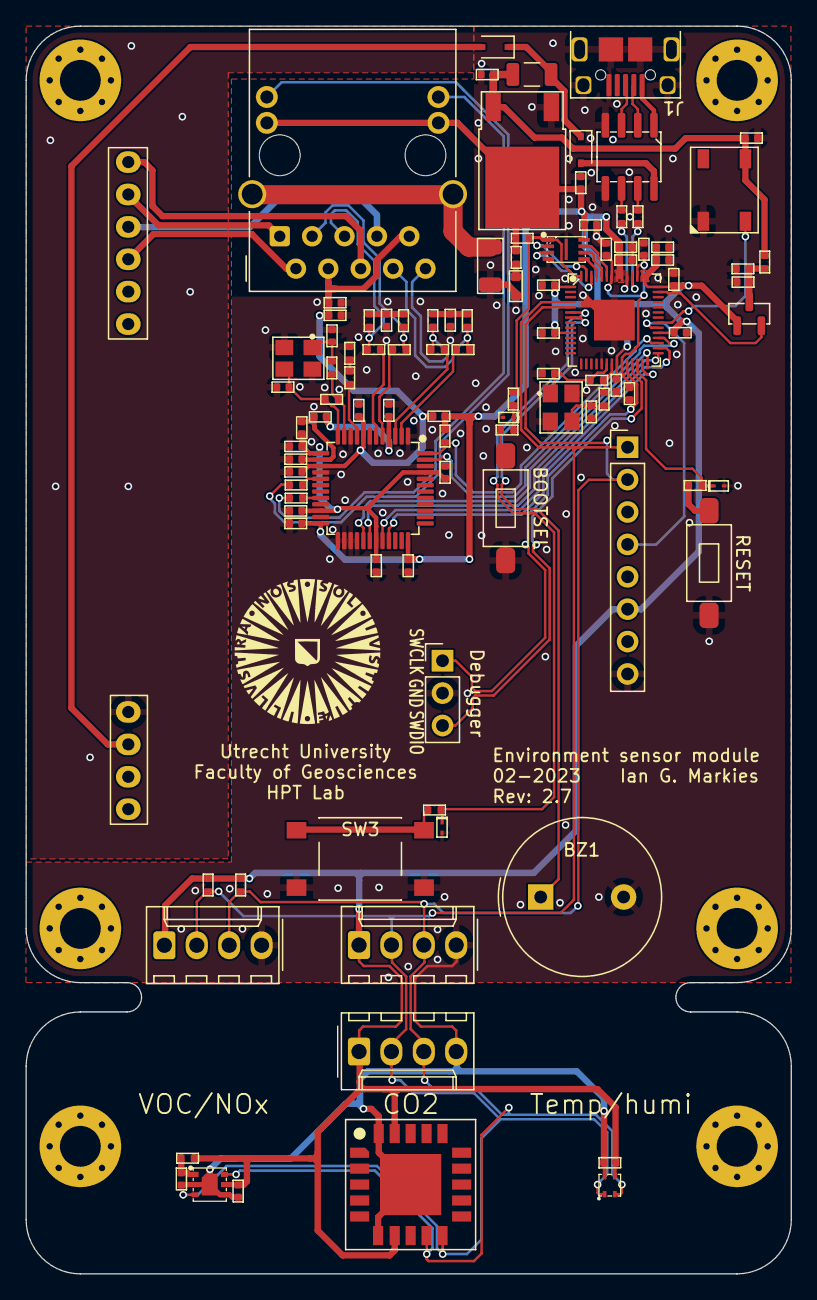
[picture p51: board Meetmodule V3.kicad_pcb from above]

Board: 2 copper layers, 60.0 x 97.8 mm, 103 parts (0 on the bottom side), 74 nets.
