igmarkies/Enviroment-System/Sensor module/Test/sensor_pack/bus_service.py

# micropython
# MIT license
# Copyright (c) 2022 Roman Shevchik   goctaprog@gmail.com
"""service class for I/O bus operation"""

from machine import I2C


class BusAdapter:
    """Proxy between I/O bus and device I/O class"""
    def __init__(self, bus):
        self.bus = bus

    def read_register(self, device_addr: int, reg_addr: int, bytes_count: int) -> bytes:
        """       
        bytes_count - the size of the value in bytes.
        reads value from sensor register.
        device_addr - address of the sensor on the bus.
        reg_addr - register address in the address space of the sensor"""
        raise NotImplementedError

    def write_register(self, device_addr: int, reg_addr: int, value: [int, bytes, bytearray],
                       bytes_count: int, byte_order: str):
        """
        writes value data to the sensor, at reg_addr.
        bytes_count - number of bytes written from value.
        byte_order - the order of bytes in the value being written.
        """
        raise NotImplementedError

    def read(self, device_addr, n_bytes: int) -> bytes:
        raise NotImplementedError

    def write(self, device_addr, buf: bytes):
        raise NotImplementedError


class I2cAdapter(BusAdapter):
    def __init__(self, bus: I2C):
        super().__init__(bus)

    def write_register(self, device_addr: int, reg_addr: int, value: [int, bytes, bytearray],
                       bytes_count: int, byte_order: str):
        """writes value data to the sensor, at reg_addr.
        bytes_count - number of data to be written
        value - must be of type int, bytes, bytearray"""
        buf = None
        if isinstance(value, int):
            buf = value.to_bytes(bytes_count, byte_order)
        if isinstance(value, (bytes, bytearray)):
            buf = value

        return self.bus.writeto_mem(device_addr, reg_addr, buf)

    def read_register(self, device_addr: int, reg_addr: int, bytes_count: int) -> bytes:
        """reads a value from a register.
        bytes_count - value size in bytes"""
        return self.bus.readfrom_mem(device_addr, reg_addr, bytes_count)

    def read(self, device_addr, n_bytes: int) -> bytes:
        """Read nbytes from the peripheral specified by addr. If stop is true then a STOP condition is
        generated at the end of the transfer.
        Returns a bytes object with the data read."""
        return self.bus.readfrom(device_addr, n_bytes)
    
    def read_buf_from_mem(self, device_addr, mem_addr, buf):
        """Reads from device address device_addr into buf, starting at the address in device mem_addr.
        The number of bytes read is determined by the length of the buffer buf"""
        return self.bus.readfrom_mem_into(device_addr, mem_addr, buf)

    def write(self, device_addr, buf: bytes) -> int:
        """Write the bytes from buf to the peripheral specified by addr. If a NACK is received following the write
        of a byte from buf then the remaining bytes are not sent. If stop is true then a STOP condition is generated
        at the end of the transfer, even if a NACK is received.
        The function returns the number of ACKs that were received."""
        return self.bus.writeto(device_addr, buf)

    def write_buf_to_mem(self, device_addr, mem_addr, buf):
        """
        Writes to device address device_addr all the bytes in buf.
        The entry starts at an address in the device: mem_addr."""
        return self.bus.writeto_mem(device_addr, mem_addr, buf)
