igmarkies/Enviroment-System/Sensor module/Test/sensor_pack/crc_mod.py

"""implementation CRC calculation
 8 bit
 polynomial 0x31 (x^8 + x^5 + x^4 + 1)
 initial value 0xFF
 input reflection: no
 output reflection: no
 final XOR: no

 CRC-8 examples:
    Input sequence: 0x01 0x02 0x03
    CRC-8: 0x87
    Input sequence: 0 1 2 3 4 5 6 7 8 9
    CRC-8: 0x52"""


def crc8(sequence, polynomial: int, init_value: int = 0x00) -> int:
    mask = 0xFF
    crc = init_value & mask
    for item in sequence:
        crc ^= item & mask
        for _ in range(8):
            if crc & 0x80:
                crc = mask & ((crc << 1) ^ polynomial)
            else:
                crc = mask & (crc << 1)
    return crc
