igmarkies/Enviroment-System/(commit log)

2023-08-22 Adding the PCB files
    [Ethernet.kicad_sch, MCU.kicad_sch, Meetmodule V2.csv, Meetmodule V2.kicad_pcb, Meetmodule V2.kicad_sch, Meetmodule V3.csv, Meetmodule V3.kicad_pcb, Meetmodule V3.kicad_sch]
2023-08-23 Add created flowcharts
